ilomon10/embedded-totalizer-hour-meter/esp32/README.md

# Hour Meter Firmware (ESP32)

Engine hour meter and totalizer with persistent storage, real-time clock, and an IMU for vibration, orientation and compass heading. It talks to apps over USB or UART using compact [SensorFrame](../sensorframe/README.md) binary frames.

| You are… | Read |
|---|---|
| Building an app that talks to the device | **[docs/INTEGRATION-GUIDE.md](docs/INTEGRATION-GUIDE.md)** (self-contained, send it to third parties together with [SPEC.md](../sensorframe/SPEC.md)) |
| Writing a driver and need exact bytes | [docs/FRAME-CATALOG.md](docs/FRAME-CATALOG.md) (every frame, annotated hex dumps) |
| Developing without hardware | [simulator/](../simulator/README.md): a fake device on a virtual serial port (`cd ../simulator && bun run start`) |
| Wiring the hardware | [docs/WIRING.md](docs/WIRING.md) |
| Using the main board | the `can-board` build (below) and the board's [BRINGUP.md](../schematic/hour-meter-board/BRINGUP.md) |
| Working on the firmware | [docs/ARCHITECTURE.md](docs/ARCHITECTURE.md), [docs/CODING-STANDARD.md](docs/CODING-STANDARD.md) |
| A TypeScript developer new to C++ | [docs/CPP-FOR-TYPESCRIPT.md](docs/CPP-FOR-TYPESCRIPT.md) |
| Curious how data survives power cuts | [docs/STORAGE.md](docs/STORAGE.md), [docs/EEPROM-LAYOUT.md](docs/EEPROM-LAYOUT.md) |
| Setting up the IMU | [docs/CALIBRATION.md](docs/CALIBRATION.md) |
| Testing modules before soldering | [docs/TESTING-MODULES.md](docs/TESTING-MODULES.md) (bench firmware: `pio run -e bench -t upload`) |
| Configuring / watching the device | `hour-meter` TUI (`cd ../configurator && bun run start`, or `--demo` without hardware), see [configurator/README.md](../configurator/README.md) |

## Hardware

**Devboard** ([schematic](../schematic/hour-meter-devboard/README.md)), the default `esp32dev` build: ESP32 DevKit · AT24C256 EEPROM (0x50) · DS3231 RTC (0x68) · MPU9250 IMU (**0x69**, AD0 high) · alternator input GPIO27 · pulse input GPIO26 · UART GPIO16/17 · Bluetooth Classic SPP (off by default, PIN-locked).

**Main board** ([schematic](../schematic/hour-meter-board/README.md)): the same firmware, built with `-e can-board`. The UART link runs on its RS232 port (GPIO32 TX, GPIO34 RX), the GPS socket's GPIO16/17 are left alone, and the IMU readings are turned 180° into the board's axes. Its CAN, RS485, GPS, AIN1, DOUT1 and LIS3MDL compass are not used yet. Both boards' pins are in [include/BoardPins.h](include/BoardPins.h).

## Build, flash, run

```bash
cd esp32
pio run -e esp32dev -t upload      # build + flash (the devboard: ESP32 DevKit)
pio run -e can-board -t upload     # the same, for the main board
cd ../configurator                 # or use the hour-meter release binary
bun install                        # once
bun run start read /dev/ttyUSB0    # live view
bun run start set-time             # set the RTC from the PC clock (UTC)
bun run start get hour             # read the hour meter
bun run start                      # full-screen configurator + live viewer
```

Expected reader output:

```
2026-10-07T12:34:56.000Z #12 engine ON  run 1250.00 h total 15000 roll 0.4° pitch -1.2° heading 87.5° vib 35/120 mg
```

More commands: `hour-meter --help` (see [configurator/README.md](../configurator/README.md)).

## Test and check

```bash
pio test -e native           # unit tests on the PC with fake chips (ASan + UBSan)
pio check -e esp32dev        # clang-tidy static analysis
./scripts/check-docs.ts      # docs, host tag table and firmware tables agree; reference decoders work
cd ../configurator && bun run test     # host tool tests
```

## Project map

```
esp32/
├── platformio.ini        envs: esp32dev and can-board (firmware), bench, native (tests); strict warnings
├── include/              BoardPins.h (pins, I2C addresses, IMU mounting; per board) · AppConfig.h (fixed constants)
├── src/                  main.cpp · Application (wiring + main loop) · platform/ (Arduino adapters)
├── lib/
│   ├── Core/             Status, Result<T>, CHECK_ARG/TRY, IClock, PeriodicTask, Vec3
│   ├── I2cBus/           II2cBus interface + Wire implementation (timeouts, bus recovery)
│   ├── At24c/            EEPROM driver
│   ├── Ds3231/           RTC driver + UTC date math
│   ├── Mpu9250/          IMU + magnetometer driver
│   ├── Filters/          Kalman, compass, vibration, running stats
│   ├── Storage/          counter journal + settings A/B in EEPROM and in flash (FlashStore), StorageMirror
│   └── App/              protocol tags, settings schema, hour meter, IMU pipeline, commands, telemetry
├── test/                 fakes/ + test_drivers, test_storage, test_filters, test_app
├── scripts/check-docs.ts consistency checker (Bun)
└── docs/                 guides listed above
```
