ilomon10/embedded-totalizer-hour-meter/schematic/fault-analysis/plots/lm2596-pulse1.png

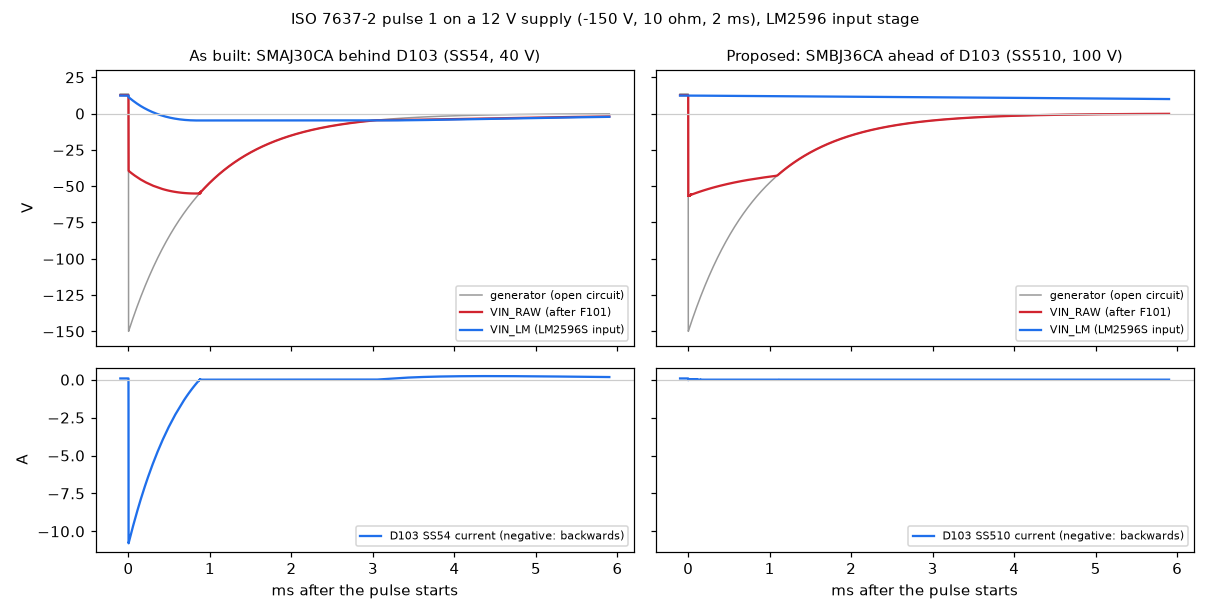
schematic/fault-analysis/plots/lm2596-pulse1.png
