ilomon10/embedded-totalizer-hour-meter/schematic/fault-analysis/plots/load-dump.png

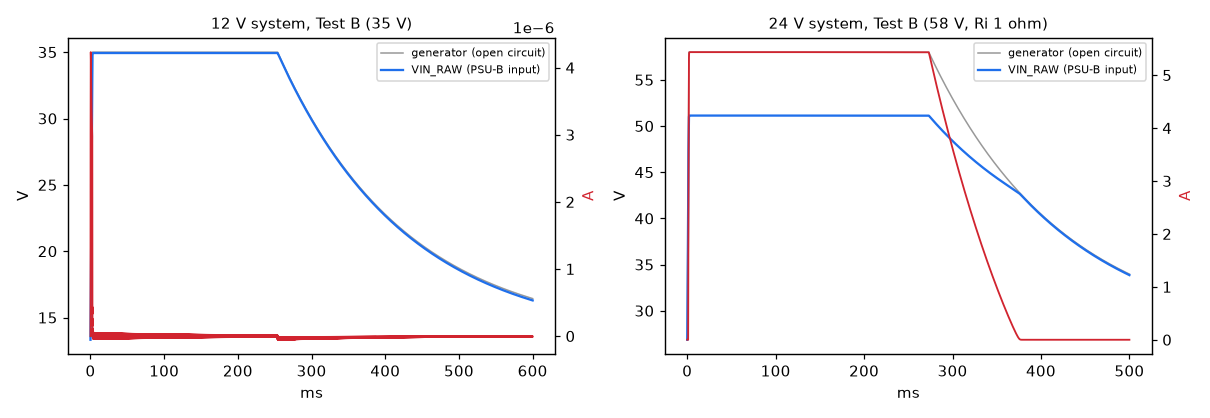
schematic/fault-analysis/plots/load-dump.png
