ilomon10/embedded-totalizer-hour-meter/schematic/fault-analysis/plots/opto-input.png

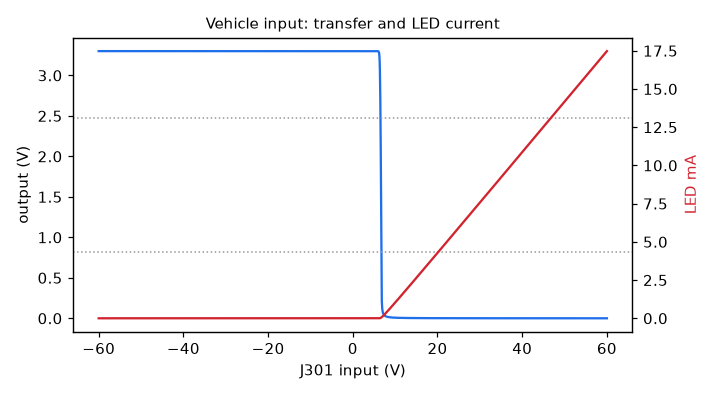
schematic/fault-analysis/plots/opto-input.png
