ilomon10/embedded-totalizer-hour-meter/schematic/hour-meter-devboard/hour-meter-devboard.png

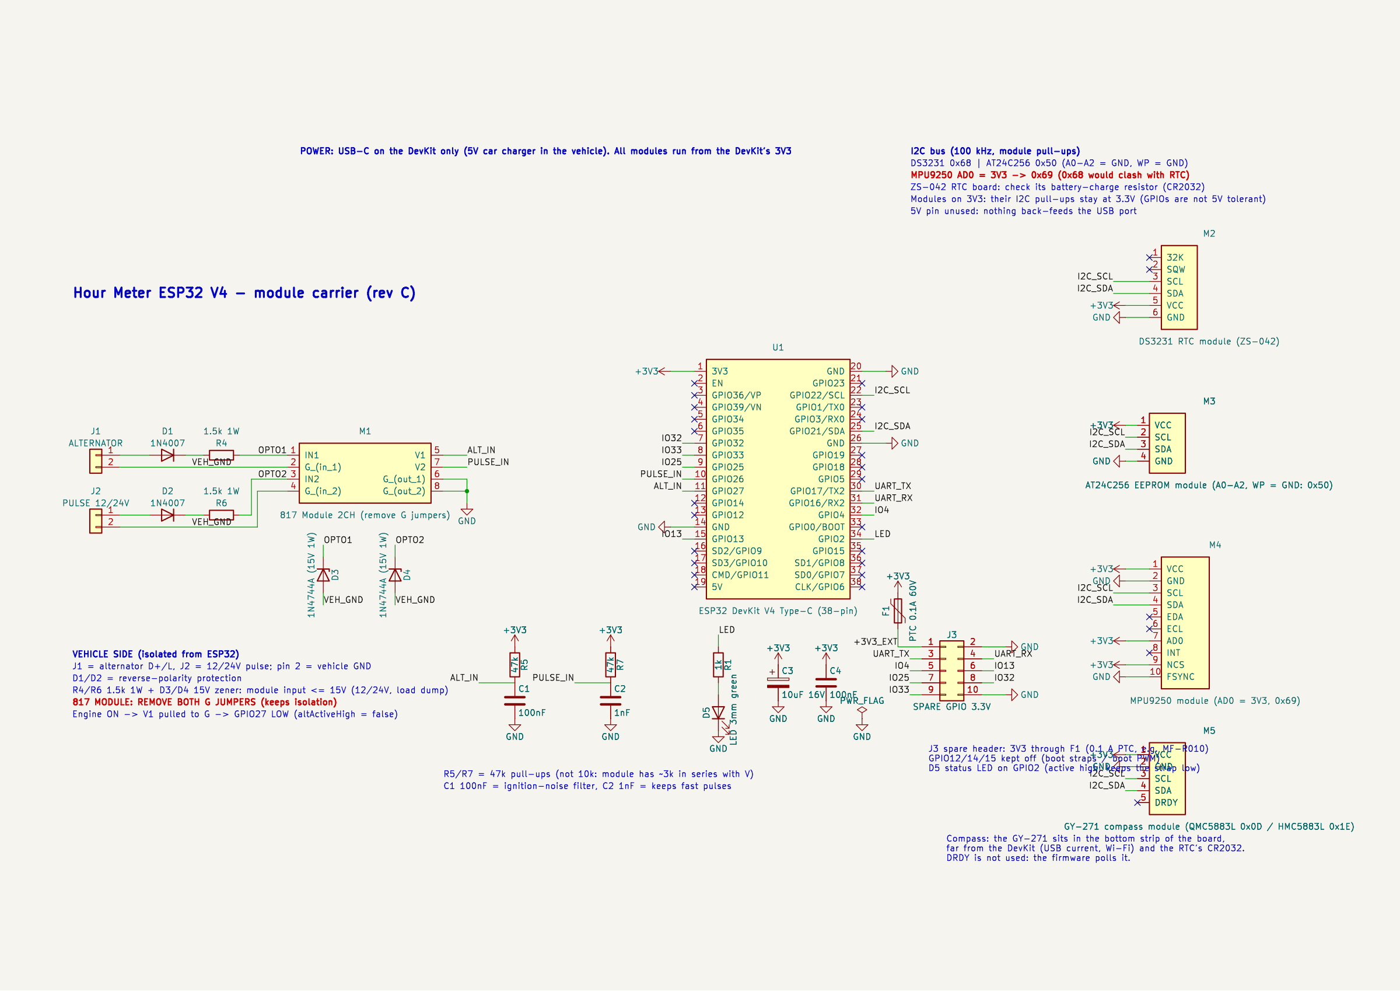
schematic/hour-meter-devboard/hour-meter-devboard.png
