ilomon10/embedded-totalizer-hour-meter/schematic/hour-meter-devboard/production/hour-meter-devboard-lcsc-parts.csv

References | Qty per board | LCSC C-number | Manufacturer | MPN | Key specs (pitch, size, rating) | LCSC stock (date seen) | MOQ | Order multiple | Unit price USD at that quantity | Qty to order for 5 boards | Line cost USD | LCSC URL | Fit note (footprint check)
C1, C4 | 2 | C342794 | TDK | FG28X7R1H104KNT06 | 100 nF 50 V X7R radial MLCC, 5.0 mm pitch; body 4.0 x 5.5 x 2.5 mm max; 0.5 mm leads | 6935 (2026-11-04) | 5 | 5 | 0.1213 | 10 | 1.21 | https://www.lcsc.com/product-detail/C342794.html | Fits C_Disc P5.00 (0.8 mm holes). Body 5.5 mm max, about 6 mm seated: fits under the DevKit (about 8 mm free)
C2 | 1 | C2170624 | VISHAY | K102J15C0GF5TH5 | 1 nF 50 V C0G radial MLCC, 5.0 mm pitch; size 15 (4.0 x 4.0 x 2.6 mm max), flat-crimp leads 0.5 mm | 11795 (2026-11-04) | 5 | 5 | 0.1236 | 5 | 0.62 | https://www.lcsc.com/product-detail/C2170624.html | Fits C_Disc P5.00. Max seated height 6.6 mm: fits under the DevKit
C3 | 1 | C216293 | huawei group | RL1E100MC110A00CV0 | 10 uF 25 V aluminium electrolytic, 105 C 2000 h, 5 x 11 mm, 2.0 mm pitch | 47380 (2026-11-04) | 20 | 20 | 0.0216 | 20 | 0.43 | https://www.lcsc.com/product-detail/C216293.html | Exact match for CP_Radial_D5.0mm_P2.00mm. 11 mm tall: must stay outside every module outline
D1, D2 | 2 | C106903 | ST(Semtech) | 1N4007 | 1N4007, 1 kV 1 A, DO-41 | 387380 (2026-11-04) | 20 | 20 | 0.0263 | 20 | 0.53 | https://www.lcsc.com/product-detail/C106903.html | DO-41 on the 10.16 mm footprint; leads 0.71-0.86 mm in 1.1 mm holes
D3, D4 | 2 | C238928 | onsemi | 1N4744A | 1N4744A zener 15 V 1 W, DO-41 glass | 6070 (2026-11-04) | 10 | 10 | 0.1019 | 10 | 1.02 | https://www.lcsc.com/product-detail/C238928.html | DO-41 footprint fits. onsemi part: its IZSM 304 mA rating is the one the fault analysis uses
D5 | 1 | C85161 | EVERLIGHT | 204-10SYGD/S530-E3 | 3 mm LED, yellow-green 573 nm, green diffused lens, Vf 2.0 V, 2.54 mm leads | 41540 (2026-11-04) | 20 | 20 | 0.0365 | 20 | 0.73 | https://www.lcsc.com/product-detail/C85161.html | Fits LED_D3.0mm. GaP LED: about 1.4 mA from GPIO2 through R1 (1k). A 3.2 V InGaN 'emerald green' LED would barely light at 3.3 V
F1 | 1 | C89660 | BOURNS | MF-R010 | PTC resettable fuse 100 mA hold / 200 mA trip, 60 V; radial 5.1 +/-0.7 mm; leads 0.51 mm; 7.4 W x 12.7 H x 3.1 T mm max | 2145 (2026-11-04) | 5 | 5 | 0.1277 | 5 | 0.64 | https://www.lcsc.com/product-detail/C89660.html | Fits PTC_Radial_P5.00mm (0.9 mm holes). 12.7 mm tall: keep outside module outlines
R1 | 1 | C172895 | YAGEO | MFR-12FTE52-1K | 1 kohm 1 % metal film, 1/6 W (167 mW), body D1.9 x L3.4 mm | 3300 (2026-11-04) | 100 | 100 | 0.0081 | 100 | 0.81 | https://www.lcsc.com/product-detail/C172895.html | Easy bend on the 7.62 mm DIN0207 footprint; dissipates about 2 mW. A 1/4 W MFR-25 (6.3 +/-0.5 mm body) leaves only 0.4-0.9 mm per side for the bend
R4, R6 | 2 | C2903196 | VO | MF1W-1K5±1%-TT63 | 1.5 kohm 1 % 1 W metal film, D4.5 x L11 mm, 0.6 mm leads | 13080 (2026-11-04) | 20 | 20 | 0.0335 | 20 | 0.67 | https://www.lcsc.com/product-detail/C2903196.html | Fits R_Axial_DIN0414 P15.24 (1.2 mm holes), 2 mm per side for the bend
R5, R7 | 2 | C172905 | YAGEO | MFR-12FTE52-47K | 47 kohm 1 % metal film, 1/6 W, body D1.9 x L3.4 mm | 4950 (2026-11-04) | 50 | 50 | 0.0095 | 50 | 0.47 | https://www.lcsc.com/product-detail/C172905.html | Same fit as R1; dissipates 0.23 mW (pull-up)
J1, J2 | 2 | C474952 | Cixi Kefa Elec | KF128-5.08-2P-AA | 2-pin screw terminal, 5.08 mm pitch, horizontal wire entry, 2.5 mm2 / 12-22 AWG, 14.1 mm tall, pins 0.9 x 0.8 mm | 51950 (2026-11-04) | 5 | 5 | 0.1948 | 10 | 1.95 | https://www.lcsc.com/product-detail/C474952.html | True 5.08 mm pitch. Pins (1.2 mm across corners) enter the footprint's 1.3 mm holes; Kefa asks for 1.4 mm, so it is snug. Body 10.7 mm deep vs 9.8 mm on the MKDS footprint. Exact original: Phoenix MKDS 1,5/ 2-5,08 = C5183929 (about $0.41 each). KF301-5.0-2P C474881 also fits (1.0 mm round pins, 5.0 mm pitch)
J3 | 1 | C42431818 | JXTCONN | PZ2.54-2X5P-H25 | 2x5 male pin header, 2.54 mm, straight, 6 mm mating pins | 24230 (2026-11-04) | 10 | 10 | 0.0538 | 10 | 0.54 | https://www.lcsc.com/product-detail/C42431818.html | Fits PinHeader_2x05_P2.54mm (1.0 mm holes)
U1 sockets | 2 | C2932678 | kinghelm | KH-2.54FH-1X19P-H8.5 | 1x19 female header, 2.54 mm, 8.5 mm tall | 1970 (2026-11-04) | 5 | 5 | 0.1935 | 10 | 1.94 | https://www.lcsc.com/product-detail/C2932678.html | Exact 19 pins, nothing to cut; 8.5 mm height as the README assumes
M2 socket | 1 | C40877 | BOOMELE(Boom Precision Elec) | 2.54-1*6P | 1x6 female header, 2.54 mm, 8.5 mm tall | 71490 (2026-11-04) | 5 | 5 | 0.0892 | 5 | 0.45 | https://www.lcsc.com/product-detail/C40877.html | 8.5 mm height
M3 socket | 1 | C2905415 | kinghelm | KH-2.54FH-1X4P-H8.5 | 1x4 female header, 2.54 mm, 8.5 mm tall | 1150 (2026-11-04) | 5 | 5 | 0.0843 | 5 | 0.42 | https://www.lcsc.com/product-detail/C2905415.html | 8.5 mm height
M4 socket | 1 | C2905418 | kinghelm | KH-2.54FH-1X10P-H8.5 | 1x10 female header, 2.54 mm, 8.5 mm tall | 8300 (2026-11-04) | 5 | 5 | 0.1275 | 5 | 0.64 | https://www.lcsc.com/product-detail/C2905418.html | 8.5 mm height
M5 socket | 1 | C42431843 | JXTCONN | PM2.54-1X5PM-H85 | 1x5 female header, 2.54 mm, 8.5 mm tall | 1390 (2026-11-04) | 5 | 5 | 0.0999 | 5 | 0.50 | https://www.lcsc.com/product-detail/C42431843.html | 8.5 mm height (Kinghelm's 1x5 is out of stock)
Module headers (M2, M3) | 1 | C2337 | BOOMELE(Boom Precision Elec) | 2.54-1*40P | 1x40 male pin header, 2.54 mm, straight, 6 mm mating pins | 60075 (2026-11-04) | 5 | 5 | 0.1607 | 5 | 0.80 | https://www.lcsc.com/product-detail/C2337.html | Cut 6 + 4 per board
M1 standoffs | 4 | C123697 | HIWA | HP-12M3*12 | Nylon hex standoff M3 female-female, 12 mm, 5.5 mm hex | 60 (2026-11-04) | 20 | 20 | 0.0229 | 20 | 0.46 | https://www.lcsc.com/product-detail/C123697.html | 12 mm is inside the README's 10-12 mm. Two PF3-6N screws per standoff; no nuts needed. Low stock (60)
M1 standoff screws | 8 | C194617 | HIWA | PF3-6N（M3*6) | Nylon M3 x 6 pan-head screw | 5760 (2026-11-04) | 20 | 20 | 0.0156 | 40 | 0.62 | https://www.lcsc.com/product-detail/C194617.html | 8 per board: both ends of each M1 standoff. The optional M4 standoffs need 2 more per board
D3, D4 (option) | 2 | C10184 | RUILON | P6KE18A | P6KE18A TVS 600 W unidirectional, DO-15: body 5.8-7.6 mm, leads 0.70-0.90 mm | 1985 (2026-11-04) | 5 | 5 | 0.0866 | 10 | 0.87 | https://www.lcsc.com/product-detail/C10184.html | OPTIONAL, only for old 24 V trucks without load-dump clamp. Leads fit the 1.1 mm holes; a 7.6 mm body leaves 1.3 mm per side on 10.16 mm pitch, so bend close to the body. Littelfuse C151208 does NOT fit (leads up to 1.09 mm, body up to 8.9 mm)
M4 standoffs (option) | 2 | C118174 | HIWA | TP-11 | Nylon hex standoff M3 male-female, 11 mm + 6 mm stud | 3140 (2026-11-04) | 20 | 20 | 0.0248 | 20 | 0.50 | https://www.lcsc.com/product-detail/C118174.html | OPTIONAL (holds the GY-9250 rigid). 11 mm = 8.5 mm socket + 2.5 mm header. Stud through the board, PN-3 nut underneath
M4 nuts (option) | 2 | C115937 | HIWA | PN-3 | Nylon 66 hex nut M3, 5.6 mm across flats | 20 (2026-11-04) | 20 | 20 | 0.0144 | 20 | 0.29 | https://www.lcsc.com/product-detail/C115937.html | OPTIONAL, for the TP-11 studs. LCSC holds only 20
CR2032 coin cell | 1 |  |  |  |  |  |  |  |  |  |  |  | Not on LCSC: only CR2032 holders are listed, no cells, and lithium cells are restricted for air freight. Buy locally
Hook-up wire 22-24 AWG, about 30 cm | 1 |  |  |  |  |  |  |  |  |  |  |  | Buy locally. LCSC sells wire only through its cable-assembly service
Enclosure screws H1, H3, H4 (+ H2 if kept) | 4 |  |  |  |  |  |  |  |  |  |  |  | Depends on the box. Buy locally, nylon or brass; HIWA PF3-8N nylon M3 x 8 (C194618, 1020 in stock) is an LCSC option
Modules U1, M1-M5 | 1 |  |  |  |  |  |  |  |  |  |  |  | Tokopedia/Shopee. LCSC has no clone modules. Espressif's own DevKitC boards are out of stock, or the 32UE needing an external antenna
TOTAL required, 5 boards |  |  |  |  |  |  |  |  |  |  | 15.45 |  | LCSC list prices seen 2026-11-04, before shipping
TOTAL optional lines |  |  |  |  |  |  |  |  |  |  | 1.66 |  | P6KE18A instead of D3/D4 (old 24 V trucks), GY-9250 standoffs + nuts; add 20 more M3x6 screws for the standoffs
