ilomon10/embedded-totalizer-hour-meter/schematic/hour-meter-board/production/BOM-hour-meter-board.csv

Comment | Designator | Footprint | LCSC | Qty
CR2032 | BT401 | Battery:BatteryHolder_MYOUNG_BS-07-A1BJ001_CR2032 | C2979167 | 1
100nF | C101,C105,C202,C204,C207,C301,C401,C402,C501,C601,C603,C605,C606,C701,C802,C902,C903,C904,C1001,C1002,C1101,C1102,C1103,C1105 | Capacitor_SMD:C_0603_1608Metric | C14663 | 24
220uF 50V | C102 | Capacitor_SMD:CP_Elec_10x10 | C2887271 | 1
100nF 50V | C103 | Capacitor_SMD:C_0603_1608Metric | C14663 | 1
220uF 16V | C104 | Capacitor_SMD:CP_Elec_6.3x7.7 | C2887273 | 1
10uF 25V | C201,C205 | Capacitor_SMD:C_0805_2012Metric | C15850 | 2
1uF | C203,C208,C604,C1104 | Capacitor_SMD:C_0603_1608Metric | C15849 | 4
22uF | C206 | Capacitor_SMD:C_0805_2012Metric | C45783 | 1
1nF | C302 | Capacitor_SMD:C_0603_1608Metric | C1588 | 1
10nF | C602 | Capacitor_SMD:C_0603_1608Metric | C57112 | 1
10nF 1kV | C901 | Capacitor_SMD:C_1206_3216Metric | C9194 | 1
SS34 | D101 | Diode_SMD:D_SMA | C8678 | 1
1N4148W | D102 | Diode_SMD:D_SOD-123 | C81598 | 1
SS54 | D103,D105 | Diode_SMD:D_SMA | C22452 | 2
SMAJ30CA | D104 | Diode_SMD:D_SMA | C110043 | 1
PWR red | D106 | LED_SMD:LED_0603_1608Metric | C2286 | 1
B5819W | D201 | Diode_SMD:D_SOD-123 | C8598 | 1
PWR (red) | D202 | LED_SMD:LED_0603_1608Metric | C2286 | 1
STATUS (yellow) | D203 | LED_SMD:LED_0603_1608Metric | C2287 | 1
M7 | D301,D303 | Diode_SMD:D_SMA | C82443 | 2
BZT52C4V7S | D302,D304 | Diode_SMD:D_SOD-323 | C22611 | 2
SZNUP3105LT1G | D701,D1001 | Package_TO_SOT_SMD:SOT-23 | C233434 | 2
P1 (green) | D801 | LED_SMD:LED_Kingbright_APA1606_1.6x0.6mm_Horizontal | C364567 | 1
P2 (green) | D802 | LED_SMD:LED_Kingbright_APA1606_1.6x0.6mm_Horizontal | C364567 | 1
USER (green) | D803 | LED_SMD:LED_Kingbright_APA1606_1.6x0.6mm_Horizontal | C364567 | 1
BAV99 | D901 | Package_TO_SOT_SMD:SOT-23 | C68983 | 1
0.5A 60V | F101 | Fuse:Fuse_1812_4532Metric | C19078719 | 1
0.5A 6V | F201 | Fuse:Fuse_1206_3216Metric | C69688 | 1
0.2A | F801,F803 | Fuse:Fuse_1206_3216Metric | C20984 | 2
Micro-Fit 3.0 2x8 | J1 | Connector_Molex:Molex_Micro-Fit_3.0_43045-1600_2x08_P3.00mm_Horizontal | C277731 | 1
USB-C | J201 | Connector_USB:USB_C_Receptacle_HRO_TYPE-C-31-M-12 | C165948 | 1
GPS (GH 6-pin) | J802 | Connector_JST:JST_GH_SM06B-GHS-TB_1x06-1MP_P1.25mm_Horizontal | C133065 | 1
QWIIC | J803 | Connector_JST:JST_SH_SM04B-SRSS-TB_1x04-1MP_P1.00mm_Horizontal | C160404 | 1
33uH 3A | L101 | Inductor_SMD:L_12x12mm_H8mm | C9400 | 1
MMBT3904 | Q201,Q202 | Package_TO_SOT_SMD:SOT-23 | C20526 | 2
100k | R101 | Resistor_SMD:R_1206_3216Metric | C17900 | 1
5.6k | R102 | Resistor_SMD:R_0603_1608Metric | C23189 | 1
3.3k | R103 | Resistor_SMD:R_0603_1608Metric | C22978 | 1
1k | R104,R209,R210 | Resistor_SMD:R_0603_1608Metric | C21190 | 3
2.2k | R105 | Resistor_SMD:R_0603_1608Metric | C4190 | 1
10k | R201,R202,R205,R206,R401,R501,R701,R702,R703 | Resistor_SMD:R_0603_1608Metric | C25804 | 9
470R | R203,R204 | Resistor_SMD:R_0603_1608Metric | C23179 | 2
5.1k | R207,R208 | Resistor_SMD:R_0603_1608Metric | C23186 | 2
4.7k | R211,R212,R304,R309 | Resistor_SMD:R_0603_1608Metric | C23162 | 4
0R | R213 | Resistor_SMD:R_0603_1608Metric | C21189 | 1
1k | R301,R302,R303,R306,R307,R308 | Resistor_SMD:R_1206_3216Metric | C4410 | 6
22k | R305,R310 | Resistor_SMD:R_0603_1608Metric | C31850 | 2
120R | R704,R1001 | Resistor_SMD:R_0805_2012Metric | C17437 | 2
330R | R705,R706,R808,R809,R810 | Resistor_SMD:R_0603_1608Metric | C23138 | 5
100R | R803,R804,R805 | Resistor_SMD:R_0603_1608Metric | C22775 | 3
100k | R806,R807,R905 | Resistor_SMD:R_0603_1608Metric | C25803 | 3
49.9k 0.1% | R901,R902 | Resistor_SMD:R_1206_3216Metric | C706414 | 2
10k 0.1% | R903 | Resistor_SMD:R_0603_1608Metric | C95204 | 1
RESET | SW201 | Button_Switch_SMD:SW_Push_1P1T_XKB_TS-1187A | C318884 | 1
BOOT | SW202 | Button_Switch_SMD:SW_Push_1P1T_XKB_TS-1187A | C318884 | 1
LM2596S-ADJ | U101 | Package_TO_SOT_SMD:TO-263-5_TabPin3 | C347423 | 1
ESP32-WROOM-32E-N4 | U201 | RF_Module:ESP32-WROOM-32E | C701341 | 1
CH340C | U202 | Package_SO:SOIC-16_3.9x9.9mm_P1.27mm | C84681 | 1
USBLC6-2SC6 | U203 | Package_TO_SOT_SMD:SOT-23-6 | C7519 | 1
AMS1117-3.3 | U204 | Package_TO_SOT_SMD:SOT-223-3_TabPin2 | C6186 | 1
PC817C-S | U301,U302 | Package_DIP:SMDIP-4_W9.53mm | C3008369 | 2
DS3231MZ+TRL | U401 | Package_SO:SOIC-8_3.9x4.9mm_P1.27mm | C107410 | 1
AT24C256C-SSHL-T | U501 | Package_SO:SOIC-8_3.9x4.9mm_P1.27mm | C6482 | 1
MPU-6500 | U601 | Sensor_Motion:InvenSense_QFN-24_3x3mm_P0.4mm | C50278 | 1
LIS3MDLTR | U602 | Package_LGA:LGA-12_2x2mm_P0.5mm | C478483 | 1
THVD2410DR | U701 | Package_SO:SOIC-8_3.9x4.9mm_P1.27mm | C1849398 | 1
SRV05-4 | U802 | Package_TO_SOT_SMD:SOT-23-6 | C85364 | 1
ADS1115IDGST | U901 | Package_SO:TSSOP-10_3x3mm_P0.5mm | C468683 | 1
SN74AHCT1G125DBVR | U902 | Package_TO_SOT_SMD:SOT-23-5 | C7484 | 1
BSP75N | U903 | Package_TO_SOT_SMD:SOT-223 | C172450 | 1
TJA1051T/3 | U1001 | Package_SO:SOIC-8_3.9x4.9mm_P1.27mm | C38695 | 1
MAX13223E | U1101 | Package_SO:TSSOP-20_4.4x6.5mm_P0.65mm | C118523 | 1
