ilomon10/embedded-totalizer-hour-meter/schematic/hour-meter-devboard/hour-meter-devboard.pdf

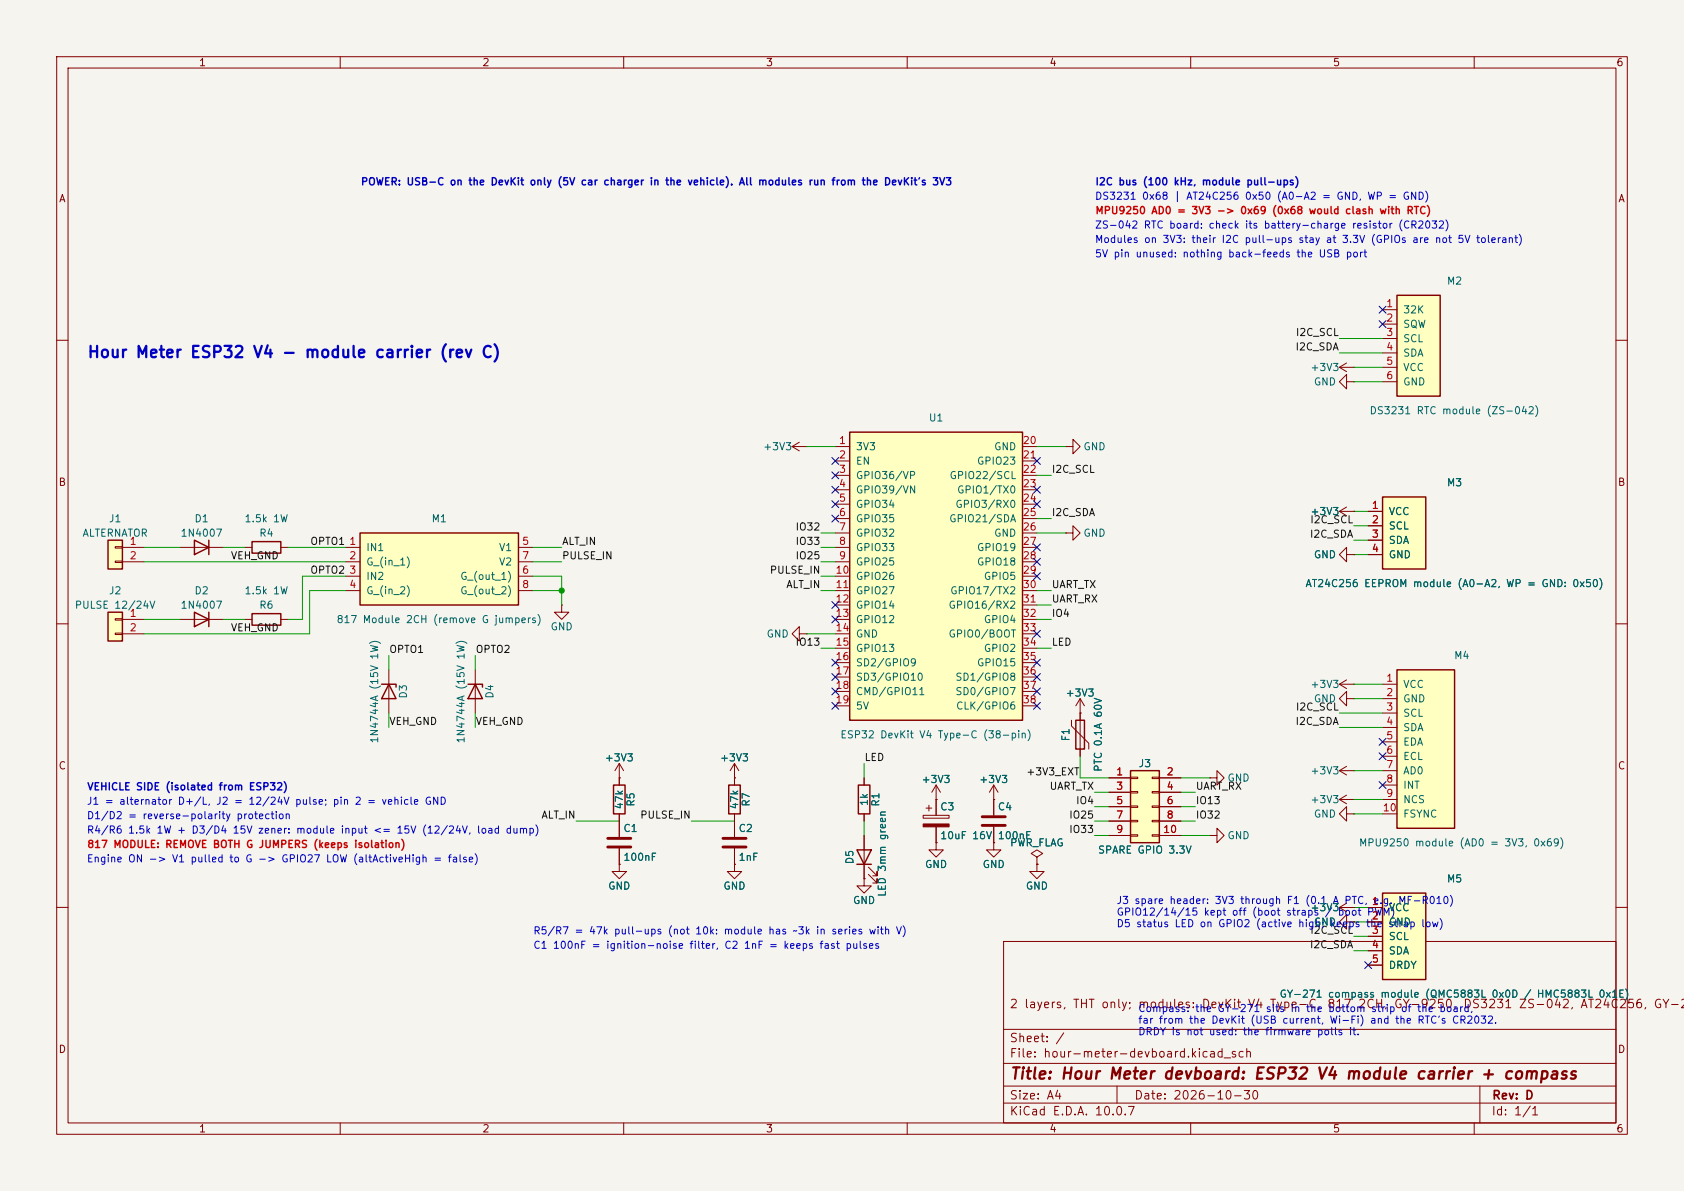
[picture p11: page 1]

ZS-042 RTC board: check its battery-charge resistor (CR2032) DS3231 0x68 | AT24C256 0x50 (A0-A2 = GND, WP = GND) MPU9250 AD0 = 3V3 -> 0x69 (0x68 would clash with RTC) 5V pin unused: nothing back-feeds the USB port

Modules on 3V3: their I2C pull-ups stay at 3.3V (GPIOs are not 5V tolerant)

AT24C256 EEPROM module (A0-A2, WP = GND: 0x50) 32K 1

AT24C256 EEPROM module (A0-A2, WP = GND: 0x50) VCC 1

VEHICLE SIDE (isolated from ESP32) J1 = alternator D+/L, J2 = 12/24V pulse; pin 2 = vehicle GND

D1/D2 = reverse-polarity protection
R4/R6 1.5k 1W + D3/D4 15V zener: module input <= 15V (12/24V, load dump)
Engine ON -> V1 pulled to G -> GPIO27 LOW (altActiveHigh = false)

J3 spare header: 3V3 through F1 (0.1 A PTC, e.g. MF-R010)

R5/R7 = 47k pull-ups (not 10k: module has ~3k in series with V)

Sheet: /
File: hour-meter-devboard.kicad_sch
Title: Hour Meter devboard: ESP32 V4 module carrier + compass

Size: A4 | Rev: D
KiCad E.D.A. 10.0.7 | Id: 1/1
