ilomon10/embedded-totalizer-hour-meter/schematic/hour-meter-devboard/production/hour-meter-devboard-fit-check-1to1.pdf

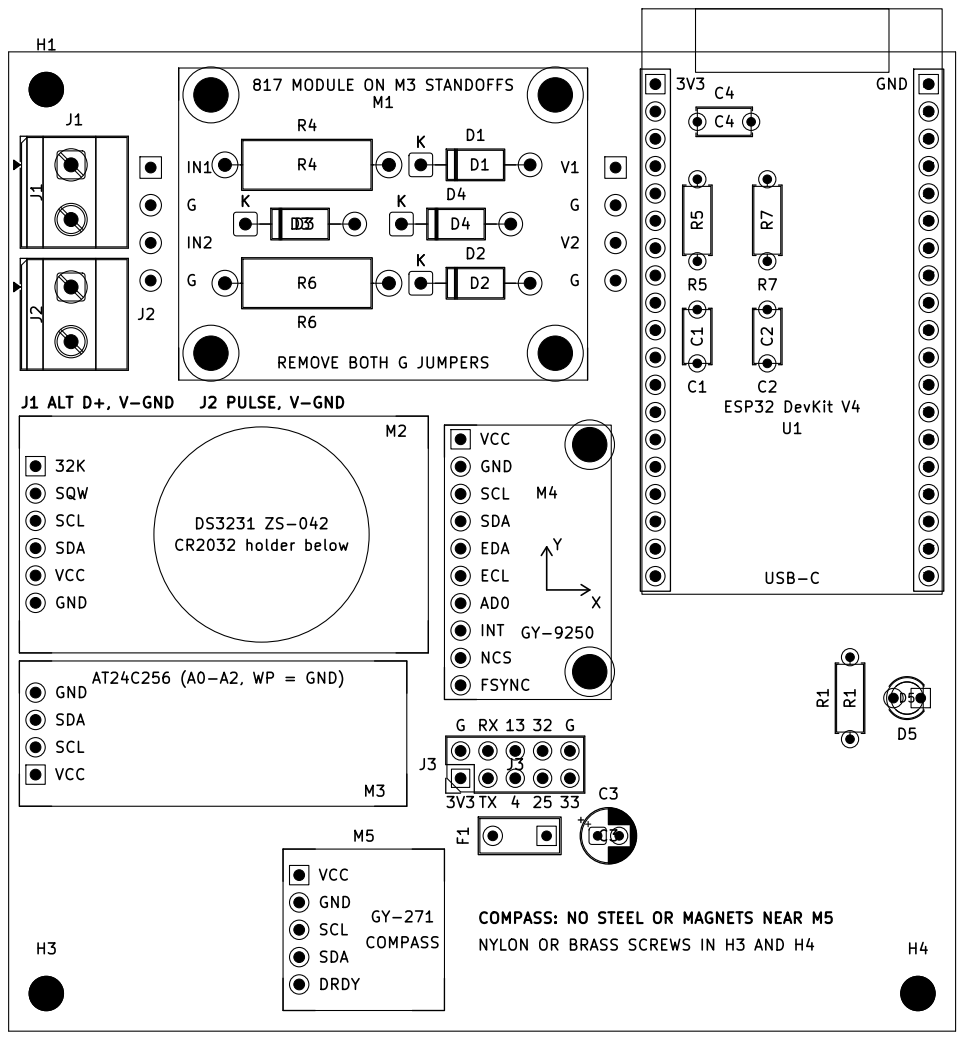
[picture p12: page 1]

817 MODULE ON M3 STANDOFFS REMOVE BOTH G JUMPERS

COMPASS: NO STEEL OR MAGNETS NEAR M5 F1
