ilomon10/embedded-totalizer-hour-meter/schematic/hour-meter-devboard/hour-meter-devboard.kicad_pcb

## KiCad design schematic/hour-meter-devboard/hour-meter-devboard.kicad_pcb (2026-11-04)

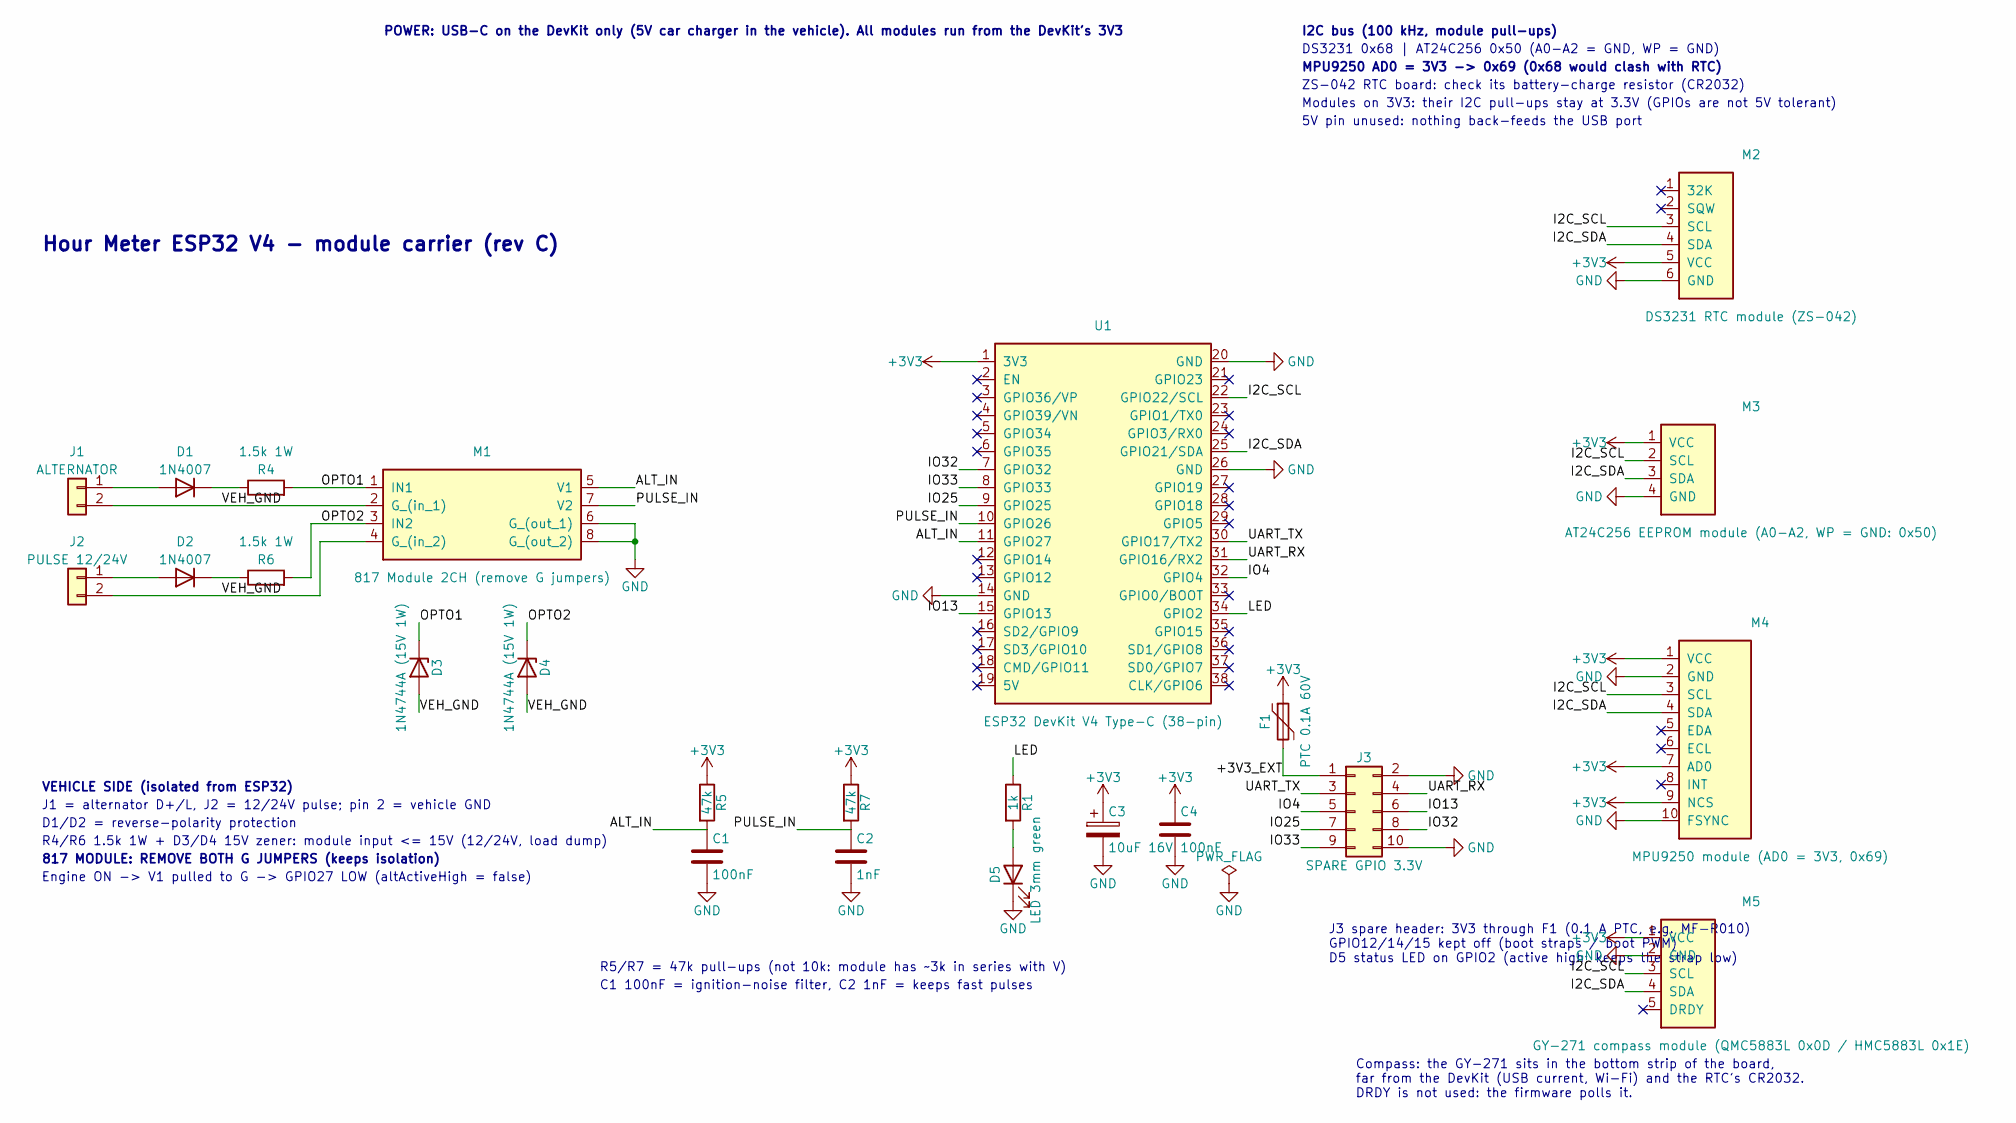
[picture p13: schematic hour-meter-devboard.kicad_sch, Hour Meter devboard: ESP32 V4 module carrier + compass]

Parts:
C1, C4: 100nF; C_Disc_D5.0mm_W2.5mm_P5.00mm
C2: 1nF; C_Disc_D5.0mm_W2.5mm_P5.00mm
C3: 10uF 16V; CP_Radial_D5.0mm_P2.00mm
D1, D2: 1N4007; D_DO-41_SOD81_P10.16mm_Horizontal
D3, D4: 1N4744A (15V 1W); D_DO-41_SOD81_P10.16mm_Horizontal
D5: LED 3mm green; LED_D3.0mm
F1: PTC 0.1A 60V; PTC_Radial_P5.00mm
J1: ALTERNATOR; TerminalBlock_Phoenix_MKDS-1,5-2-5.08_1x02_P5.08mm_Horizont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
J2: PULSE 12/24V; TerminalBlock_Phoenix_MKDS-1,5-2-5.08_1x02_P5.08mm_Horizont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
J3: SPARE GPIO 3.3V; PinHeader_2x05_P2.54mm_Vertical
M1: 817 Module 2CH (remove G jumpers); Module_PC817_2CH_Stacked
M2: DS3231 RTC module (ZS-042); Module_DS3231_ZS042_Flat
M3: AT24C256 EEPROM module (A0-A2, WP = GND: 0x50); Module_AT24C256_Flat
M4: MPU9250 module (AD0 = 3V3, 0x69); Module_MPU9250_GY9250_Flat
M5: GY-271 compass module (QMC5883L 0x0D / HMC5883L 0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; Module_GY271_Flat
R1: 1k; R_Axial_DIN0207_L6.3mm_D2.5mm_P7.62mm_Horizontal
R4, R6: 1.5k 1W; R_Axial_DIN0414_L11.9mm_D4.5mm_P15.24mm_Horizontal
R5, R7: 47k; R_Axial_DIN0207_L6.3mm_D2.5mm_P7.62mm_Horizontal
U1: ESP32 DevKit V4 Type-C (38-pin); ESP32_DevKitC_V4_38pin_Socket

Connections:
+3V3: C3.1, C4.1, F1.1, M2.5 (VCC), M3.1 (VCC), M4.1 (VCC), M4.7 (AD0), M4.9 (NCS), M5.1 (VCC), R5.1, R7.1, U1.1 (3V3)
/+3V3_EXT: F1.2, J3.1
/ALT_IN: C1.1, M1.5 (V1), R5.2, U1.11 (GPIO27)
/I2C_SCL: M2.3 (SCL), M3.2 (SCL), M4.3 (SCL), M5.3 (SCL), U1.22 (GPIO22/SCL)
/I2C_SDA: M2.4 (SDA), M3.3 (SDA), M4.4 (SDA), M5.4 (SDA), U1.25 (GPIO21/SDA)
/IO4: J3.5, U1.32 (GPIO4)
/IO13: J3.6, U1.15 (GPIO13)
/IO25: J3.7, U1.9 (GPIO25)
/IO32: J3.8, U1.7 (GPIO32)
/IO33: J3.9, U1.8 (GPIO33)
/LED: R1.1, U1.34 (GPIO2)
/OPTO1: D3.1 (K), M1.1 (IN1), R4.2
/OPTO2: D4.1 (K), M1.3 (IN2), R6.2
/PULSE_IN: C2.1, M1.7 (V2), R7.2, U1.10 (GPIO26)
/UART_RX: J3.4, U1.31 (GPIO16/RX2)
/UART_TX: J3.3, U1.30 (GPIO17/TX2)
/VEH_GND: D3.2 (A), D4.2 (A), J1.2, J2.2, M1.2 (G_(in_1)), M1.4 (G_(in_2))
GND: C1.2, C2.2, C3.2, C4.2, D5.1 (K), J3.2, J3.10, M1.6 (G_(out_1)), M1.8 (G_(out_2)), M2.6 (GND), M3.4 (GND), M4.2 (GND), M4.10 (FSYNC), M5.2 (GND), U1.14 (GND), U1.20 (GND), U1.26 (GND)
unnamed: D1.2 (A), J1.1
unnamed: D1.1 (K), R4.1
unnamed: D2.2 (A), J2.1
unnamed: D2.1 (K), R6.1
unnamed: D5.2 (A), R1.2

Notes on the sheet:
5V pin unused: nothing back-feeds the USB port
R4/R6 1.5k 1W + D3/D4 15V zener: module input <= 15V (12/24V, load dump)
MPU9250 AD0 = 3V3 -> 0x69 (0x68 would clash with RTC)
DS3231 0x68 | AT24C256 0x50 (A0-A2 = GND, WP = GND)
817 MODULE: REMOVE BOTH G JUMPERS (keeps isolation)
R5/R7 = 47k pull-ups (not 10k: module has ~3k in series with V)
ZS-042 RTC board: check its battery-charge resistor (CR2032)
Engine ON -> V1 pulled to G -> GPIO27 LOW (altActiveHigh = false)
J1 = alternator D+/L, J2 = 12/24V pulse; pin 2 = vehicle GND
POWER: USB-C on the DevKit only (5V car charger in the vehicle). All modules run from the DevKit's 3V3
D1/D2 = reverse-polarity protection
C1 100nF = ignition-noise filter, C2 1nF = keeps fast pulses
VEHICLE SIDE (isolated from ESP32)
Hour Meter ESP32 V4 - module carrier (rev C)
Modules on 3V3: their I2C pull-ups stay at 3.3V (GPIOs are not 5V tolerant)
I2C bus (100 kHz, module pull-ups)
J3 spare header: 3V3 through F1 (0.1 A PTC, e.g. MF-R010) GPIO12/14/15 kept off (boot straps / boot PWM) D5 status LED on GPIO2 (active high; keeps the strap low)
Compass: the GY-271 sits in the bottom strip of the board, far from the DevKit (USB current, Wi-Fi) and the RTC's CR2032. DRDY is not used: the firmware polls it.

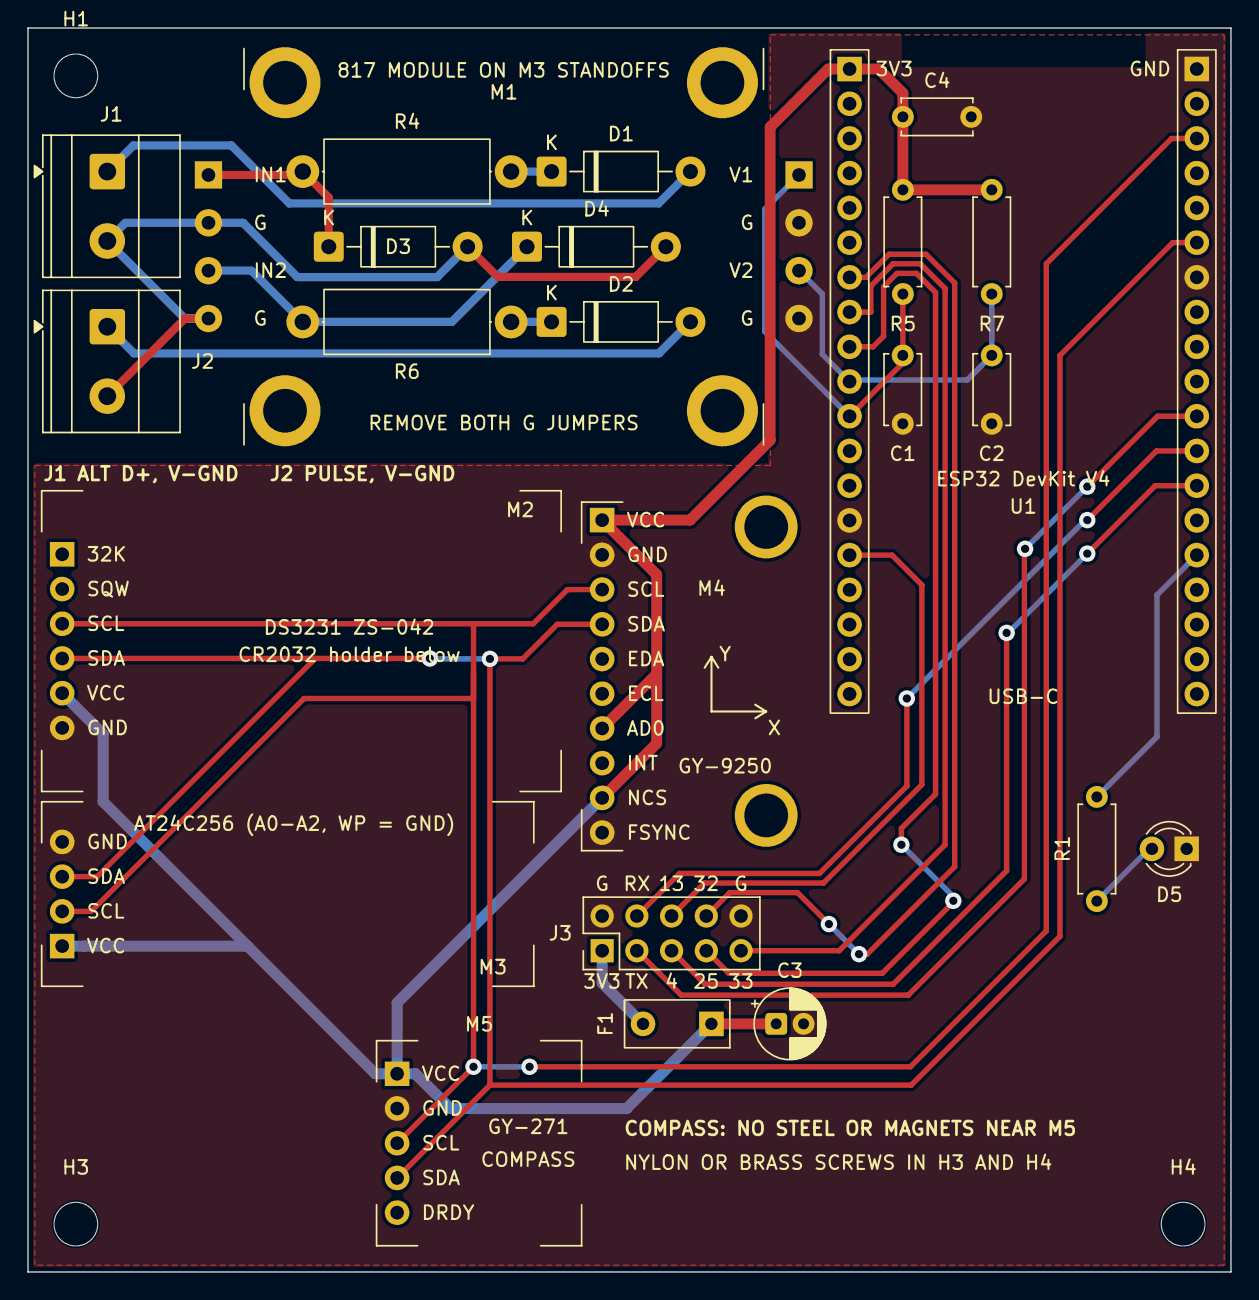
[picture p14: board hour-meter-devboard.kicad_pcb from above]

Board: 2 copper layers, 88.0 x 91.0 mm, 27 parts (0 on the bottom side), 23 nets.

Other parts of the board:
H1, H3, H4: MountingHole_3.2mm_M3
