ilomon10/embedded-totalizer-hour-meter/schematic/hour-meter-board/hour-meter-board.kicad_pcb

## KiCad design schematic/hour-meter-board/hour-meter-board.kicad_pcb (2026-11-04)

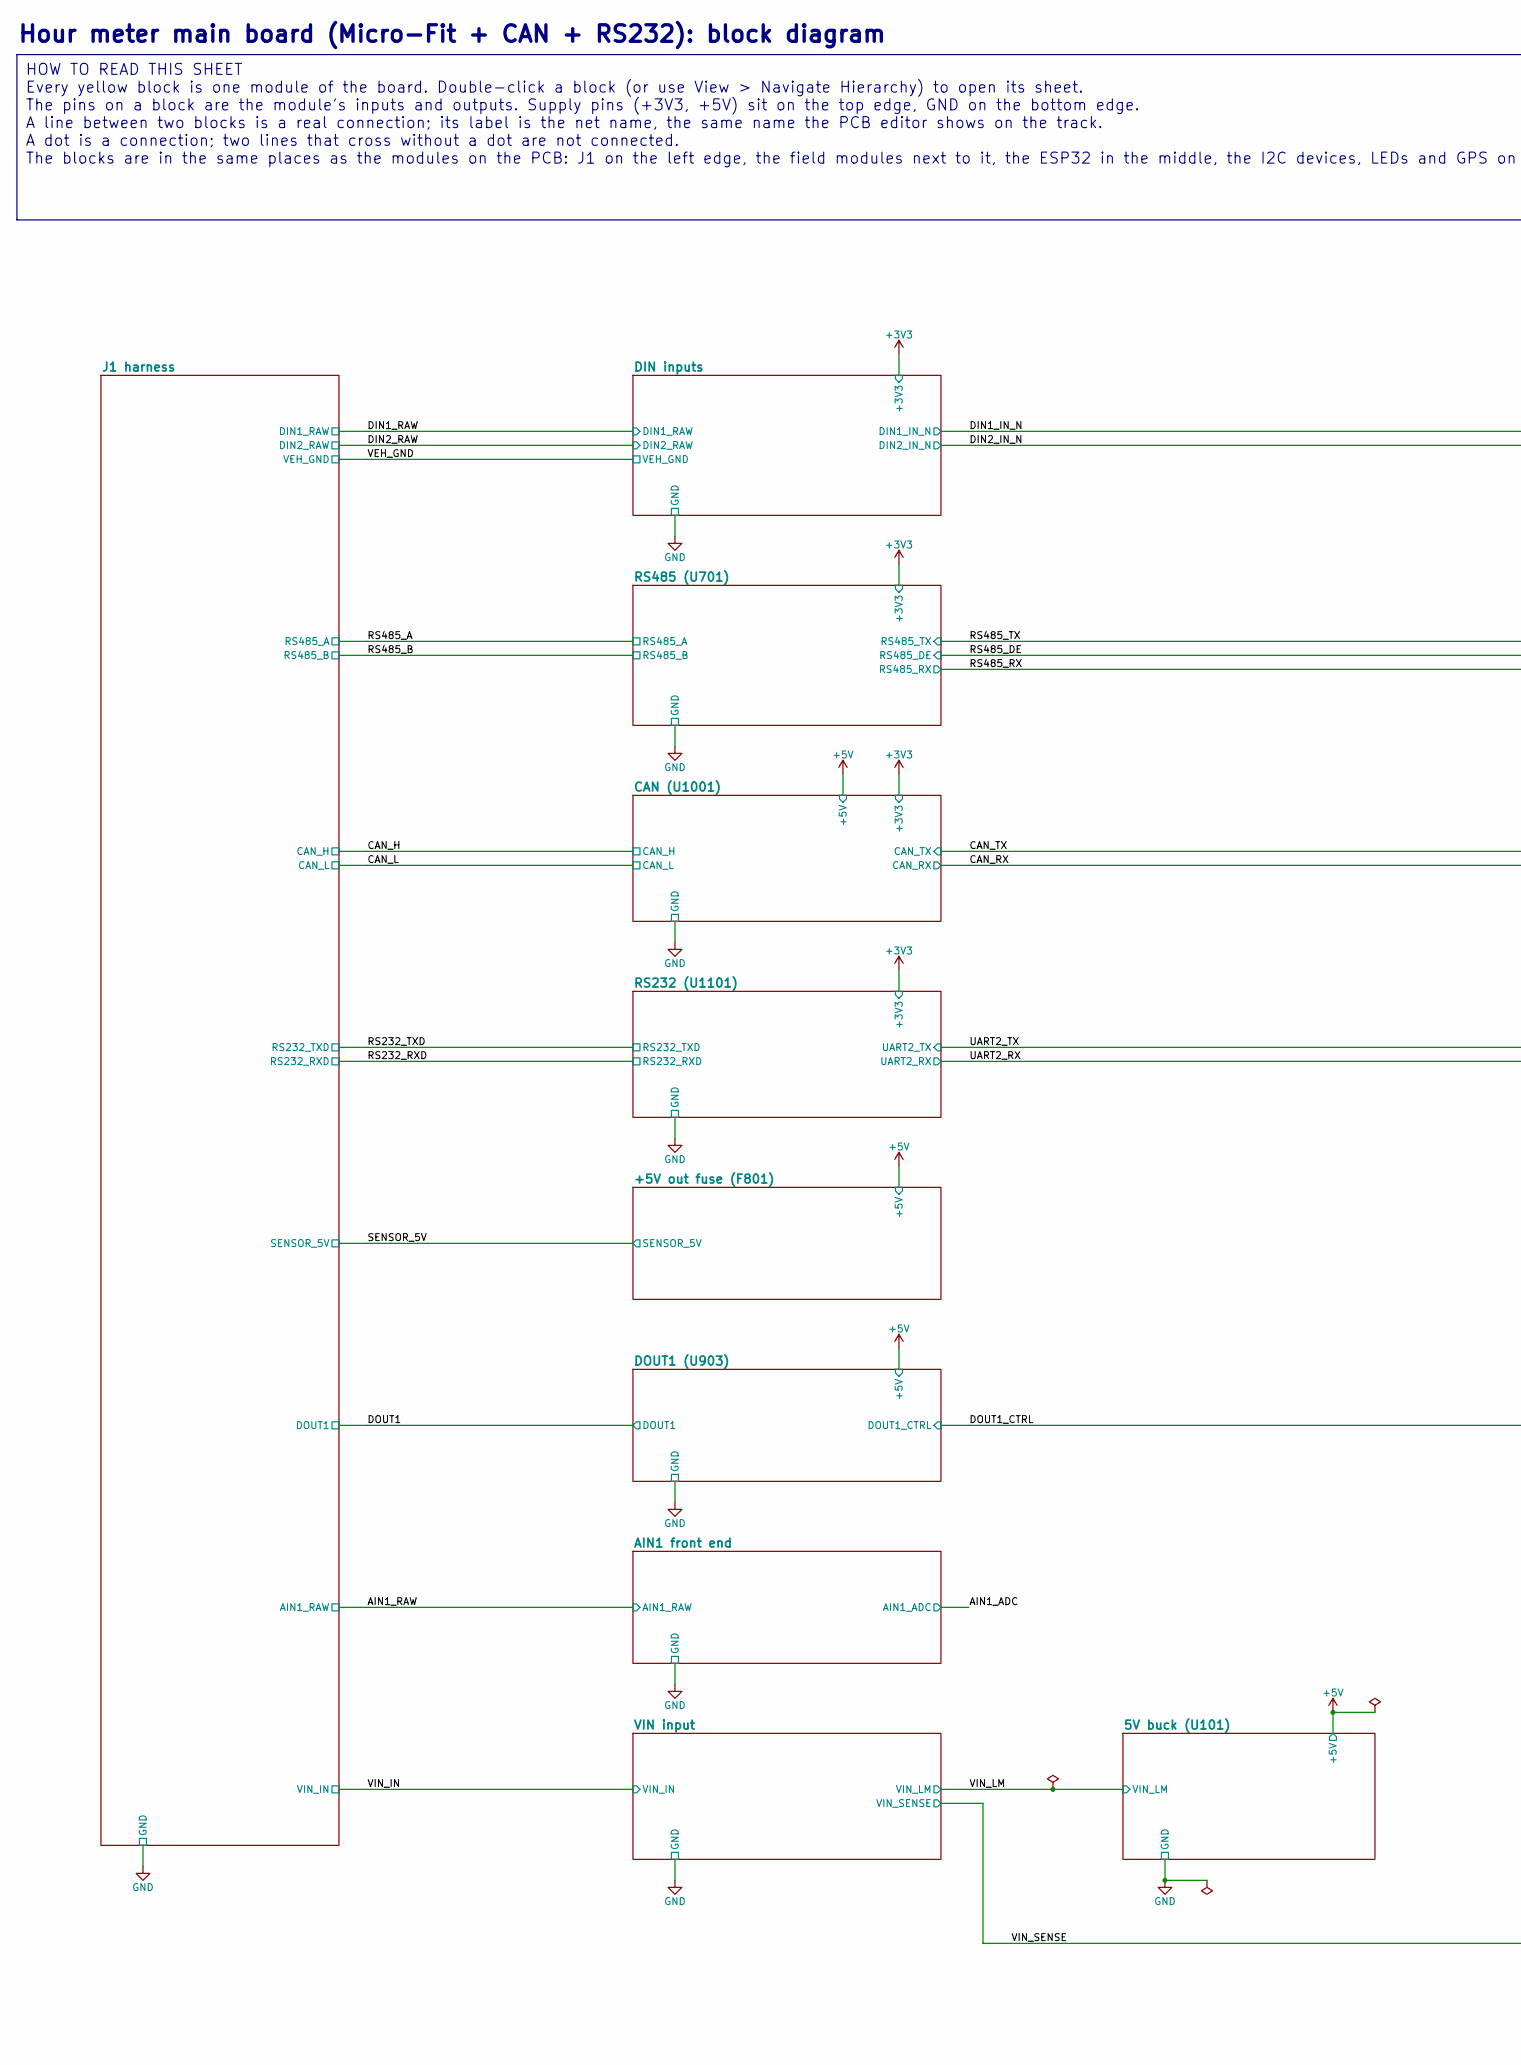
[picture p15: schematic hour-meter-board.kicad_sch, Hour meter board: block diagram, part in row 1, column 1]

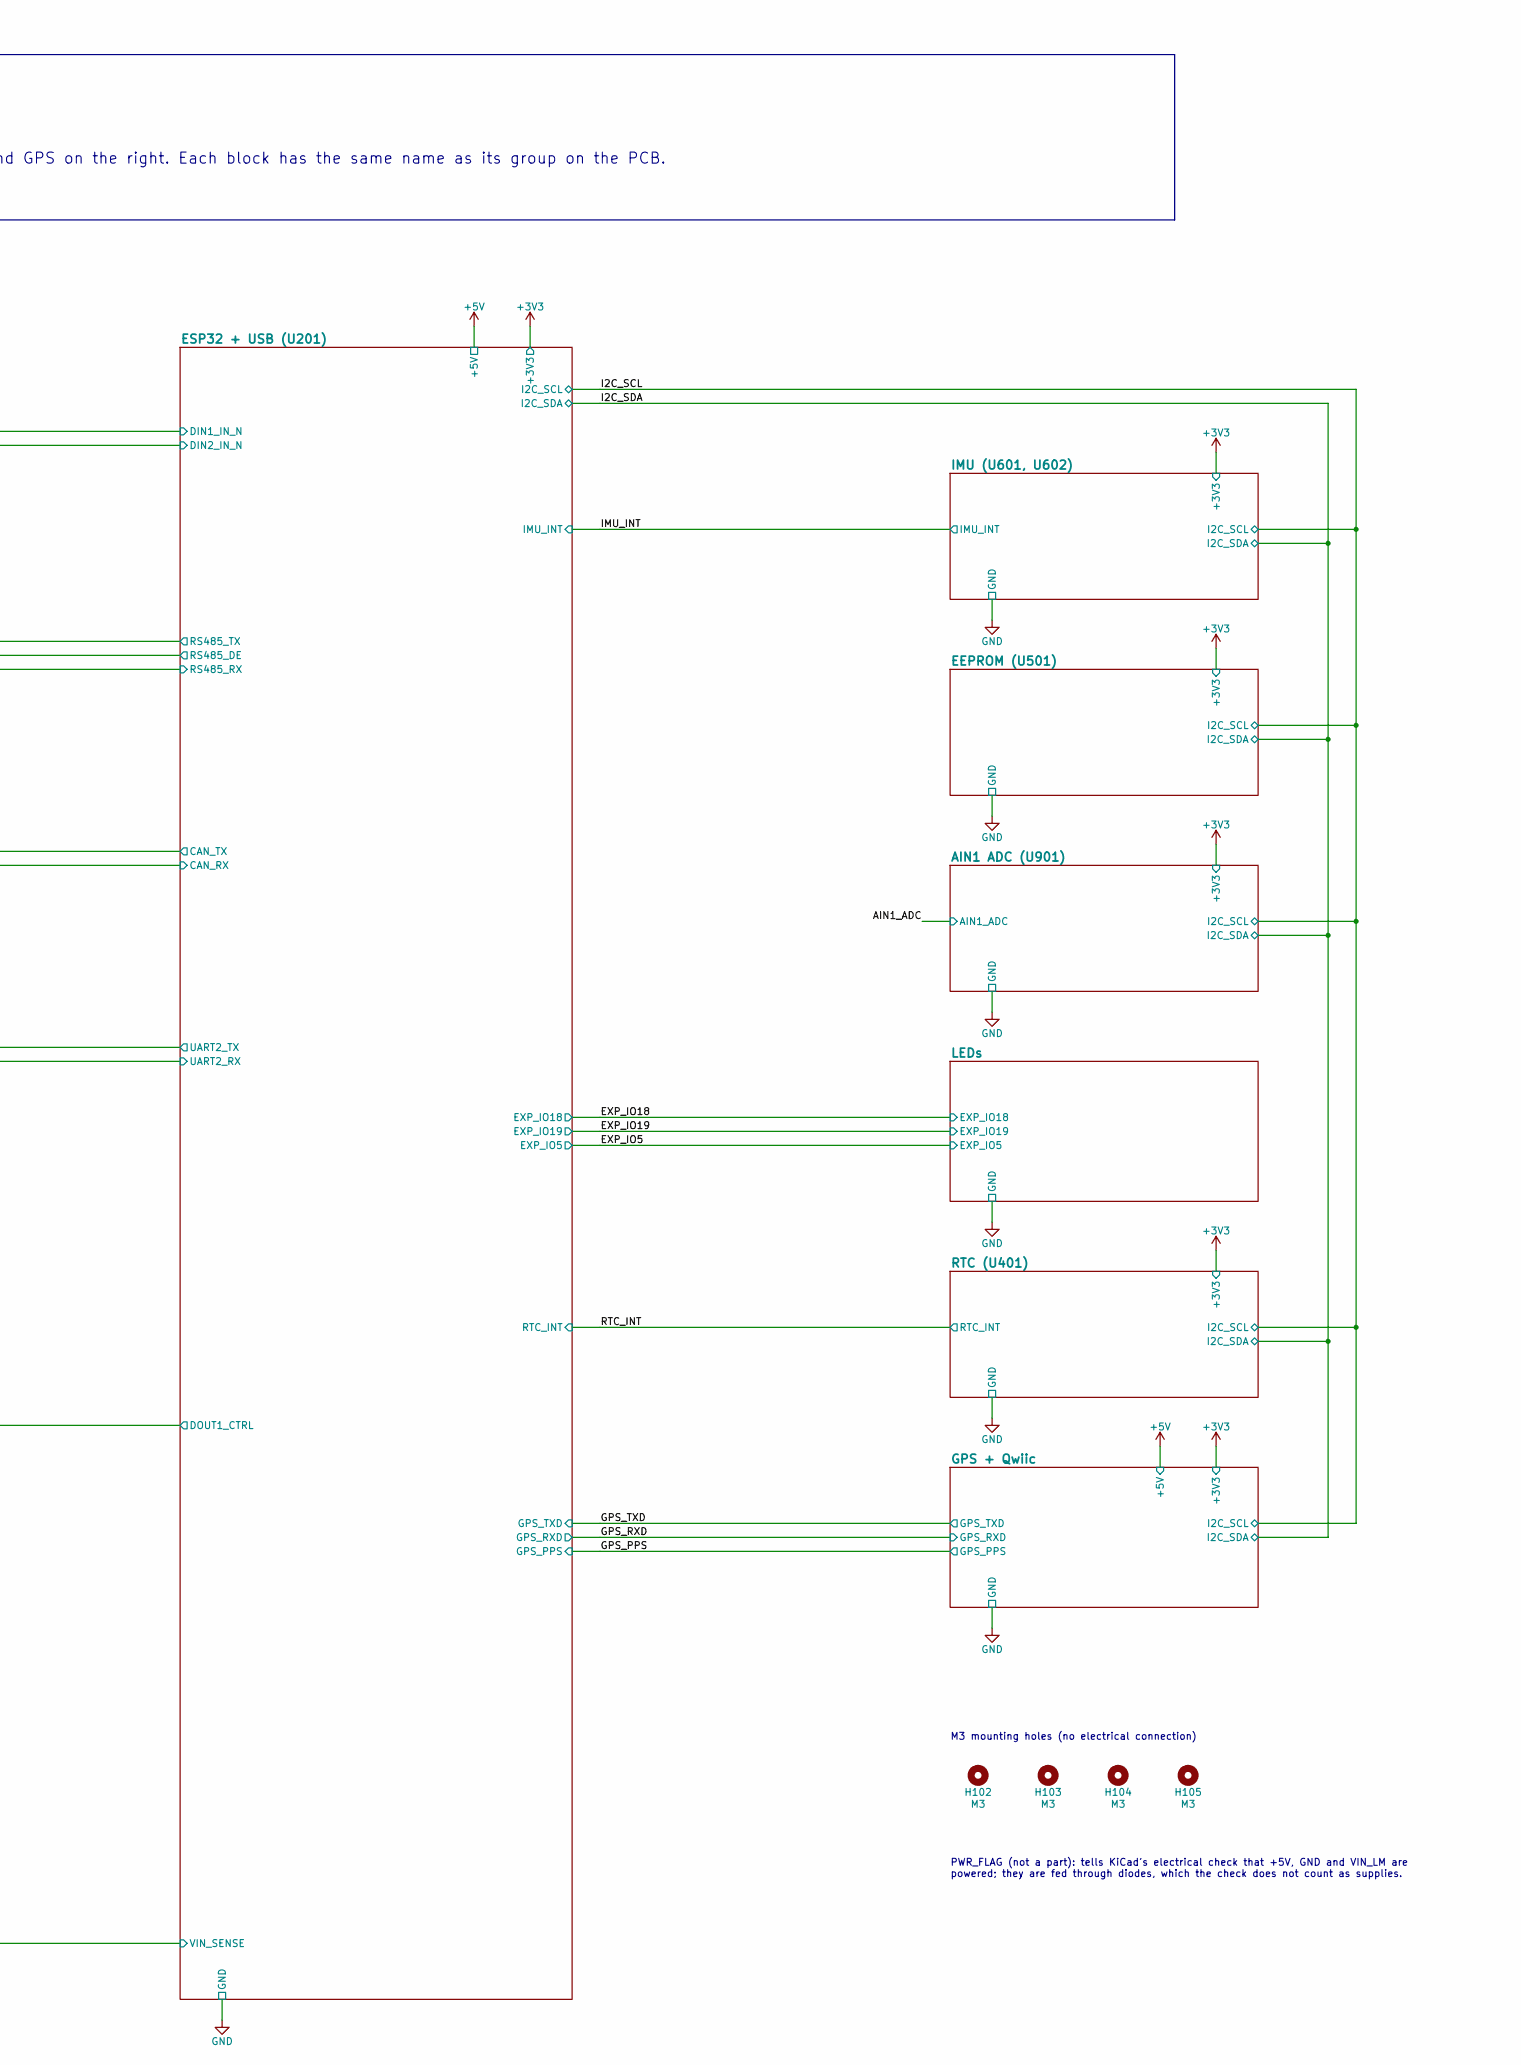
[picture p16: schematic hour-meter-board.kicad_sch, Hour meter board: block diagram, part in row 1, column 2]

Parts:
H102, H103, H104, H105: M3; MountingHole_3.2mm_M3

Notes on the sheet:
Hour meter main board (Micro-Fit + CAN + RS232): block diagram
HOW TO READ THIS SHEET Every yellow block is one module of the board. Double-click a block (or use View > Navigate Hierarchy) to open its sheet. The pins on a block are the module's inputs and outputs. Supply pins (+3V3, +5V) sit on the top edge, GND on the bottom edge. A line between two blocks is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
PWR_FLAG (not a part): tells KiCad's electrical check that +5V, GND and VIN_LM are powered; they are fed through diodes, which the check does not count as supplies.
M3 mounting holes (no electrical connection)

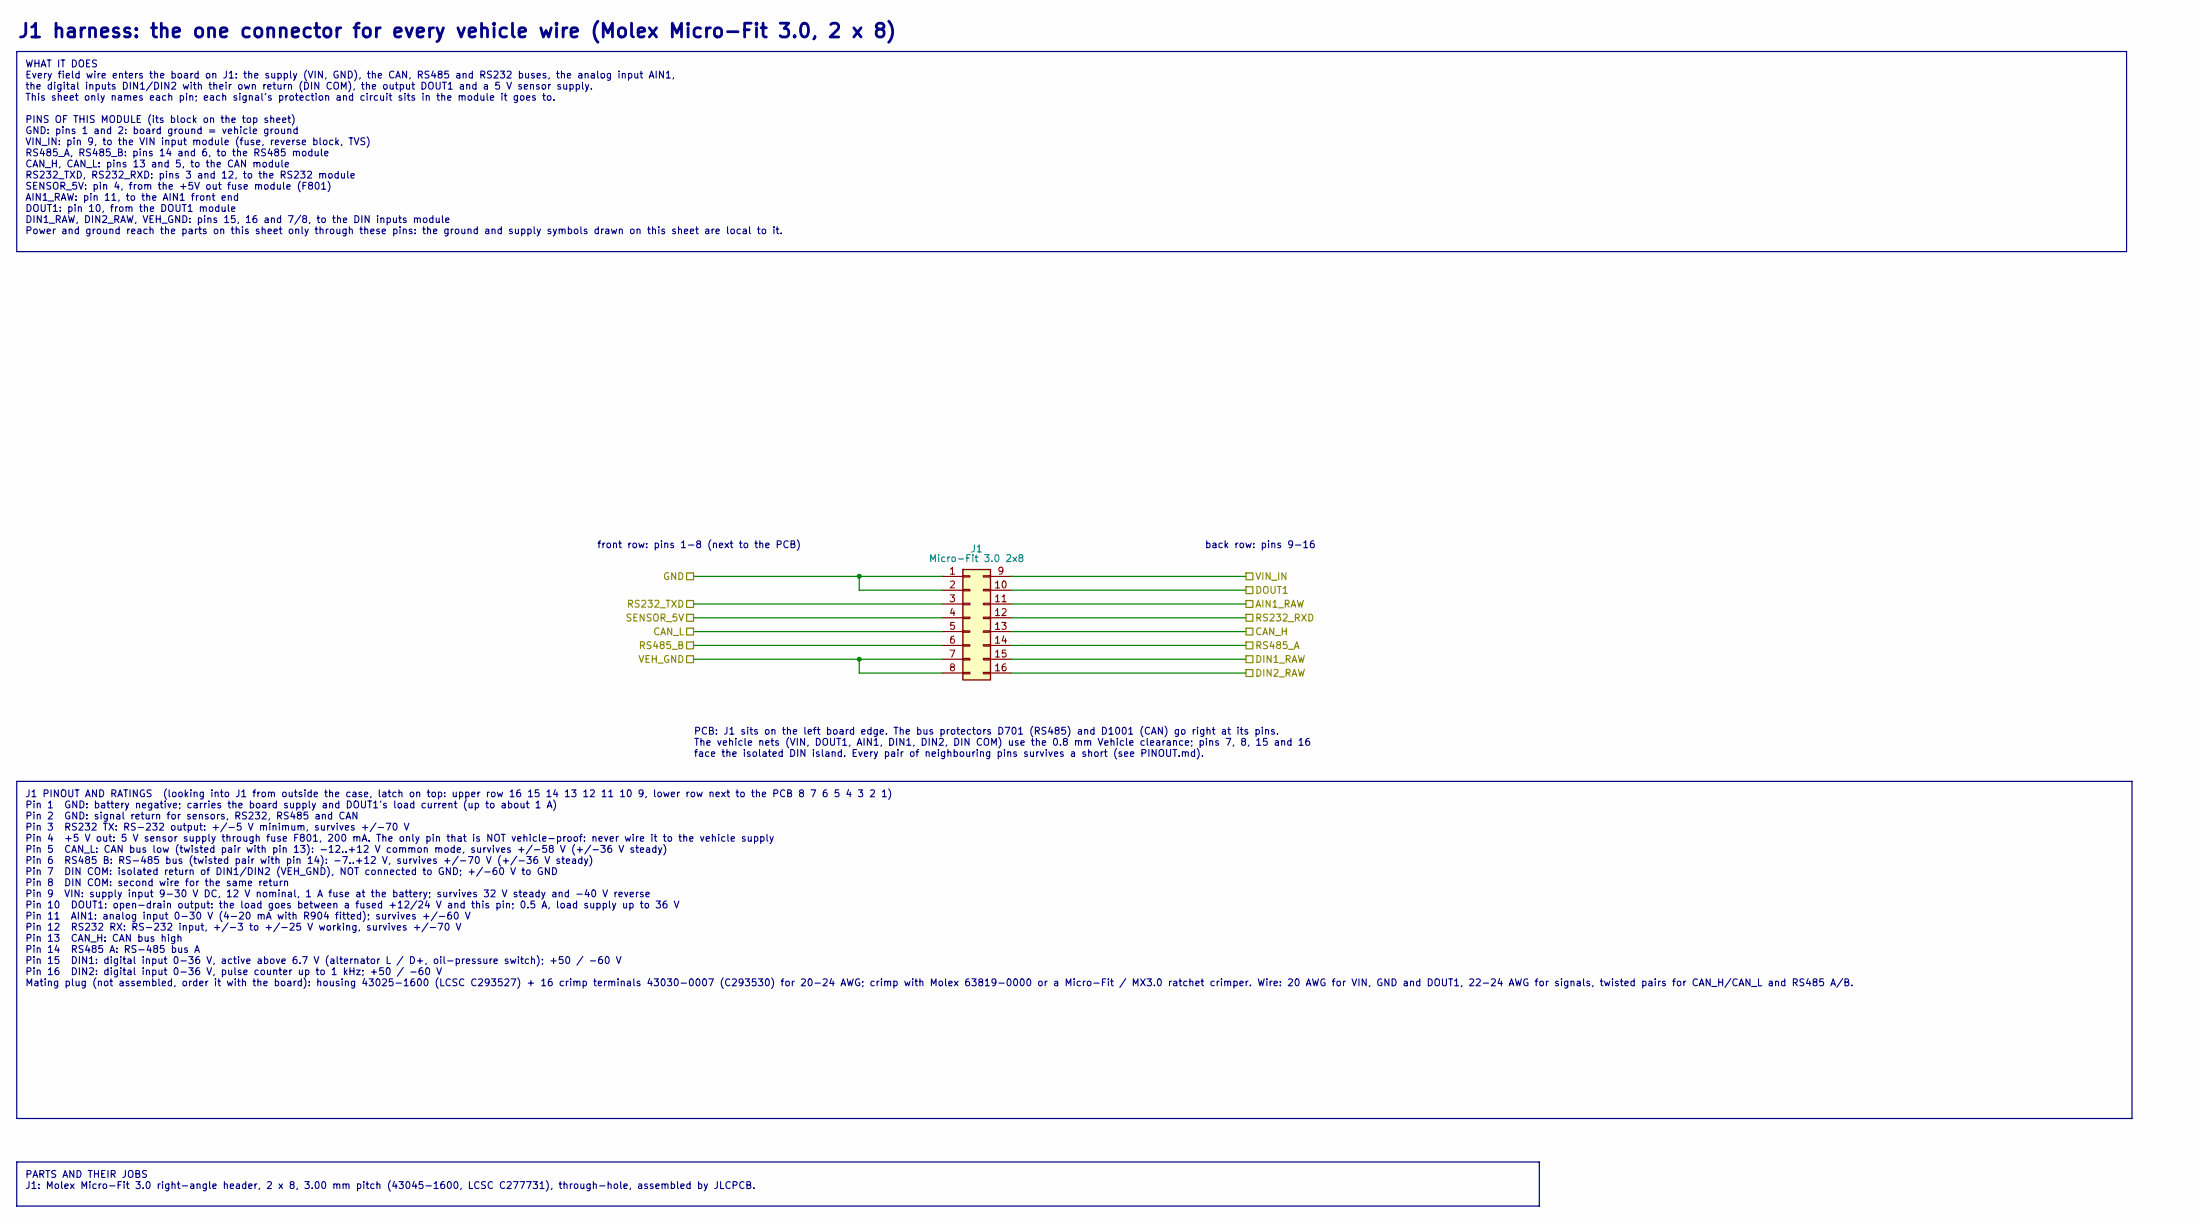
[picture p17: schematic harness.kicad_sch, J1 harness]

Parts:
J1: Micro-Fit 3.0 2x8; Molex_Micro-Fit_3.0_43045-1600_2x08_P3.00mm_Horizontal; MPN 430451600; LCSC C277731

Connections:
/AIN1_RAW: J1.11; also elsewhere on the board
/CAN_H: J1.13; also elsewhere on the board
/CAN_L: J1.5; also elsewhere on the board
/DIN1_RAW: J1.15; also elsewhere on the board
/DIN2_RAW: J1.16; also elsewhere on the board
/DOUT1: J1.10; also elsewhere on the board
/RS232_RXD: J1.12; also elsewhere on the board
/RS232_TXD: J1.3; also elsewhere on the board
/RS485_A: J1.14; also elsewhere on the board
/RS485_B: J1.6; also elsewhere on the board
/SENSOR_5V: J1.4; also elsewhere on the board
/VEH_GND: J1.7, J1.8; also elsewhere on the board
/VIN_IN: J1.9; also elsewhere on the board
GND: J1.1, J1.2; also elsewhere on the board

Notes on the sheet:
J1 harness: the one connector for every vehicle wire (Molex Micro-Fit 3.0, 2 x 8)
WHAT IT DOES Every field wire enters the board on J1: the supply (VIN, GND), the CAN, RS485 and RS232 buses, the analog input AIN1, the digital inputs DIN1/DIN2 with their own return (DIN COM), the output DOUT1 and a 5 V sensor supply. This sheet only names each pin; each signal's protection and ci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
front row: pins 1-8 (next to the PCB)
back row: pins 9-16
PCB: J1 sits on the left board edge. The bus protectors D701 (RS485) and D1001 (CAN) go right at its pins. The vehicle nets (VIN, DOUT1, AIN1, DIN1, DIN2, DIN COM) use the 0.8 mm Vehicle clearance; pins 7, 8, 15 and 16 face the isolated DIN island. Every pair of neighbouring pins survives a short (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
J1 PINOUT AND RATINGS (looking into J1 from outside the case, latch on top: upper row 16 15 14 13 12 11 10 9, lower row next to the PCB 8 7 6 5 4 3 2 1) Pin 1 GND: battery negative; carries the board supply and DOUT1's load current (up to about 1 A) Pin 2 GND: signal return for sensors, RS232, RS48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
PARTS AND THEIR JOBS J1: Molex Micro-Fit 3.0 right-angle header, 2 x 8, 3.00 mm pitch (43045-1600, LCSC C277731), through-hole, assembled by JLCPCB.

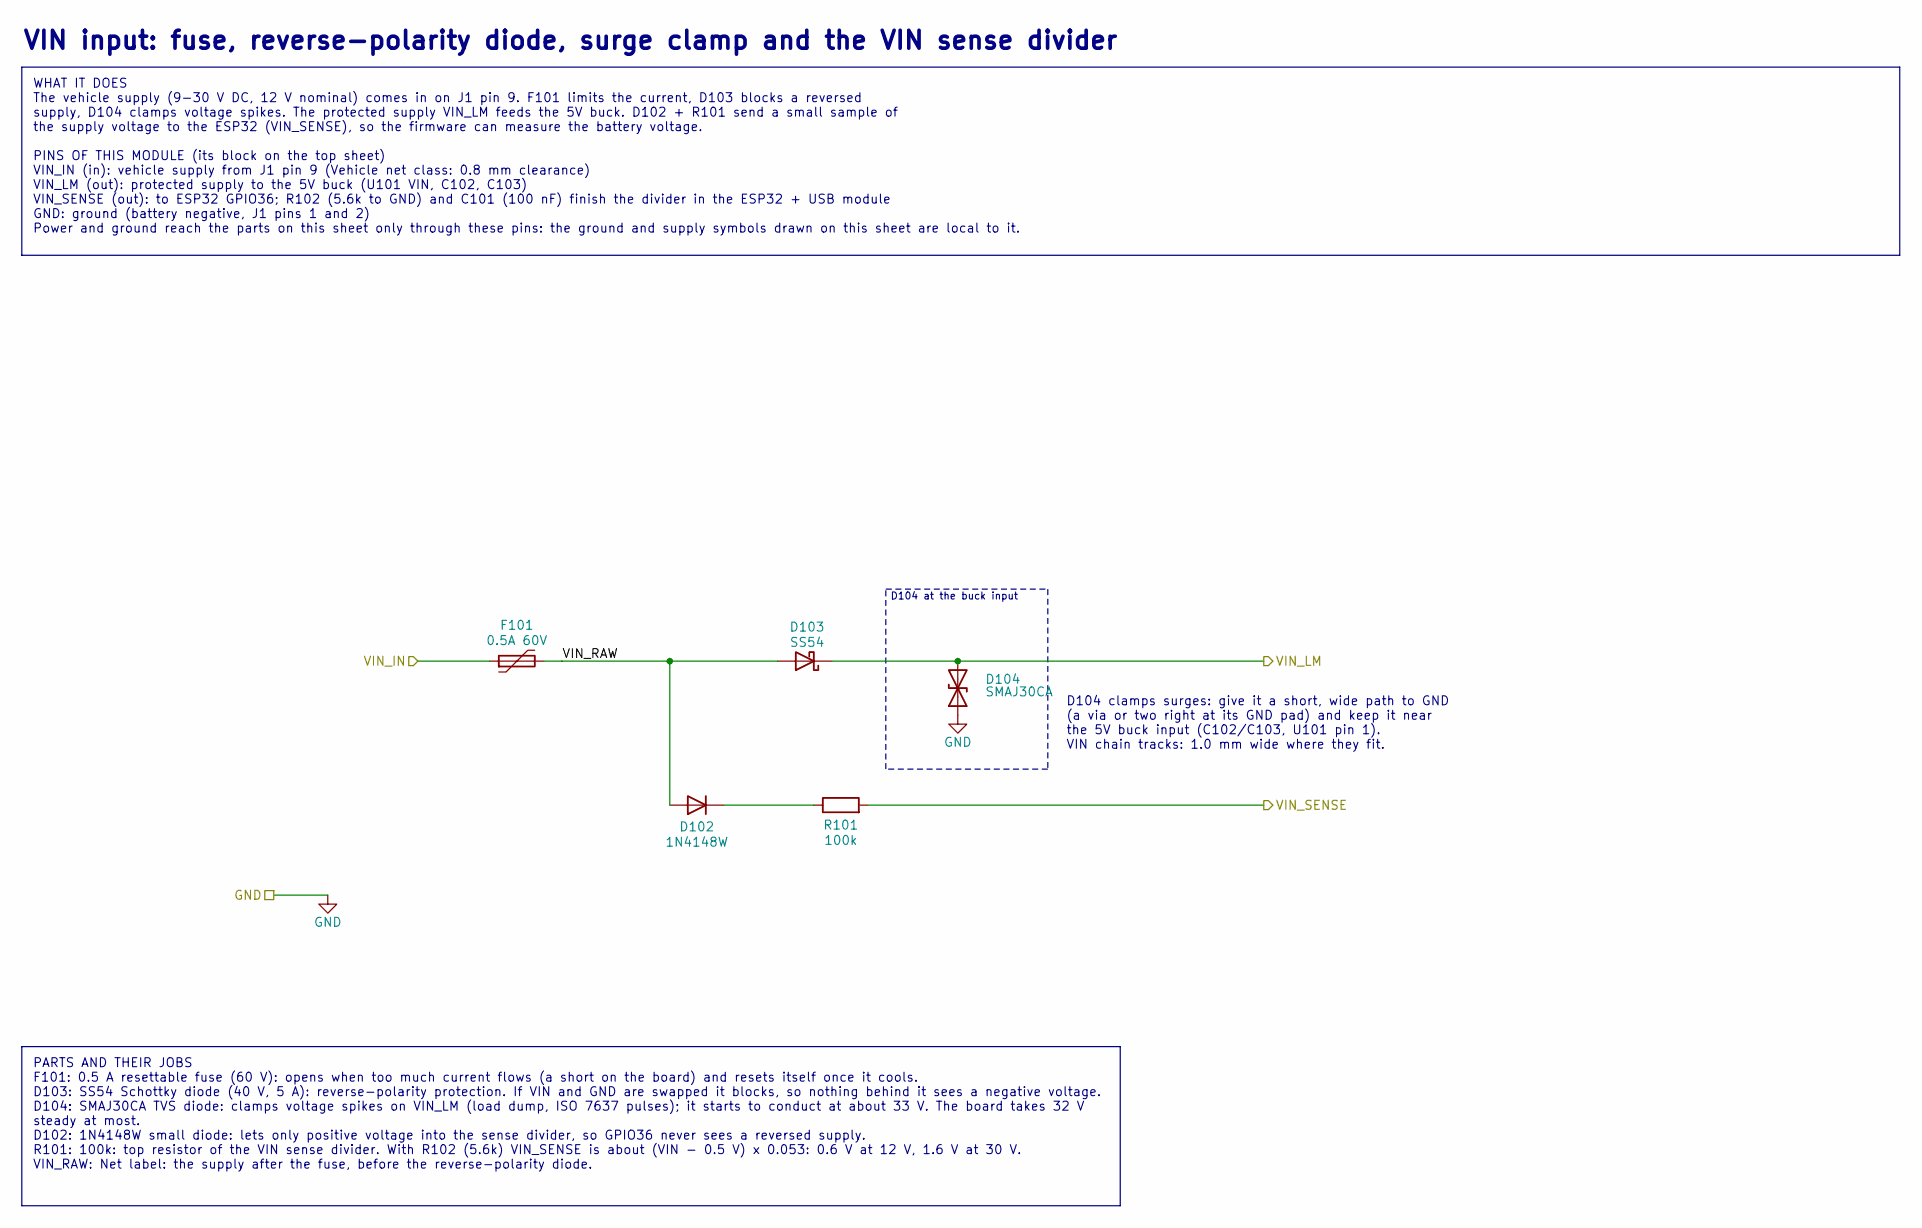
[picture p18: schematic vin-input.kicad_sch, VIN input]

Parts:
D102: 1N4148W; D_SOD-123; MPN 1N4148W; LCSC C81598
D103: SS54; D_SMA; MPN SS54; LCSC C22452
D104: SMAJ30CA; D_SMA; MPN SMAJ30CA; LCSC C110043
F101: 0.5A 60V; Fuse_1812_4532Metric; MPN 1812L050/60GR; LCSC C19078719
R101: 100k; R_1206_3216Metric; MPN 1206W4F1003T5E; LCSC C17900

Connections:
/VIN input/VIN_RAW: D102.2 (A), D103.2 (A), F101.2
/VIN_IN: F101.1; also elsewhere on the board
/VIN_LM: D103.1 (K), D104.2 (A2); also elsewhere on the board
/VIN_SENSE: R101.2; also elsewhere on the board
GND: D104.1 (A1); also elsewhere on the board
unnamed: D102.1 (K), R101.1

Notes on the sheet:
VIN input: fuse, reverse-polarity diode, surge clamp and the VIN sense divider
WHAT IT DOES The vehicle supply (9-30 V DC, 12 V nominal) comes in on J1 pin 9. F101 limits the current, D103 blocks a reversed supply, D104 clamps voltage spikes. The protected supply VIN_LM feeds the 5V buck. D102 + R101 send a small sample of the supply voltage to the ESP32 (VIN_SENSE), so the f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
D104 at the buck input
D104 clamps surges: give it a short, wide path to GND (a via or two right at its GND pad) and keep it near the 5V buck input (C102/C103, U101 pin 1). VIN chain tracks: 1.0 mm wide where they fit.
PARTS AND THEIR JOBS F101: 0.5 A resettable fuse (60 V): opens when too much current flows (a short on the board) and resets itself once it cools. D103: SS54 Schottky diode (40 V, 5 A): reverse-polarity protection. If VIN and GND are swapped it blocks, so nothing behind it sees a negative voltage. 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

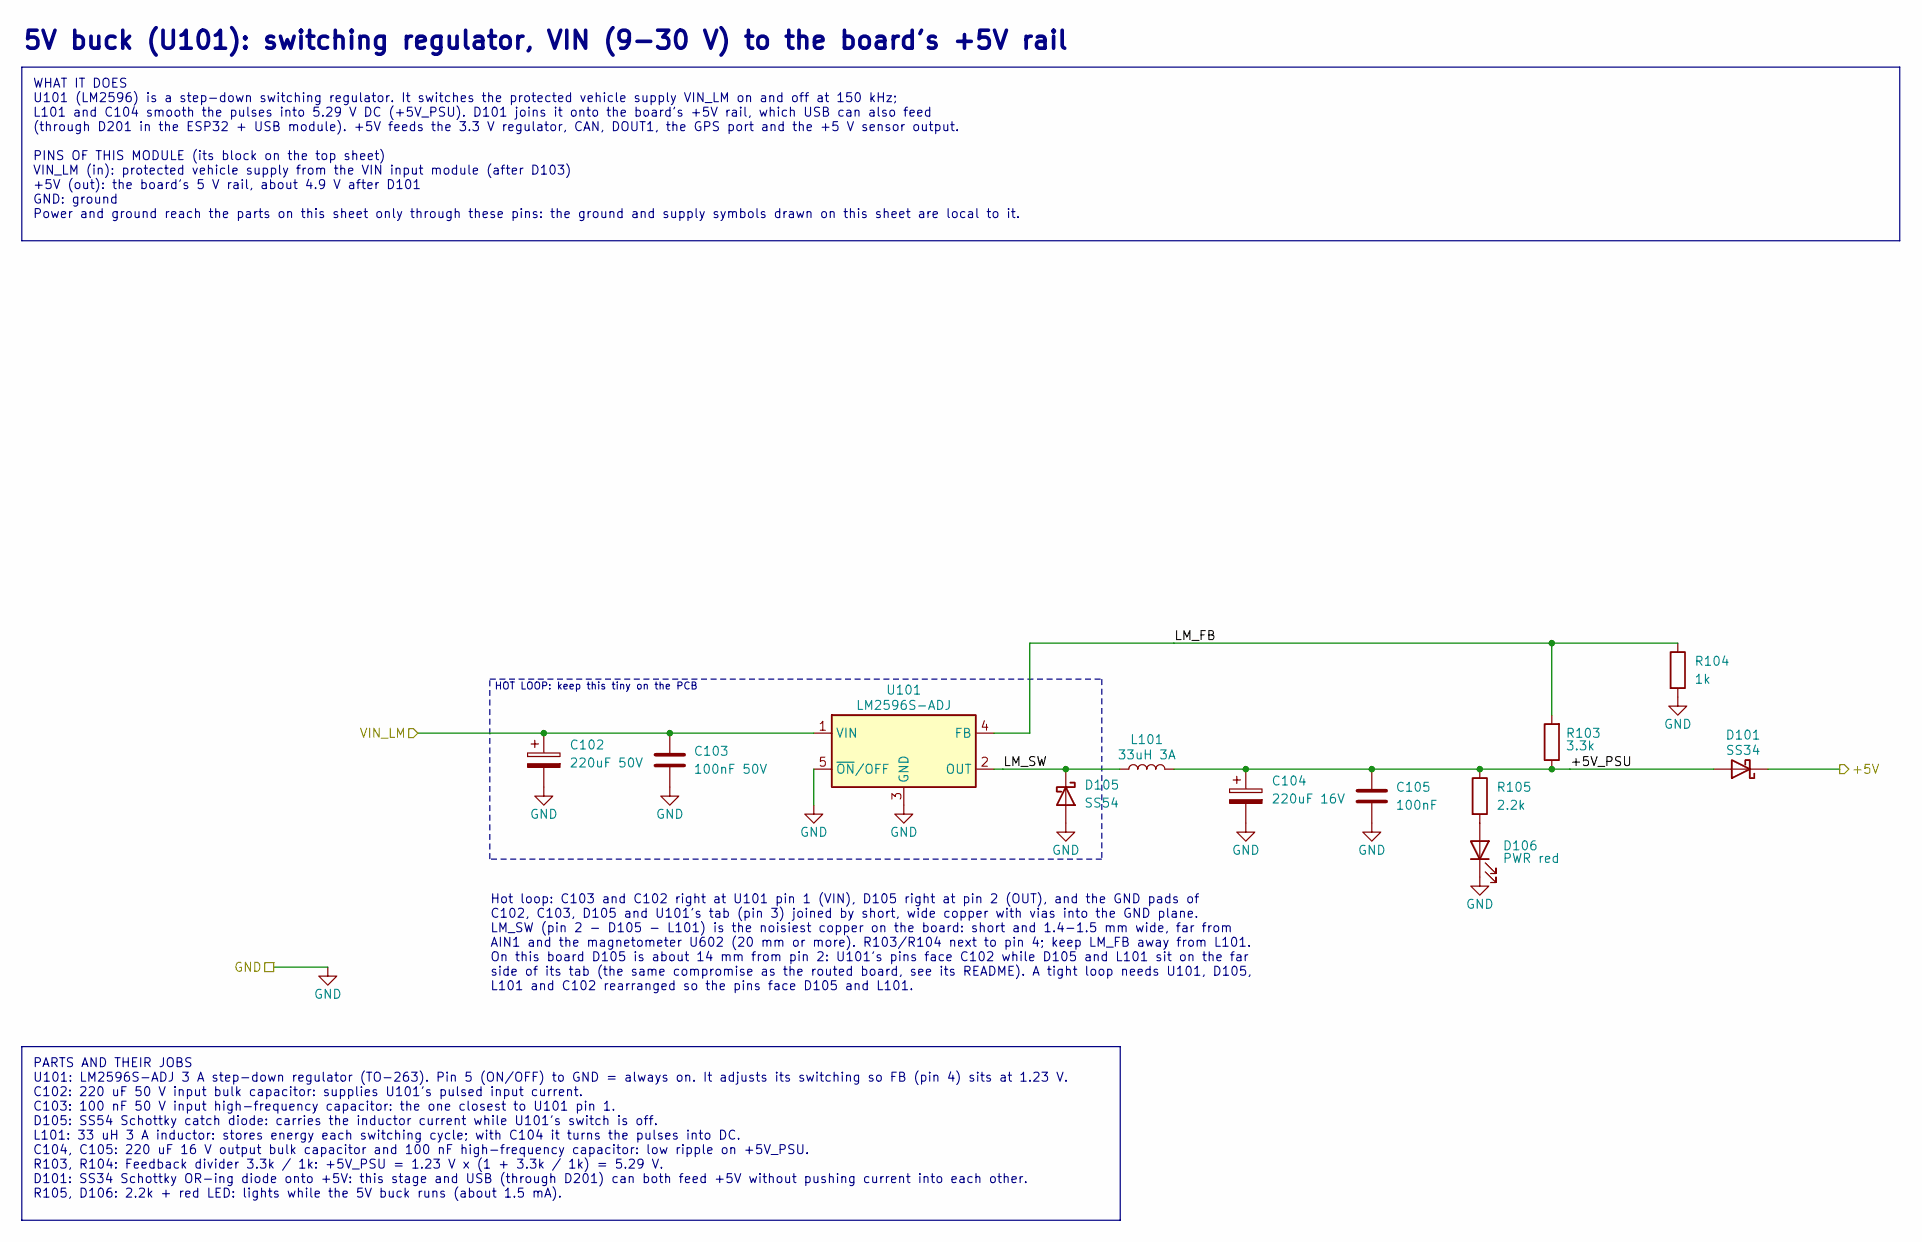
[picture p19: schematic buck-5v.kicad_sch, 5V buck (U101)]

Parts:
C102: 220uF 50V; CP_Elec_10x10; MPN RVT220UF50V67RV0021; LCSC C2887271
C103: 100nF 50V; C_0603_1608Metric; MPN CC0603KRX7R9BB104; LCSC C14663
C104: 220uF 16V; CP_Elec_6.3x7.7; MPN RVT220UF16V67RV0015; LCSC C2887273
C105: 100nF; C_0603_1608Metric; MPN CC0603KRX7R9BB104; LCSC C14663
D101: SS34; D_SMA; MPN SS34; LCSC C8678
D105: SS54; D_SMA; MPN SS54; LCSC C22452
D106: PWR red; LED_0603_1608Metric; MPN KT-0603R; LCSC C2286
L101: 33uH 3A; L_12x12mm_H8mm; MPN SMDRI127-330MT; LCSC C9400
R103: 3.3k; R_0603_1608Metric; MPN 0603WAF3301T5E; LCSC C22978
R104: 1k; R_0603_1608Metric; MPN 0603WAF1001T5E; LCSC C21190
R105: 2.2k; R_0603_1608Metric; MPN 0603WAF2201T5E; LCSC C4190
U101: LM2596S-ADJ; TO-263-5_TabPin3; MPN LM2596S-ADJ(UMW); LCSC C347423

Connections:
+5V: D101.1 (K); also elsewhere on the board
/5V buck (U101)/+5V_PSU: C104.1, C105.1, D101.2 (A), L101.2, R103.1, R105.1
/5V buck (U101)/LM_FB: R103.2, R104.1, U101.4 (FB)
/5V buck (U101)/LM_SW: D105.1 (K), L101.1, U101.2 (OUT)
/VIN_LM: C102.1, C103.1, U101.1 (VIN); also elsewhere on the board
GND: C102.2, C103.2, C104.2, C105.2, D105.2 (A), D106.1 (K), R104.2, U101.3 (GND), U101.5 (~ON/OFF); also elsewhere on the board
unnamed: D106.2 (A), R105.2

Notes on the sheet:
5V buck (U101): switching regulator, VIN (9-30 V) to the board's +5V rail
WHAT IT DOES U101 (LM2596) is a step-down switching regulator. It switches the protected vehicle supply VIN_LM on and off at 150 kHz; L101 and C104 smooth the pulses into 5.29 V DC (+5V_PSU). D101 joins it onto the board's +5V rail, which USB can also feed (through D201 in the ESP32 + USB module). 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
HOT LOOP: keep this tiny on the PCB
Hot loop: C103 and C102 right at U101 pin 1 (VIN), D105 right at pin 2 (OUT), and the GND pads of C102, C103, D105 and U101's tab (pin 3) joined by short, wide copper with vias into the GND plane. LM_SW (pin 2 - D105 - L101) is the noisiest copper on the board: short and 1.4-1.5 mm wide, far from A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
PARTS AND THEIR JOBS U101: LM2596S-ADJ 3 A step-down regulator (TO-263). Pin 5 (ON/OFF) to GND = always on. It adjusts its switching so FB (pin 4) sits at 1.23 V. C102: 220 uF 50 V input bulk capacitor: supplies U101's pulsed input current. C103: 100 nF 50 V input high-frequency capacitor: the one 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
