ilomon10/embedded-totalizer-hour-meter/schematic/hour-meter-board/hour-meter-board.kicad_pcb

## KiCad design schematic/hour-meter-board/hour-meter-board.kicad_pcb (continued)

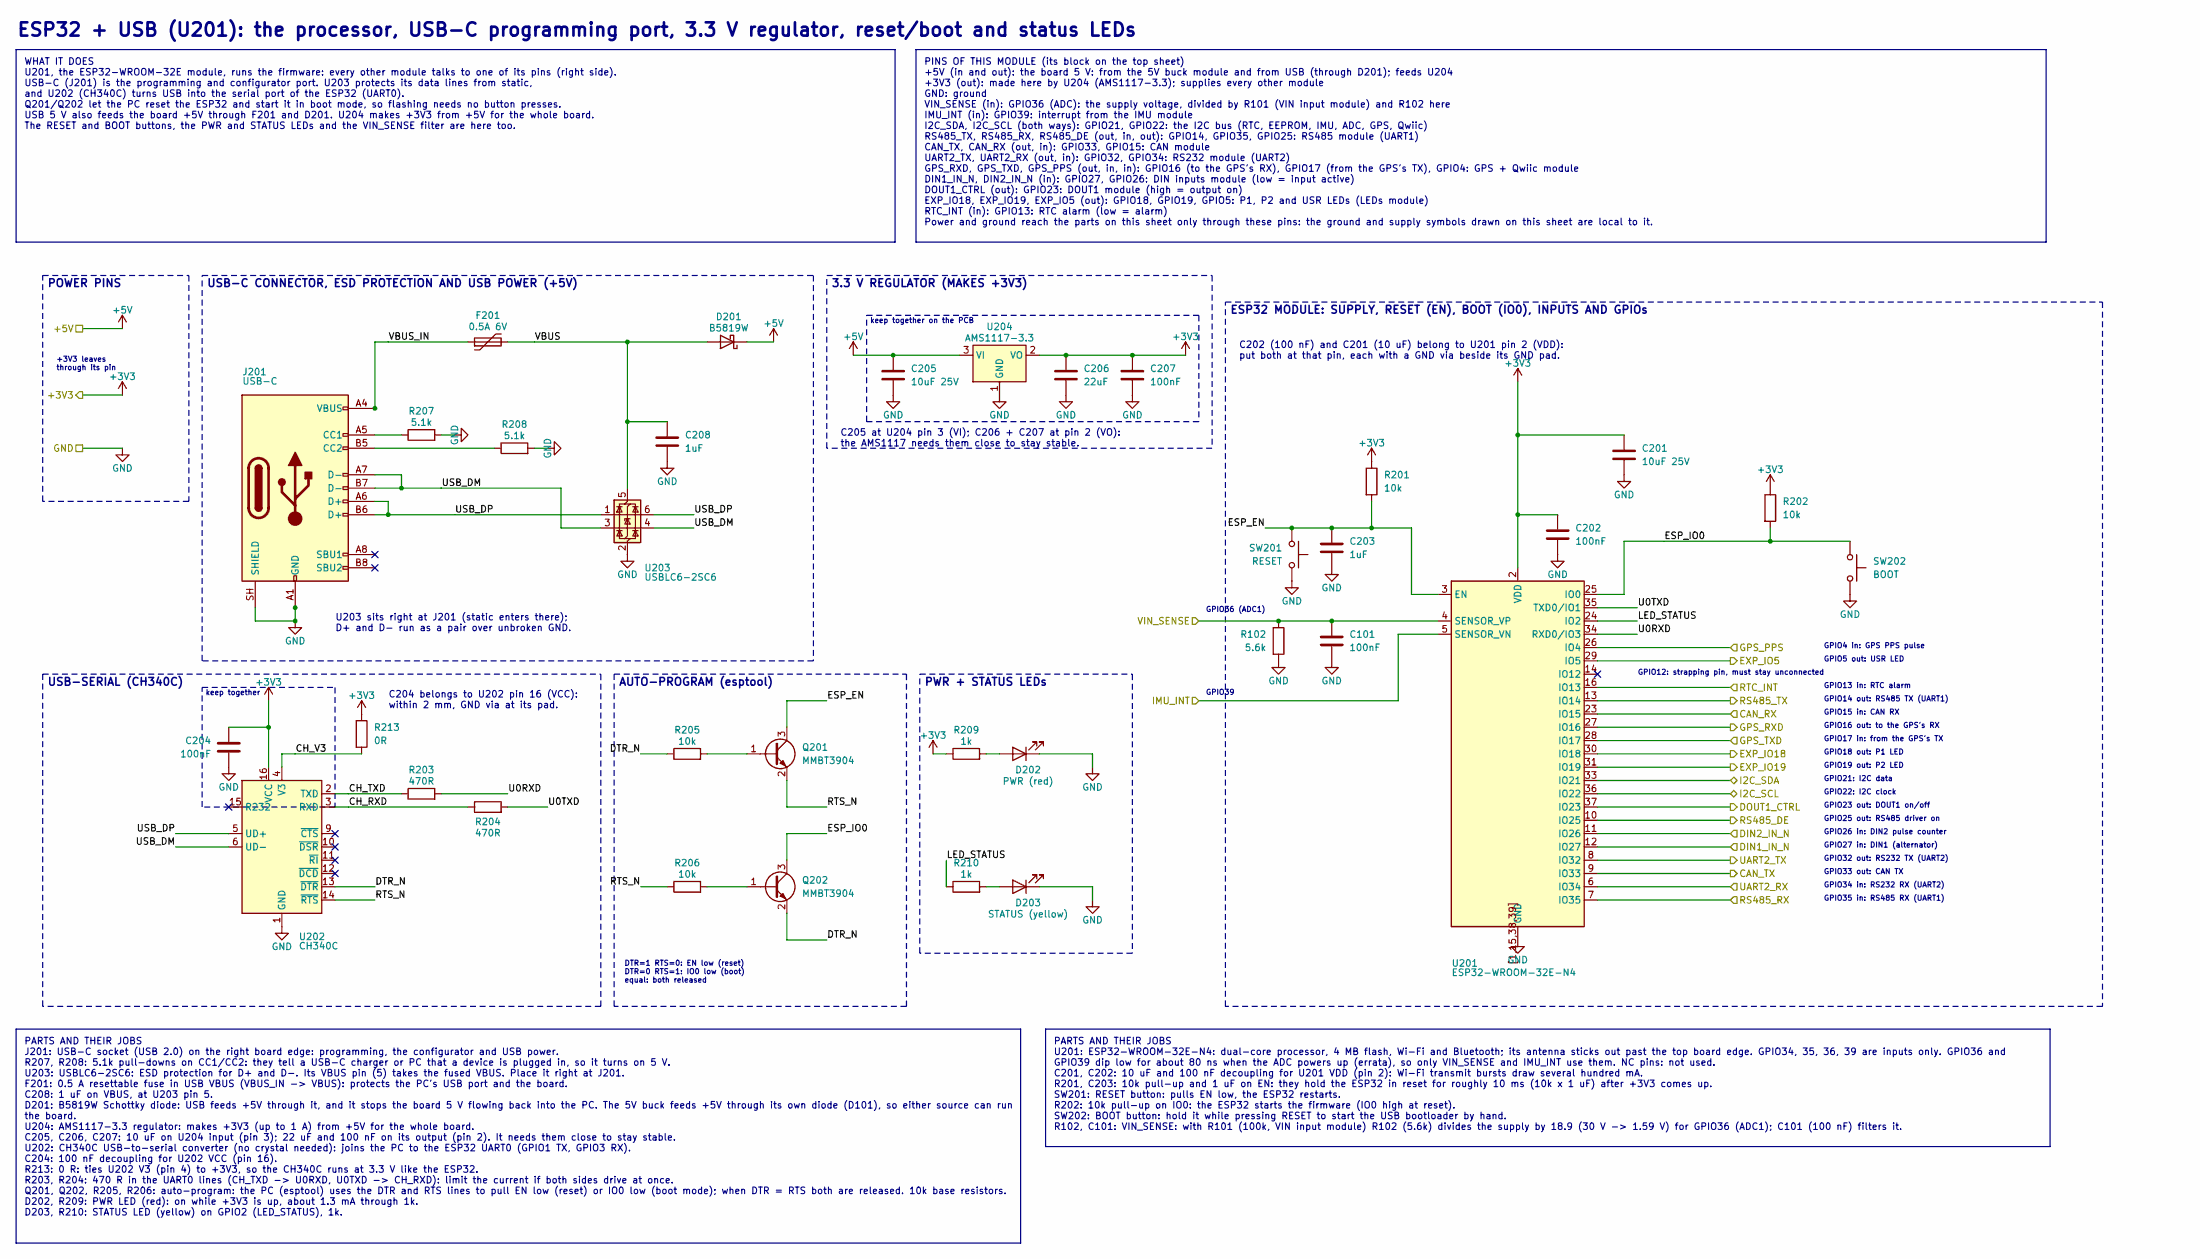
[picture p20: schematic esp32-usb.kicad_sch, ESP32 + USB (U201)]

Parts:
C101, C202, C204, C207: 100nF; C_0603_1608Metric; MPN CC0603KRX7R9BB104; LCSC C14663
C201, C205: 10uF 25V; C_0805_2012Metric; MPN CL21A106KAYNNNE; LCSC C15850
C203, C208: 1uF; C_0603_1608Metric; MPN CL10A105KB8NNNC; LCSC C15849
C206: 22uF; C_0805_2012Metric; MPN CL21A226MAQNNNE; LCSC C45783
D201: B5819W; D_SOD-123; MPN B5819W SL; LCSC C8598
D202: PWR (red); LED_0603_1608Metric; MPN KT-0603R; LCSC C2286
D203: STATUS (yellow); LED_0603_1608Metric; MPN KT-0603Y; LCSC C2287
F201: 0.5A 6V; Fuse_1206_3216Metric; MPN nSMD050; LCSC C69688
J201: USB-C; USB_C_Receptacle_HRO_TYPE-C-31-M-12; MPN TYPE-C-31-M-12; LCSC C165948
Q201, Q202: MMBT3904; SOT-23; MPN MMBT3904; LCSC C20526
R102: 5.6k; R_0603_1608Metric; MPN 0603WAF5601T5E; LCSC C23189
R201, R202, R205, R206: 10k; R_0603_1608Metric; MPN 0603WAF1002T5E; LCSC C25804
R203, R204: 470R; R_0603_1608Metric; MPN 0603WAF4700T5E; LCSC C23179
R207, R208: 5.1k; R_0603_1608Metric; MPN 0603WAF5101T5E; LCSC C23186
R209, R210: 1k; R_0603_1608Metric; MPN 0603WAF1001T5E; LCSC C21190
R213: 0R; R_0603_1608Metric; MPN 0603WAF0000T5E; LCSC C21189
SW201: RESET; SW_Push_1P1T_XKB_TS-1187A; MPN TS-1187A-B-A-B; LCSC C318884
SW202: BOOT; SW_Push_1P1T_XKB_TS-1187A; MPN TS-1187A-B-A-B; LCSC C318884
U201: ESP32-WROOM-32E-N4; ESP32-WROOM-32E; MPN ESP32-WROOM-32E-N4; LCSC C701341
U202: CH340C; SOIC-16_3.9x9.9mm_P1.27mm; MPN CH340C; LCSC C84681
U203: USBLC6-2SC6; SOT-23-6; MPN USBLC6-2SC6; LCSC C7519
U204: AMS1117-3.3; SOT-223-3_TabPin2; MPN AMS1117-3.3; LCSC C6186

Connections:
+3V3: C201.1, C202.1, C204.1, C206.1, C207.1, R201.1, R202.1, R209.1, R213.1, U201.2 (VDD), U202.16 (VCC), U204.2 (VO); also elsewhere on the board
+5V: C205.1, D201.1 (K), U204.3 (VI); also elsewhere on the board
/CAN_RX: U201.23 (IO15); also elsewhere on the board
/CAN_TX: U201.9 (IO33); also elsewhere on the board
/DIN1_IN_N: U201.12 (IO27); also elsewhere on the board
/DIN2_IN_N: U201.11 (IO26); also elsewhere on the board
/DOUT1_CTRL: U201.37 (IO23); also elsewhere on the board
/ESP32 + USB (U201)/CH_RXD: R204.1, U202.3 (RXD)
/ESP32 + USB (U201)/CH_TXD: R203.1, U202.2 (TXD)
/ESP32 + USB (U201)/CH_V3: R213.2, U202.4 (V3)
/ESP32 + USB (U201)/DTR_N: Q202.2 (E), R205.1, U202.13 (~DTR)
/ESP32 + USB (U201)/ESP_EN: C203.1, Q201.3 (C), R201.2, SW201.1, U201.3 (EN)
/ESP32 + USB (U201)/ESP_IO0: Q202.3 (C), R202.2, SW202.1, U201.25 (IO0)
/ESP32 + USB (U201)/LED_STATUS: R210.1, U201.24 (IO2)
/ESP32 + USB (U201)/RTS_N: Q201.2 (E), R206.1, U202.14 (~RTS)
/ESP32 + USB (U201)/U0RXD: R203.2, U201.34 (RXD0/IO3)
/ESP32 + USB (U201)/U0TXD: R204.2, U201.35 (TXD0/IO1)
/ESP32 + USB (U201)/USB_DM: J201.A7 (D-), J201.B7 (D-), U202.6 (UD-), U203.3 (I/O2), U203.4 (I/O2)
/ESP32 + USB (U201)/USB_DP: J201.A6 (D+), J201.B6 (D+), U202.5 (UD+), U203.1 (I/O1), U203.6 (I/O1)
/ESP32 + USB (U201)/VBUS: C208.1, D201.2 (A), F201.2, U203.5 (VBUS)
/ESP32 + USB (U201)/VBUS_IN: F201.1, J201.A4 (VBUS), J201.A9 (VBUS), J201.B4 (VBUS), J201.B9 (VBUS)
/EXP_IO5: U201.29 (IO5); also elsewhere on the board
/EXP_IO18: U201.30 (IO18); also elsewhere on the board
/EXP_IO19: U201.31 (IO19); also elsewhere on the board
/GPS_PPS: U201.26 (IO4); also elsewhere on the board
/GPS_RXD: U201.27 (IO16); also elsewhere on the board
/GPS_TXD: U201.28 (IO17); also elsewhere on the board
/I2C_SCL: U201.36 (IO22); also elsewhere on the board
/I2C_SDA: U201.33 (IO21); also elsewhere on the board
/IMU_INT: U201.5 (SENSOR_VN); also elsewhere on the board
/RS485_DE: U201.10 (IO25); also elsewhere on the board
/RS485_RX: U201.7 (IO35); also elsewhere on the board
/RS485_TX: U201.13 (IO14); also elsewhere on the board
/RTC_INT: U201.16 (IO13); also elsewhere on the board
/UART2_RX: U201.6 (IO34); also elsewhere on the board
/UART2_TX: U201.8 (IO32); also elsewhere on the board
/VIN_SENSE: C101.1, R102.1, U201.4 (SENSOR_VP); also elsewhere on the board
GND: C101.2, C201.2, C202.2, C203.2, C204.2, C205.2, C206.2, C207.2, C208.2, D202.1 (K), D203.1 (K), J201.A1 (GND), J201.A12 (GND), J201.B1 (GND), J201.B12 (GND), J201.SH (SHIELD), R102.2, R207.2, R208.2, SW201.2, SW202.2, U201.1, U201.15, U201.38, U201.39, U201.[1,15,38,39] (GND), U202.1 (GND), U203.2 (GND), U204.1 (GND); also elsewhere on the board
unnamed: D202.2 (A), R209.2
unnamed: D203.2 (A), R210.2
unnamed: J201.A5 (CC1), R207.1
unnamed: J201.B5 (CC2), R208.1
unnamed: Q201.1 (B), R205.2
unnamed: Q202.1 (B), R206.2

Notes on the sheet:
ESP32 + USB (U201): the processor, USB-C programming port, 3.3 V regulator, reset/boot and status LEDs
WHAT IT DOES U201, the ESP32-WROOM-32E module, runs the firmware: every other module talks to one of its pins (right side). USB-C (J201) is the programming and configurator port. U203 protects its data lines from static, and U202 (CH340C) turns USB into the serial port of the ESP32 (UART0). Q201/Q2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
PINS OF THIS MODULE (its block on the top sheet) +5V (in and out): the board 5 V: from the 5V buck module and from USB (through D201); feeds U204 +3V3 (out): made here by U204 (AMS1117-3.3); supplies every other module GND: ground VIN_SENSE (in): GPIO36 (ADC): the supply voltage, divided by R101 (V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
POWER PINS
+3V3 leaves through its pin
USB-C CONNECTOR, ESD PROTECTION AND USB POWER (+5V)
U203 sits right at J201 (static enters there); D+ and D- run as a pair over unbroken GND.
3.3 V REGULATOR (MAKES +3V3)
keep together on the PCB
C205 at U204 pin 3 (VI); C206 + C207 at pin 2 (VO): the AMS1117 needs them close to stay stable.
USB-SERIAL (CH340C)
keep together
C204 belongs to U202 pin 16 (VCC): within 2 mm, GND via at its pad.
AUTO-PROGRAM (esptool)
DTR=1 RTS=0: EN low (reset) DTR=0 RTS=1: IO0 low (boot) equal: both released
PWR + STATUS LEDs
ESP32 MODULE: SUPPLY, RESET (EN), BOOT (IO0), INPUTS AND GPIOs
C202 (100 nF) and C201 (10 uF) belong to U201 pin 2 (VDD): put both at that pin, each with a GND via beside its GND pad.
GPIO36 (ADC1)
GPIO39
GPIO4 in: GPS PPS pulse
GPIO5 out: USR LED
GPIO13 in: RTC alarm
GPIO14 out: RS485 TX (UART1)
GPIO15 in: CAN RX
GPIO16 out: to the GPS's RX
GPIO17 in: from the GPS's TX
GPIO18 out: P1 LED
GPIO19 out: P2 LED
GPIO21: I2C data
GPIO22: I2C clock
GPIO23 out: DOUT1 on/off
GPIO25 out: RS485 driver on
GPIO26 in: DIN2 pulse counter
GPIO27 in: DIN1 (alternator)
GPIO32 out: RS232 TX (UART2)
GPIO33 out: CAN TX
GPIO34 in: RS232 RX (UART2)
GPIO35 in: RS485 RX (UART1)
GPIO12: strapping pin, must stay unconnected
PARTS AND THEIR JOBS J201: USB-C socket (USB 2.0) on the right board edge: programming, the configurator and USB power. R207, R208: 5.1k pull-downs on CC1/CC2: they tell a USB-C charger or PC that a device is plugged in, so it turns on 5 V. U203: USBLC6-2SC6: ESD protection for D+ and D-. Its VBUS 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
PARTS AND THEIR JOBS U201: ESP32-WROOM-32E-N4: dual-core processor, 4 MB flash, Wi-Fi and Bluetooth; its antenna sticks out past the top board edge. GPIO34, 35, 36, 39 are inputs only. GPIO36 and GPIO39 dip low for about 80 ns when the ADC powers up (errata), so only VIN_SENSE and IMU_INT use them.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

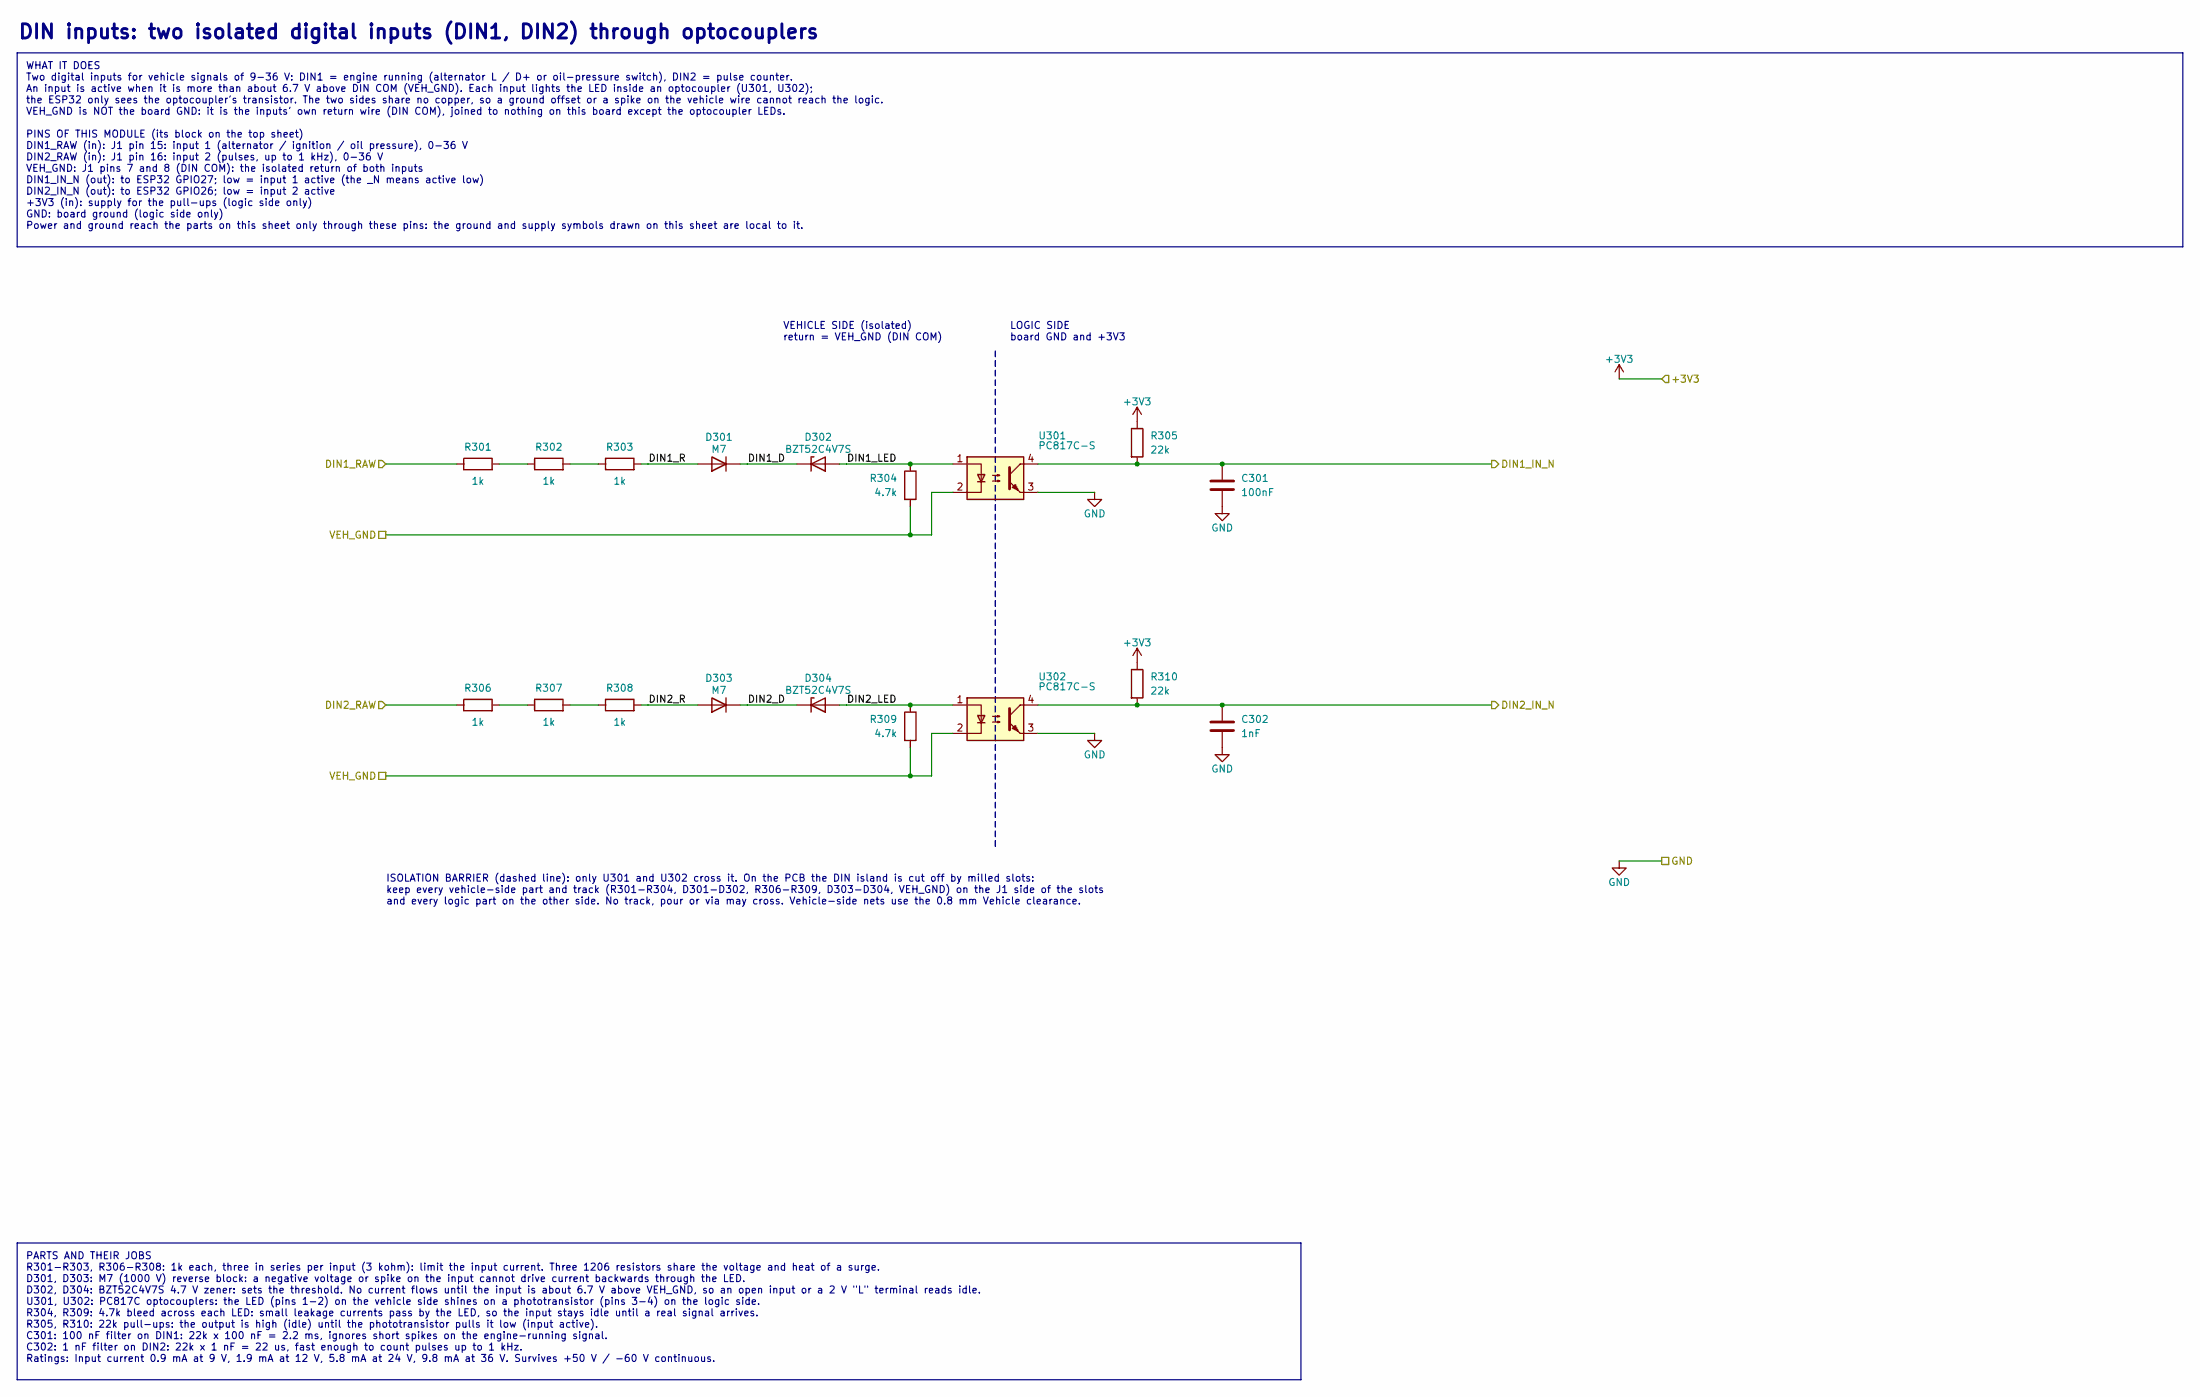
[picture p21: schematic din-inputs.kicad_sch, DIN inputs]

Parts:
C301: 100nF; C_0603_1608Metric; MPN CC0603KRX7R9BB104; LCSC C14663
C302: 1nF; C_0603_1608Metric; MPN CL10B102KB8NNNC; LCSC C1588
D301, D303: M7; D_SMA; MPN M7; LCSC C82443
D302, D304: BZT52C4V7S; D_SOD-323; MPN BZT52C4V7S; LCSC C22611
R301, R302, R303, R306, R307, R308: 1k; R_1206_3216Metric; MPN 1206W4F1001T5E; LCSC C4410
R304, R309: 4.7k; R_0603_1608Metric; MPN 0603WAF4701T5E; LCSC C23162
R305, R310: 22k; R_0603_1608Metric; MPN 0603WAF2202T5E; LCSC C31850
U301, U302: PC817C-S; SMDIP-4_W9.53mm; MPN PC817C-S; LCSC C3008369

Connections:
+3V3: R305.1, R310.1; also elsewhere on the board
/DIN1_IN_N: C301.1, R305.2, U301.4; also elsewhere on the board
/DIN1_RAW: R301.1; also elsewhere on the board
/DIN2_IN_N: C302.1, R310.2, U302.4; also elsewhere on the board
/DIN2_RAW: R306.1; also elsewhere on the board
/DIN inputs/DIN1_D: D301.1 (K), D302.1 (K)
/DIN inputs/DIN1_LED: D302.2 (A), R304.1, U301.1
/DIN inputs/DIN1_R: D301.2 (A), R303.2
/DIN inputs/DIN2_D: D303.1 (K), D304.1 (K)
/DIN inputs/DIN2_LED: D304.2 (A), R309.1, U302.1
/DIN inputs/DIN2_R: D303.2 (A), R308.2
/VEH_GND: R304.2, R309.2, U301.2, U302.2; also elsewhere on the board
GND: C301.2, C302.2, U301.3, U302.3; also elsewhere on the board
unnamed: R301.2, R302.1
unnamed: R302.2, R303.1
unnamed: R306.2, R307.1
unnamed: R307.2, R308.1

Notes on the sheet:
DIN inputs: two isolated digital inputs (DIN1, DIN2) through optocouplers
WHAT IT DOES Two digital inputs for vehicle signals of 9-36 V: DIN1 = engine running (alternator L / D+ or oil-pressure switch), DIN2 = pulse counter. An input is active when it is more than about 6.7 V above DIN COM (VEH_GND). Each input lights the LED inside an optocoupler (U301, U302); the ESP32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
VEHICLE SIDE (isolated) return = VEH_GND (DIN COM)
LOGIC SIDE board GND and +3V3
ISOLATION BARRIER (dashed line): only U301 and U302 cross it. On the PCB the DIN island is cut off by milled slots: keep every vehicle-side part and track (R301-R304, D301-D302, R306-R309, D303-D304, VEH_GND) on the J1 side of the slots and every logic part on the other side. No track, pour or via 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
PARTS AND THEIR JOBS R301-R303, R306-R308: 1k each, three in series per input (3 kohm): limit the input current. Three 1206 resistors share the voltage and heat of a surge. D301, D303: M7 (1000 V) reverse block: a negative voltage or spike on the input cannot drive current backwards through the LED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

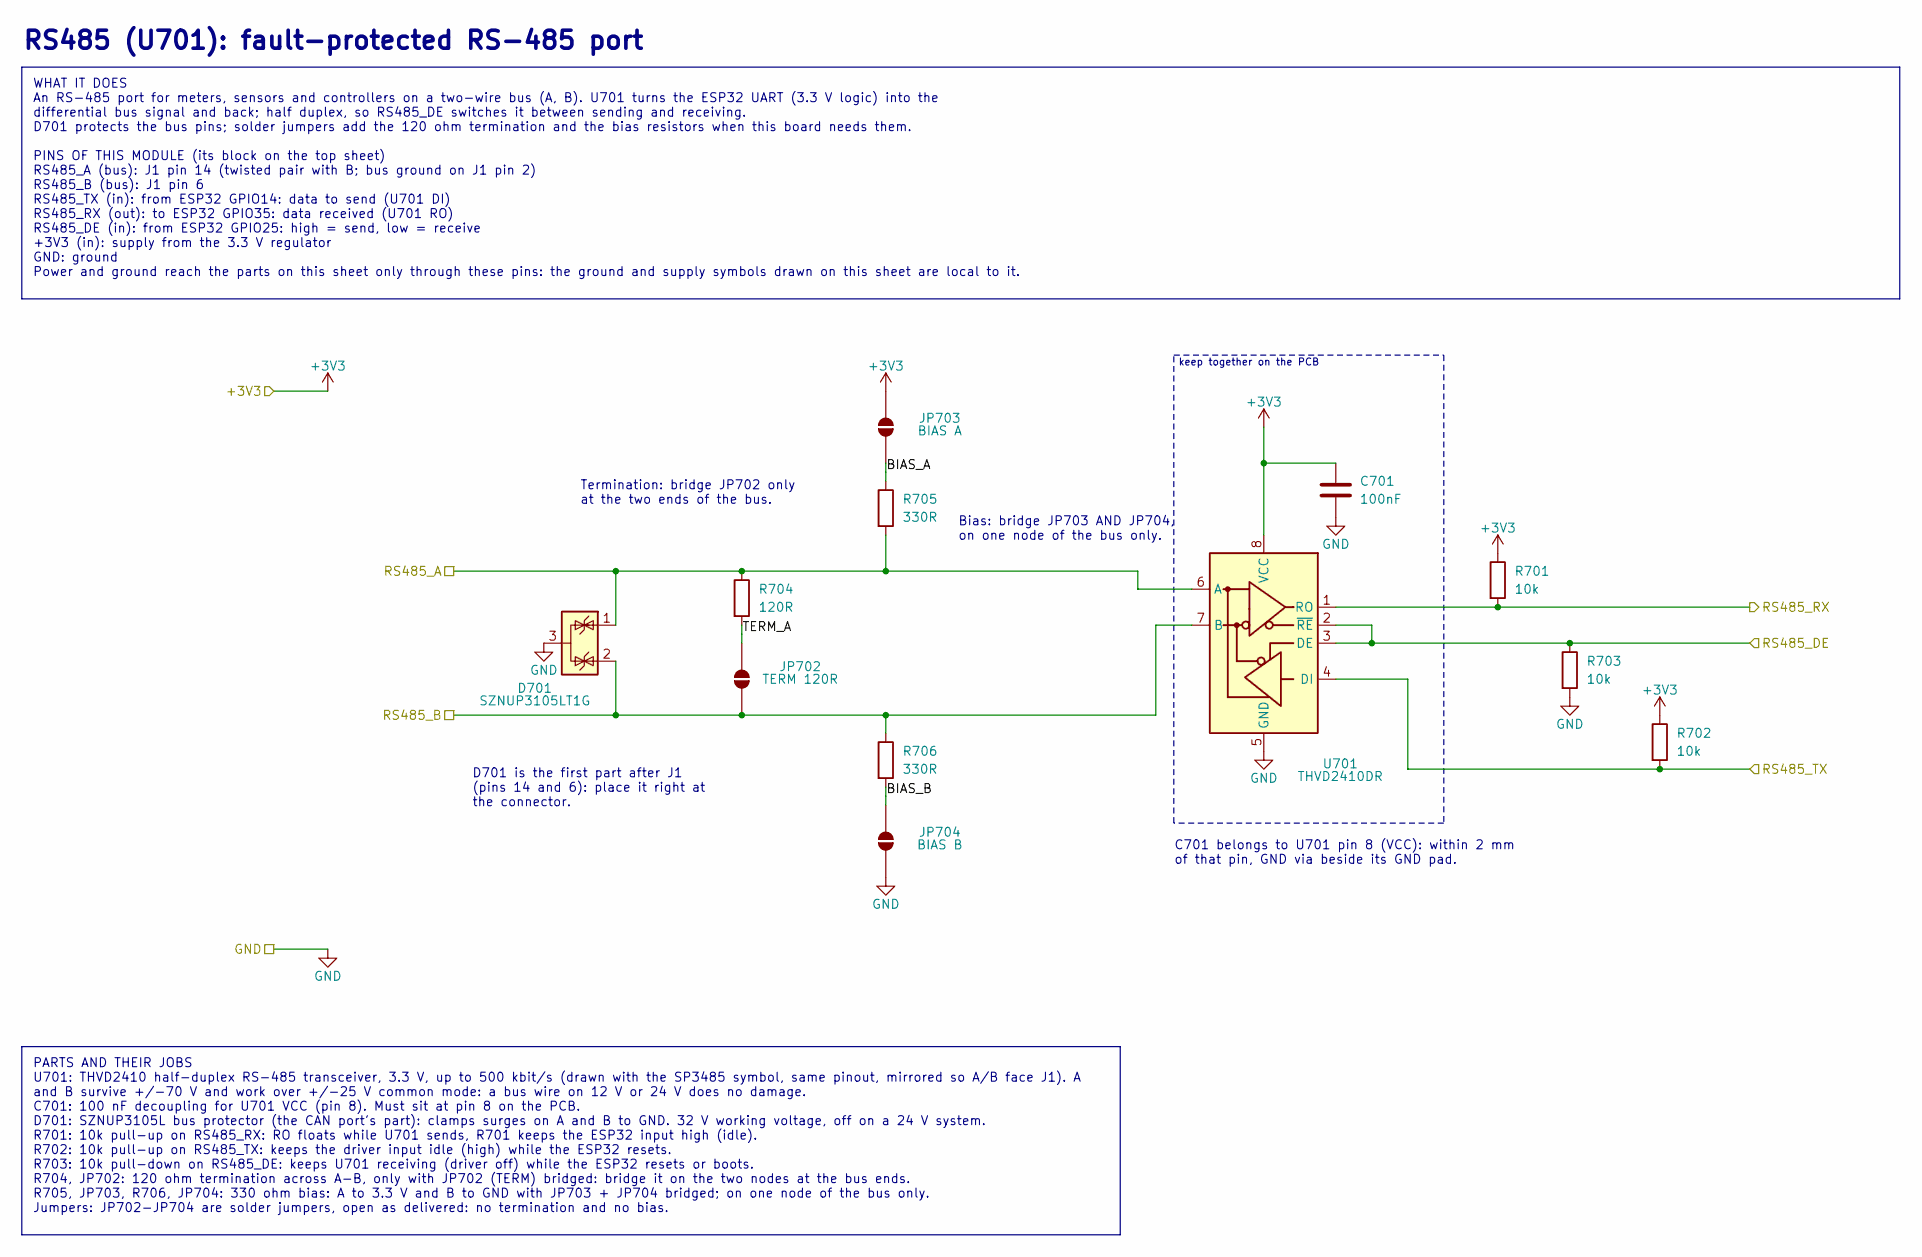
[picture p22: schematic rs485.kicad_sch, RS485 (U701)]

Parts:
C701: 100nF; C_0603_1608Metric; MPN CC0603KRX7R9BB104; LCSC C14663
D701: SZNUP3105LT1G; SOT-23; MPN SZNUP3105LT1G; LCSC C233434
JP702: TERM 120R; SolderJumper-2_P1.3mm_Open_RoundedPad1.0x1.5mm
JP703: BIAS A; SolderJumper-2_P1.3mm_Open_RoundedPad1.0x1.5mm
JP704: BIAS B; SolderJumper-2_P1.3mm_Open_RoundedPad1.0x1.5mm
R701, R702, R703: 10k; R_0603_1608Metric; MPN 0603WAF1002T5E; LCSC C25804
R704: 120R; R_0805_2012Metric; MPN 0805W8F1200T5E; LCSC C17437
R705, R706: 330R; R_0603_1608Metric; MPN 0603WAF3300T5E; LCSC C23138
U701: THVD2410DR; SOIC-8_3.9x4.9mm_P1.27mm; MPN THVD2410DR; LCSC C1849398

Connections:
+3V3: C701.1, JP703.1 (A), R701.1, R702.1, U701.8 (VCC); also elsewhere on the board
/RS485 (U701)/BIAS_A: JP703.2 (B), R705.1
/RS485 (U701)/BIAS_B: JP704.1 (A), R706.2
/RS485 (U701)/TERM_A: JP702.1 (A), R704.2
/RS485_A: D701.1 (K), R704.1, R705.2, U701.6 (A); also elsewhere on the board
/RS485_B: D701.2 (K), JP702.2 (B), R706.1, U701.7 (B); also elsewhere on the board
/RS485_DE: R703.1, U701.2 (~RE), U701.3 (DE); also elsewhere on the board
/RS485_RX: R701.2, U701.1 (RO); also elsewhere on the board
/RS485_TX: R702.2, U701.4 (DI); also elsewhere on the board
GND: C701.2, D701.3 (A), JP704.2 (B), R703.2, U701.5 (GND); also elsewhere on the board

Notes on the sheet:
RS485 (U701): fault-protected RS-485 port
WHAT IT DOES An RS-485 port for meters, sensors and controllers on a two-wire bus (A, B). U701 turns the ESP32 UART (3.3 V logic) into the differential bus signal and back; half duplex, so RS485_DE switches it between sending and receiving. D701 protects the bus pins; solder jumpers add the 120 ohm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
keep together on the PCB
C701 belongs to U701 pin 8 (VCC): within 2 mm of that pin, GND via beside its GND pad.
D701 is the first part after J1 (pins 14 and 6): place it right at the connector.
Bias: bridge JP703 AND JP704, on one node of the bus only.
Termination: bridge JP702 only at the two ends of the bus.
PARTS AND THEIR JOBS U701: THVD2410 half-duplex RS-485 transceiver, 3.3 V, up to 500 kbit/s (drawn with the SP3485 symbol, same pinout, mirrored so A/B face J1). A and B survive +/-70 V and work over +/-25 V common mode: a bus wire on 12 V or 24 V does no damage. C701: 100 nF decoupling for U701 VC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

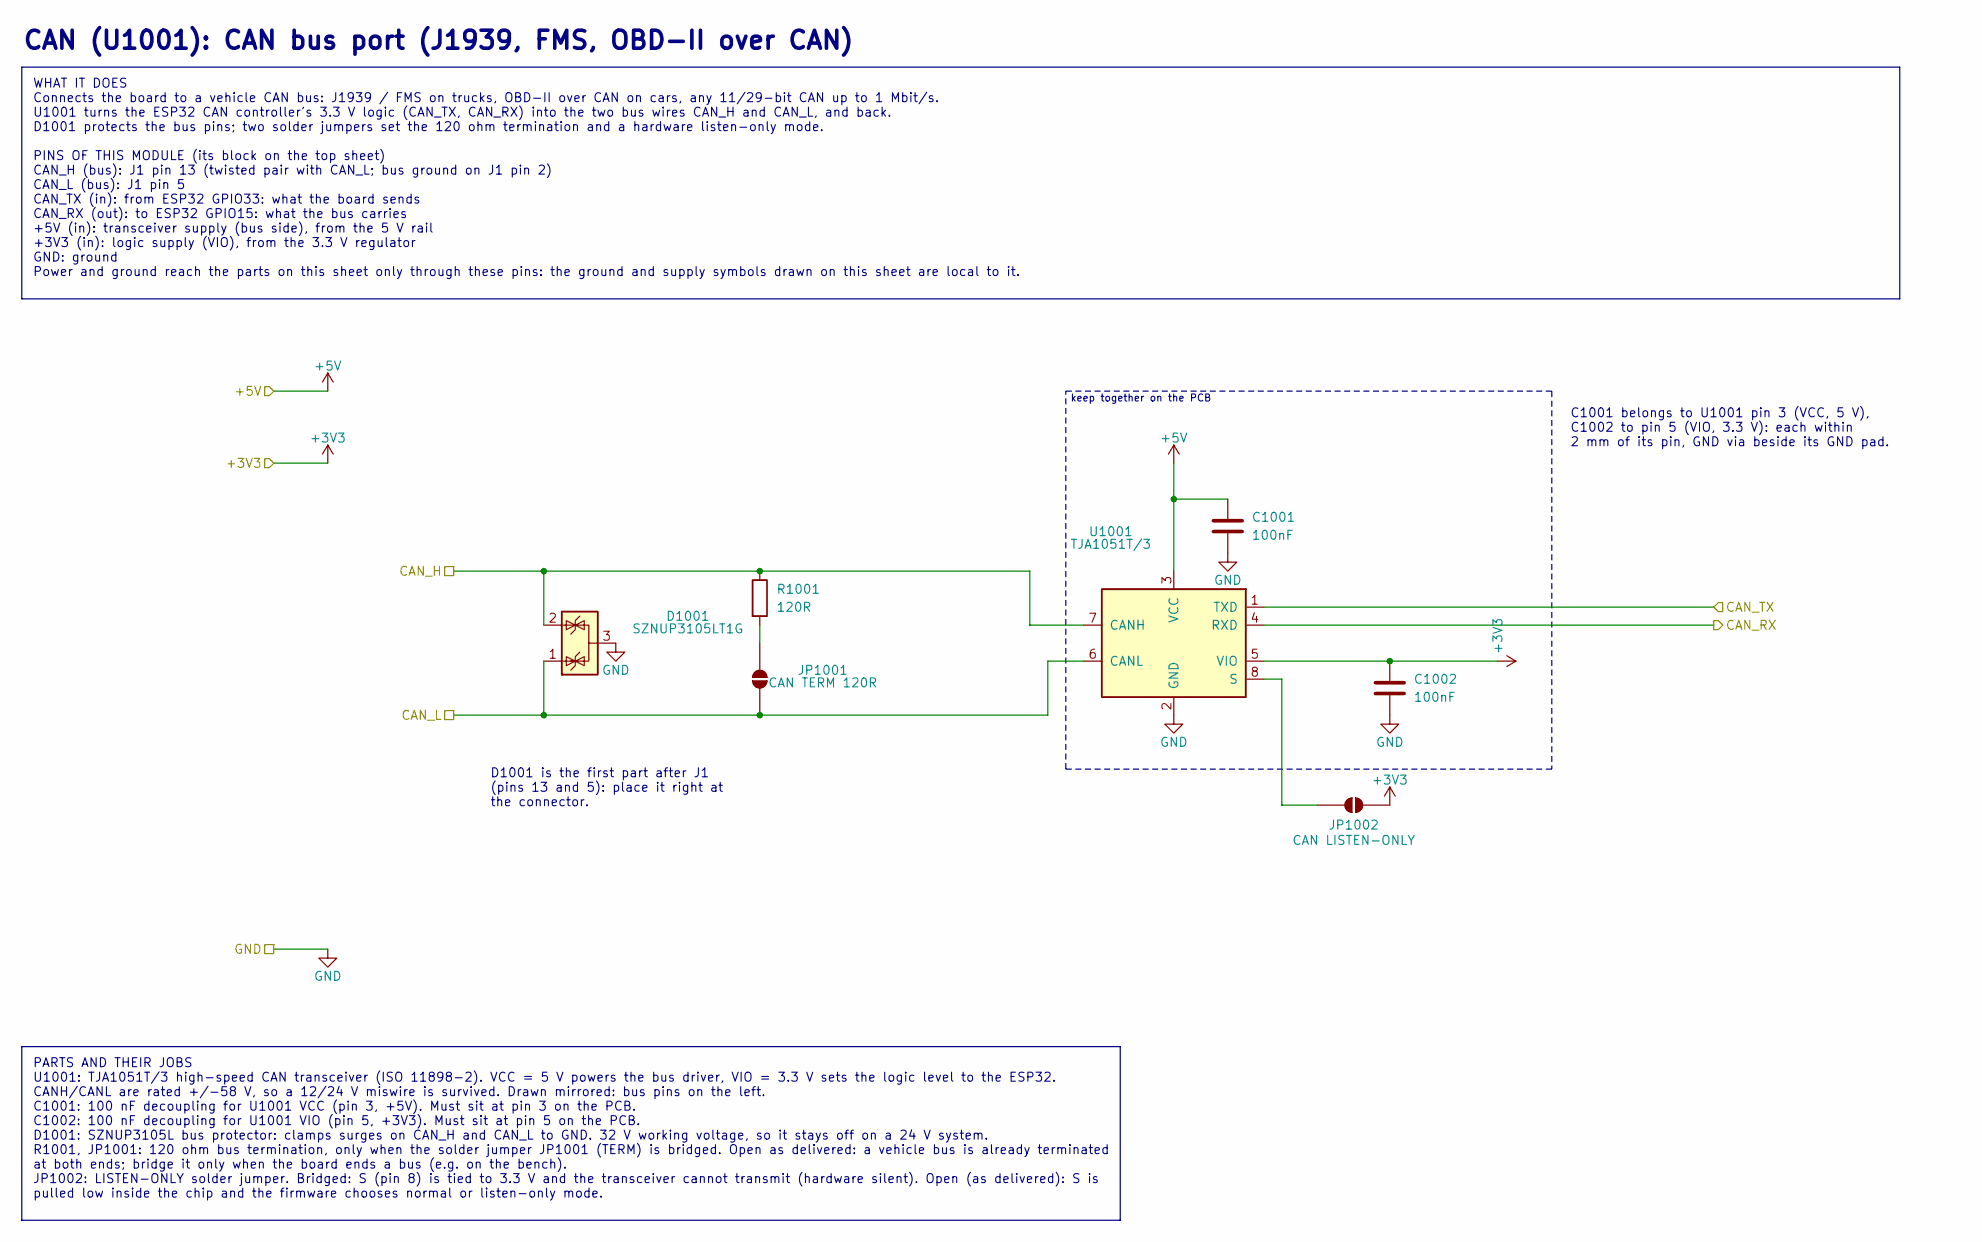
[picture p23: schematic can.kicad_sch, CAN (U1001)]

Parts:
C1001, C1002: 100nF; C_0603_1608Metric; MPN CC0603KRX7R9BB104; LCSC C14663
D1001: SZNUP3105LT1G; SOT-23; MPN SZNUP3105LT1G; LCSC C233434
JP1001: CAN TERM 120R; SolderJumper-2_P1.3mm_Open_RoundedPad1.0x1.5mm
JP1002: CAN LISTEN-ONLY; SolderJumper-2_P1.3mm_Open_RoundedPad1.0x1.5mm
R1001: 120R; R_0805_2012Metric; MPN 0805W8F1200T5E; LCSC C17437
U1001: TJA1051T/3; SOIC-8_3.9x4.9mm_P1.27mm; MPN TJA1051T/3/1J; LCSC C38695

Connections:
+3V3: C1002.1, JP1002.1 (A), U1001.5 (VIO); also elsewhere on the board
+5V: C1001.1, U1001.3 (VCC); also elsewhere on the board
/CAN_H: D1001.2 (K), R1001.1, U1001.7 (CANH); also elsewhere on the board
/CAN_L: D1001.1 (K), JP1001.1 (A), U1001.6 (CANL); also elsewhere on the board
/CAN_RX: U1001.4 (RXD); also elsewhere on the board
/CAN_TX: U1001.1 (TXD); also elsewhere on the board
GND: C1001.2, C1002.2, D1001.3 (A), U1001.2 (GND); also elsewhere on the board
unnamed: JP1001.2 (B), R1001.2
unnamed: JP1002.2 (B), U1001.8 (S)

Notes on the sheet:
CAN (U1001): CAN bus port (J1939, FMS, OBD-II over CAN)
WHAT IT DOES Connects the board to a vehicle CAN bus: J1939 / FMS on trucks, OBD-II over CAN on cars, any 11/29-bit CAN up to 1 Mbit/s. U1001 turns the ESP32 CAN controller's 3.3 V logic (CAN_TX, CAN_RX) into the two bus wires CAN_H and CAN_L, and back. D1001 protects the bus pins; two solder jumpe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
keep together on the PCB
C1001 belongs to U1001 pin 3 (VCC, 5 V), C1002 to pin 5 (VIO, 3.3 V): each within 2 mm of its pin, GND via beside its GND pad.
D1001 is the first part after J1 (pins 13 and 5): place it right at the connector.
PARTS AND THEIR JOBS U1001: TJA1051T/3 high-speed CAN transceiver (ISO 11898-2). VCC = 5 V powers the bus driver, VIO = 3.3 V sets the logic level to the ESP32. CANH/CANL are rated +/-58 V, so a 12/24 V miswire is survived. Drawn mirrored: bus pins on the left. C1001: 100 nF decoupling for U1001 VC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

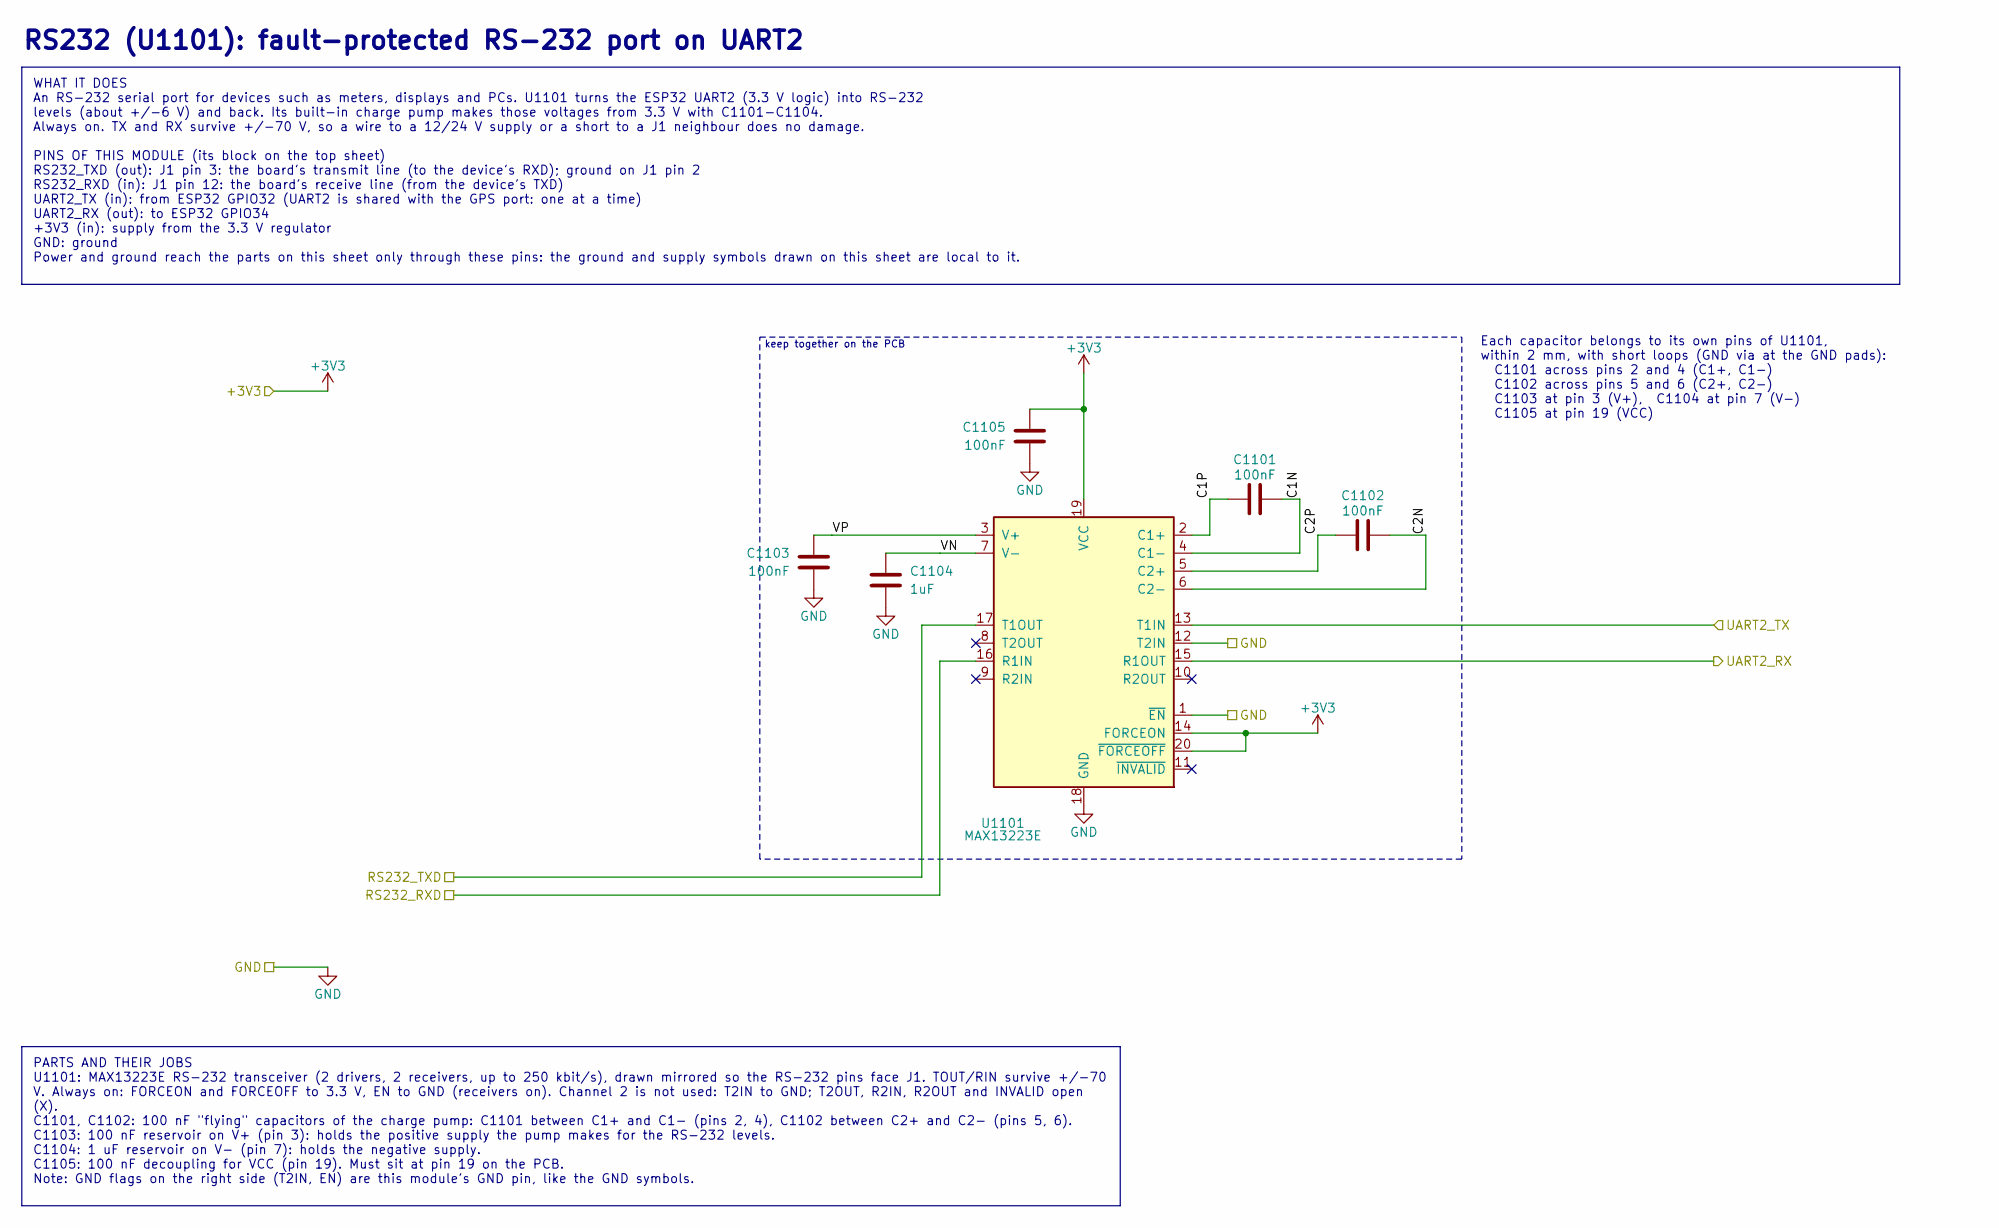
[picture p24: schematic rs232.kicad_sch, RS232 (U1101)]

Parts:
C1101, C1102, C1103, C1105: 100nF; C_0603_1608Metric; MPN CC0603KRX7R9BB104; LCSC C14663
C1104: 1uF; C_0603_1608Metric; MPN CL10A105KB8NNNC; LCSC C15849
U1101: MAX13223E; TSSOP-20_4.4x6.5mm_P0.65mm; MPN MAX13223EEUP+T; LCSC C118523

Connections:
+3V3: C1105.1, U1101.14 (FORCEON), U1101.19 (VCC), U1101.20 (~FORCEOFF); also elsewhere on the board
/RS232 (U1101)/C1N: C1101.2, U1101.4 (C1-)
/RS232 (U1101)/C1P: C1101.1, U1101.2 (C1+)
/RS232 (U1101)/C2N: C1102.2, U1101.6 (C2-)
/RS232 (U1101)/C2P: C1102.1, U1101.5 (C2+)
/RS232 (U1101)/VN: C1104.1, U1101.7 (V-)
/RS232 (U1101)/VP: C1103.1, U1101.3 (V+)
/RS232_RXD: U1101.16 (R1IN); also elsewhere on the board
/RS232_TXD: U1101.17 (T1OUT); also elsewhere on the board
/UART2_RX: U1101.15 (R1OUT); also elsewhere on the board
/UART2_TX: U1101.13 (T1IN); also elsewhere on the board
GND: C1103.2, C1104.2, C1105.2, U1101.1 (~EN), U1101.12 (T2IN), U1101.18 (GND); also elsewhere on the board

Notes on the sheet:
RS232 (U1101): fault-protected RS-232 port on UART2
WHAT IT DOES An RS-232 serial port for devices such as meters, displays and PCs. U1101 turns the ESP32 UART2 (3.3 V logic) into RS-232 levels (about +/-6 V) and back. Its built-in charge pump makes those voltages from 3.3 V with C1101-C1104. Always on. TX and RX survive +/-70 V, so a wire to a 12/2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
keep together on the PCB
Each capacitor belongs to its own pins of U1101, within 2 mm, with short loops (GND via at the GND pads): C1101 across pins 2 and 4 (C1+, C1-) C1102 across pins 5 and 6 (C2+, C2-) C1103 at pin 3 (V+), C1104 at pin 7 (V-) C1105 at pin 19 (VCC)
PARTS AND THEIR JOBS U1101: MAX13223E RS-232 transceiver (2 drivers, 2 receivers, up to 250 kbit/s), drawn mirrored so the RS-232 pins face J1. TOUT/RIN survive +/-70 V. Always on: FORCEON and FORCEOFF to 3.3 V, EN to GND (receivers on). Channel 2 is not used: T2IN to GND; T2OUT, R2IN, R2OUT and IN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
