ilomon10/embedded-totalizer-hour-meter/schematic/hour-meter-board/hour-meter-board.kicad_pcb

## KiCad design schematic/hour-meter-board/hour-meter-board.kicad_pcb (continued)

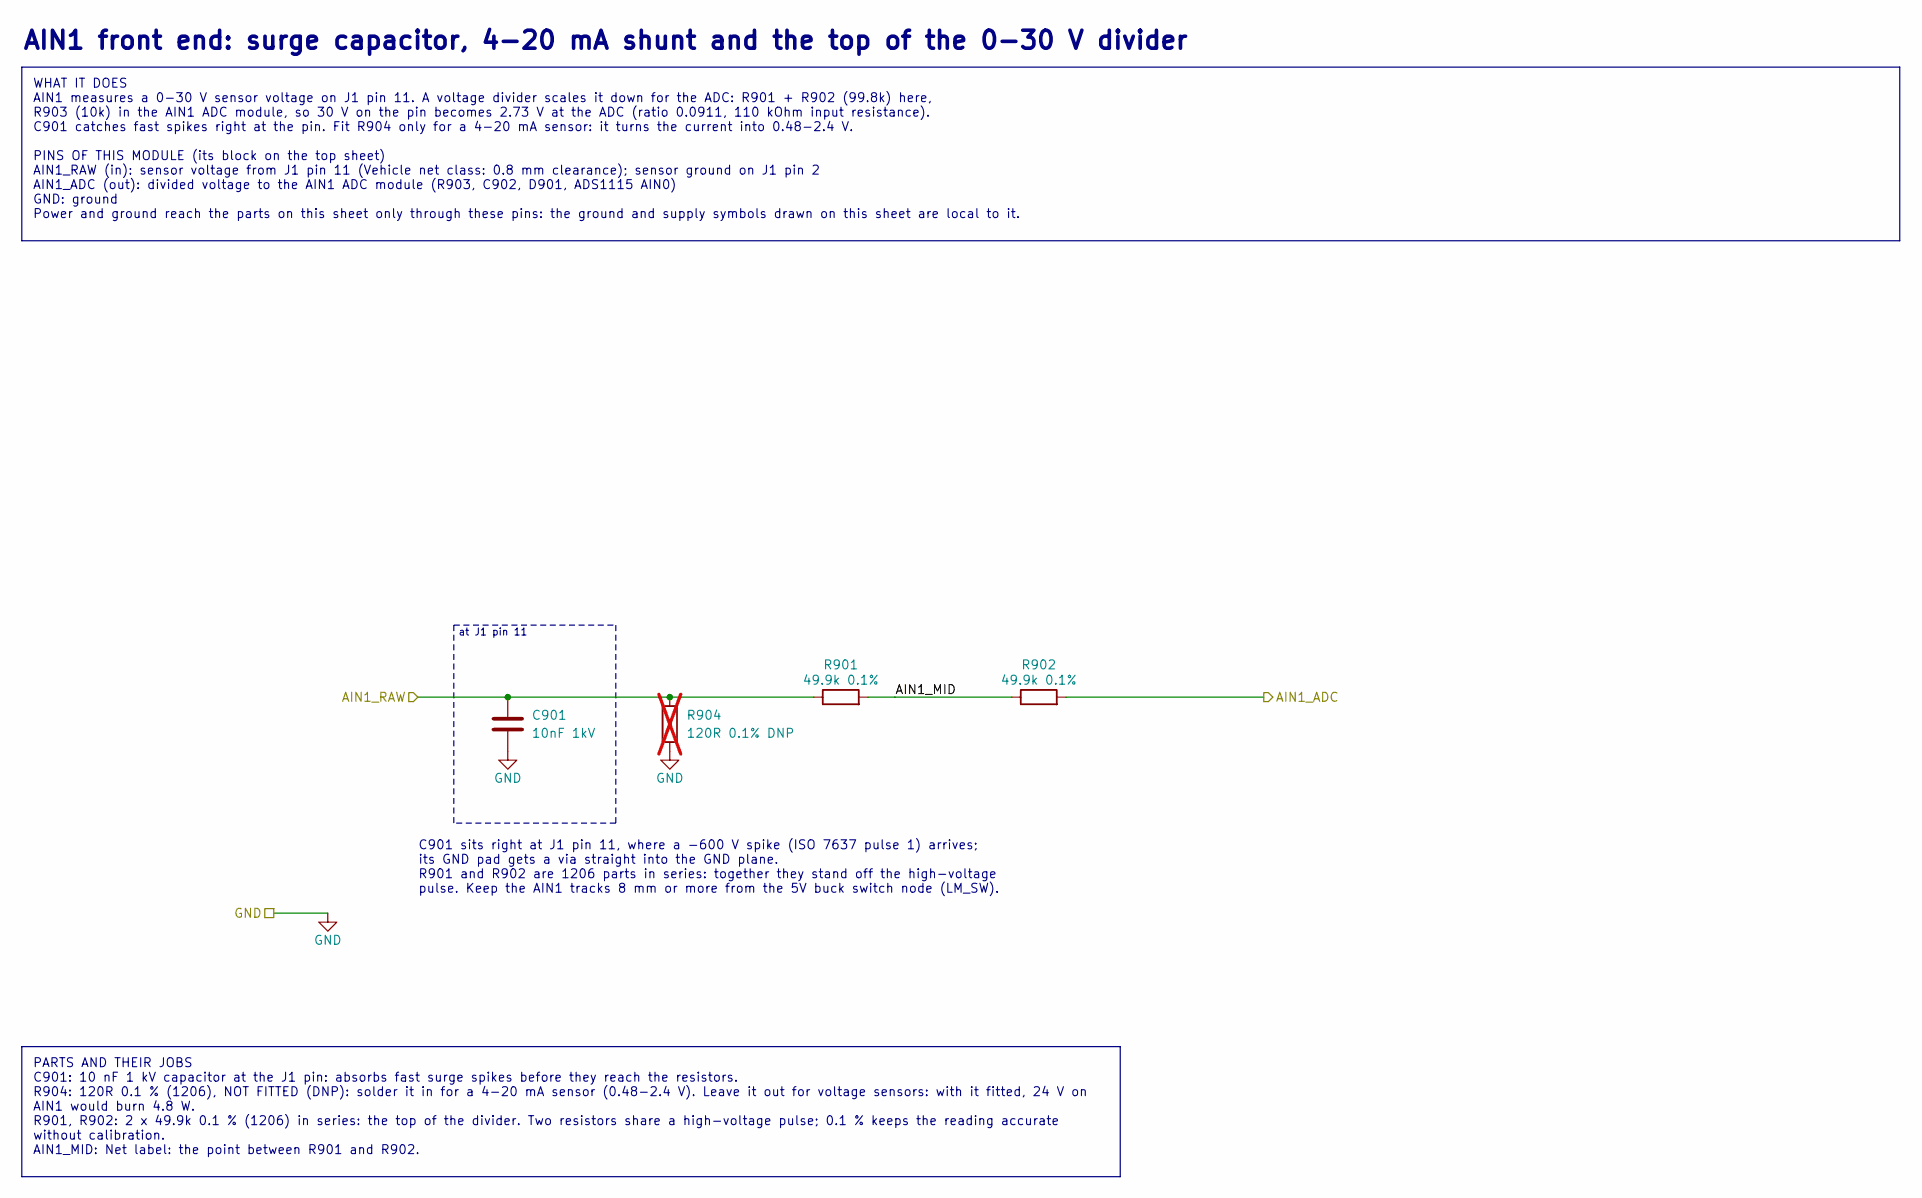
[picture p25: schematic ain1-front-end.kicad_sch, AIN1 front end]

Parts:
C901: 10nF 1kV; C_1206_3216Metric; MPN 1206B103K102NT; LCSC C9194
R901, R902: 49.9k 0.1%; R_1206_3216Metric; MPN RT1206BRD0749K9L; LCSC C706414
R904: 120R 0.1% DNP; R_1206_3216Metric; not fitted

Connections:
/AIN1 front end/AIN1_MID: R901.2, R902.1
/AIN1_ADC: R902.2; also elsewhere on the board
/AIN1_RAW: C901.1, R901.1, R904.1; also elsewhere on the board
GND: C901.2, R904.2; also elsewhere on the board

Notes on the sheet:
AIN1 front end: surge capacitor, 4-20 mA shunt and the top of the 0-30 V divider
WHAT IT DOES AIN1 measures a 0-30 V sensor voltage on J1 pin 11. A voltage divider scales it down for the ADC: R901 + R902 (99.8k) here, R903 (10k) in the AIN1 ADC module, so 30 V on the pin becomes 2.73 V at the ADC (ratio 0.0911, 110 kOhm input resistance). C901 catches fast spikes right at the p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
at J1 pin 11
C901 sits right at J1 pin 11, where a -600 V spike (ISO 7637 pulse 1) arrives; its GND pad gets a via straight into the GND plane. R901 and R902 are 1206 parts in series: together they stand off the high-voltage pulse. Keep the AIN1 tracks 8 mm or more from the 5V buck switch node (LM_SW).
PARTS AND THEIR JOBS C901: 10 nF 1 kV capacitor at the J1 pin: absorbs fast surge spikes before they reach the resistors. R904: 120R 0.1 % (1206), NOT FITTED (DNP): solder it in for a 4-20 mA sensor (0.48-2.4 V). Leave it out for voltage sensors: with it fitted, 24 V on AIN1 would burn 4.8 W. R901,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

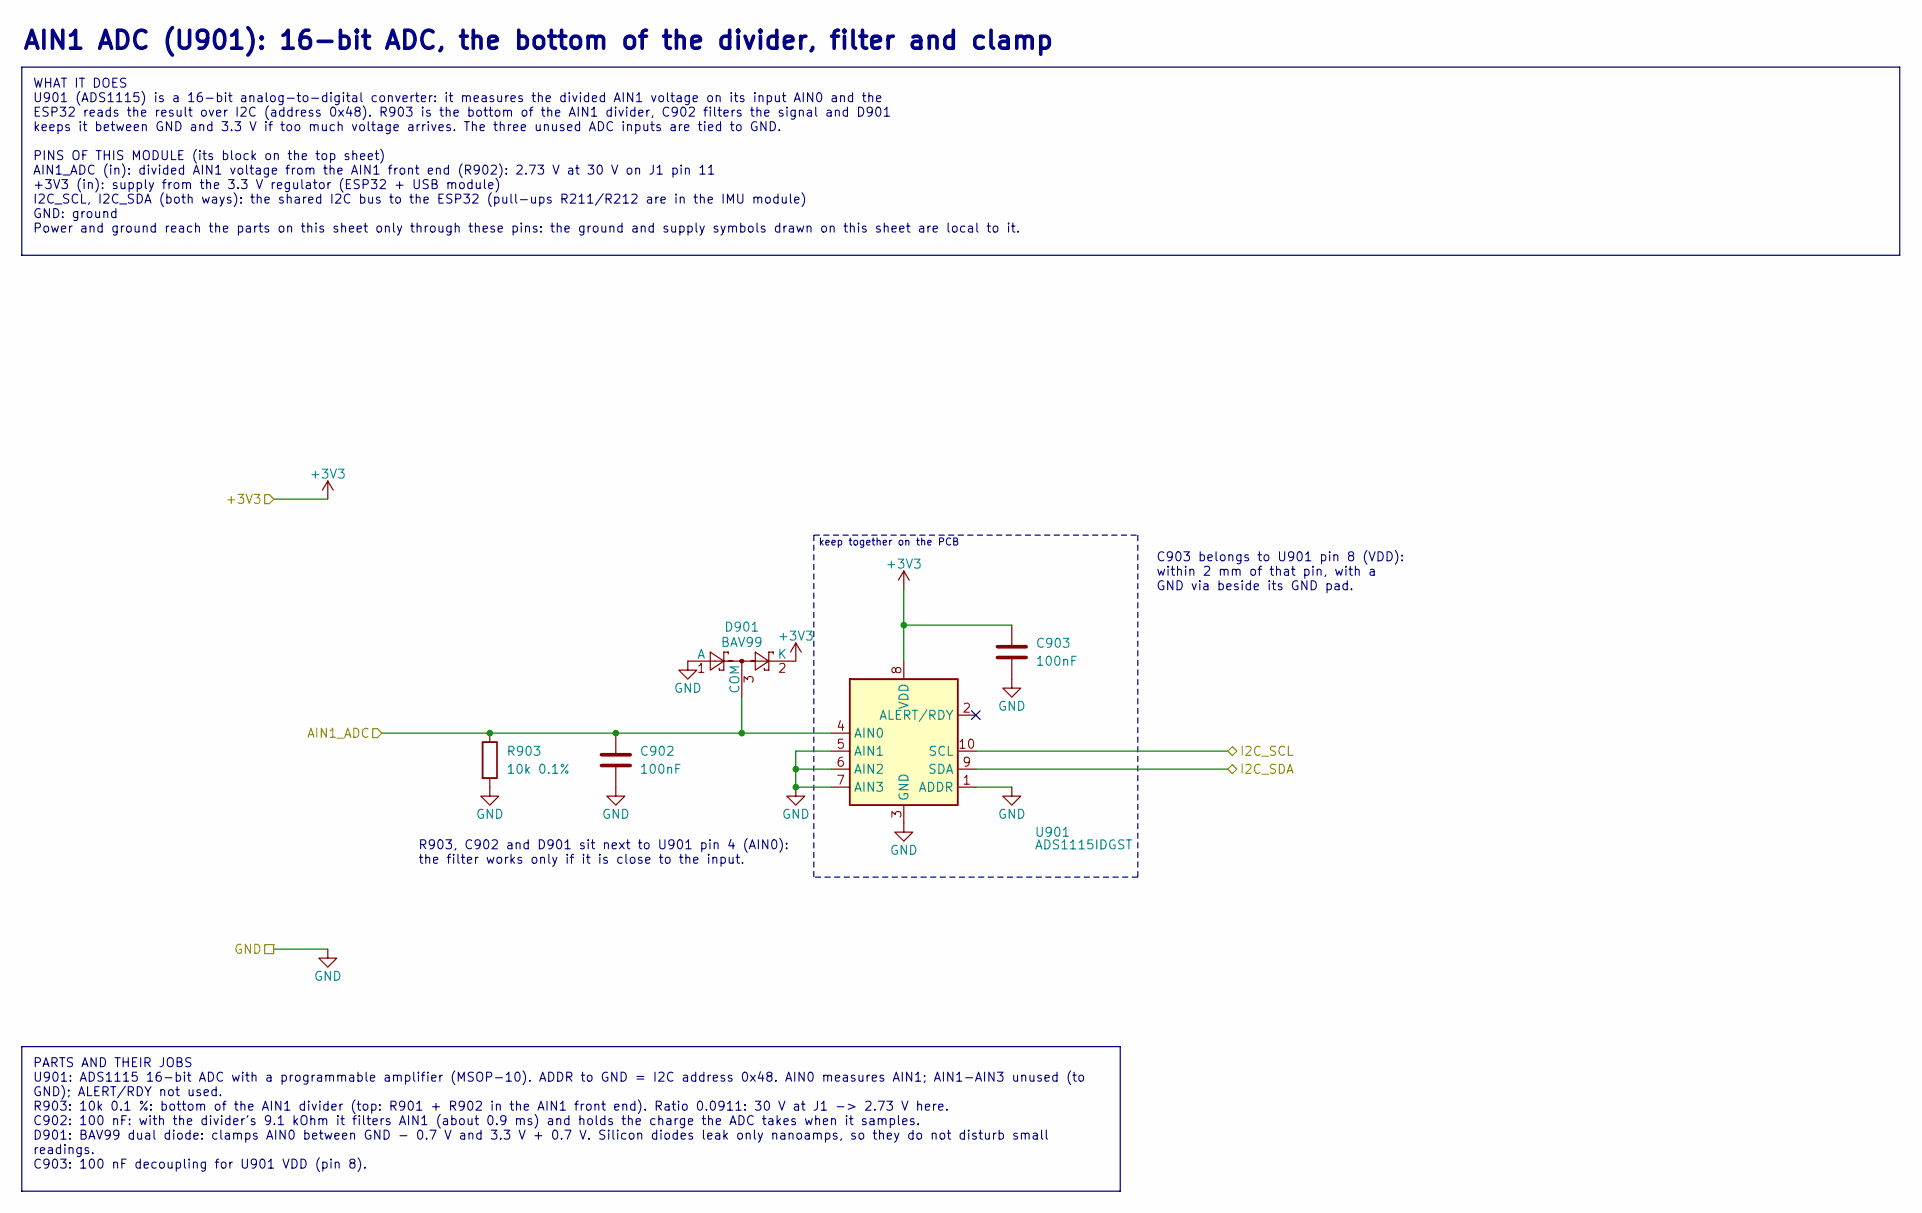
[picture p26: schematic ain1-adc.kicad_sch, AIN1 ADC (U901)]

Parts:
C902, C903: 100nF; C_0603_1608Metric; MPN CC0603KRX7R9BB104; LCSC C14663
D901: BAV99; SOT-23; MPN BAV99; LCSC C68983
R903: 10k 0.1%; R_0603_1608Metric; MPN RT0603BRD0710KL; LCSC C95204
U901: ADS1115IDGST; TSSOP-10_3x3mm_P0.5mm; MPN ADS1115IDGST; LCSC C468683

Connections:
+3V3: C903.1, D901.2 (K), U901.8 (VDD); also elsewhere on the board
/AIN1_ADC: C902.1, D901.3 (COM), R903.1, U901.4 (AIN0); also elsewhere on the board
/I2C_SCL: U901.10 (SCL); also elsewhere on the board
/I2C_SDA: U901.9 (SDA); also elsewhere on the board
GND: C902.2, C903.2, D901.1 (A), R903.2, U901.1 (ADDR), U901.3 (GND), U901.5 (AIN1), U901.6 (AIN2), U901.7 (AIN3); also elsewhere on the board

Notes on the sheet:
AIN1 ADC (U901): 16-bit ADC, the bottom of the divider, filter and clamp
WHAT IT DOES U901 (ADS1115) is a 16-bit analog-to-digital converter: it measures the divided AIN1 voltage on its input AIN0 and the ESP32 reads the result over I2C (address 0x48). R903 is the bottom of the AIN1 divider, C902 filters the signal and D901 keeps it between GND and 3.3 V if too much vol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
keep together on the PCB
C903 belongs to U901 pin 8 (VDD): within 2 mm of that pin, with a GND via beside its GND pad.
R903, C902 and D901 sit next to U901 pin 4 (AIN0): the filter works only if it is close to the input.
PARTS AND THEIR JOBS U901: ADS1115 16-bit ADC with a programmable amplifier (MSOP-10). ADDR to GND = I2C address 0x48. AIN0 measures AIN1; AIN1-AIN3 unused (to GND); ALERT/RDY not used. R903: 10k 0.1 %: bottom of the AIN1 divider (top: R901 + R902 in the AIN1 front end). Ratio 0.0911: 30 V at J1 ->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

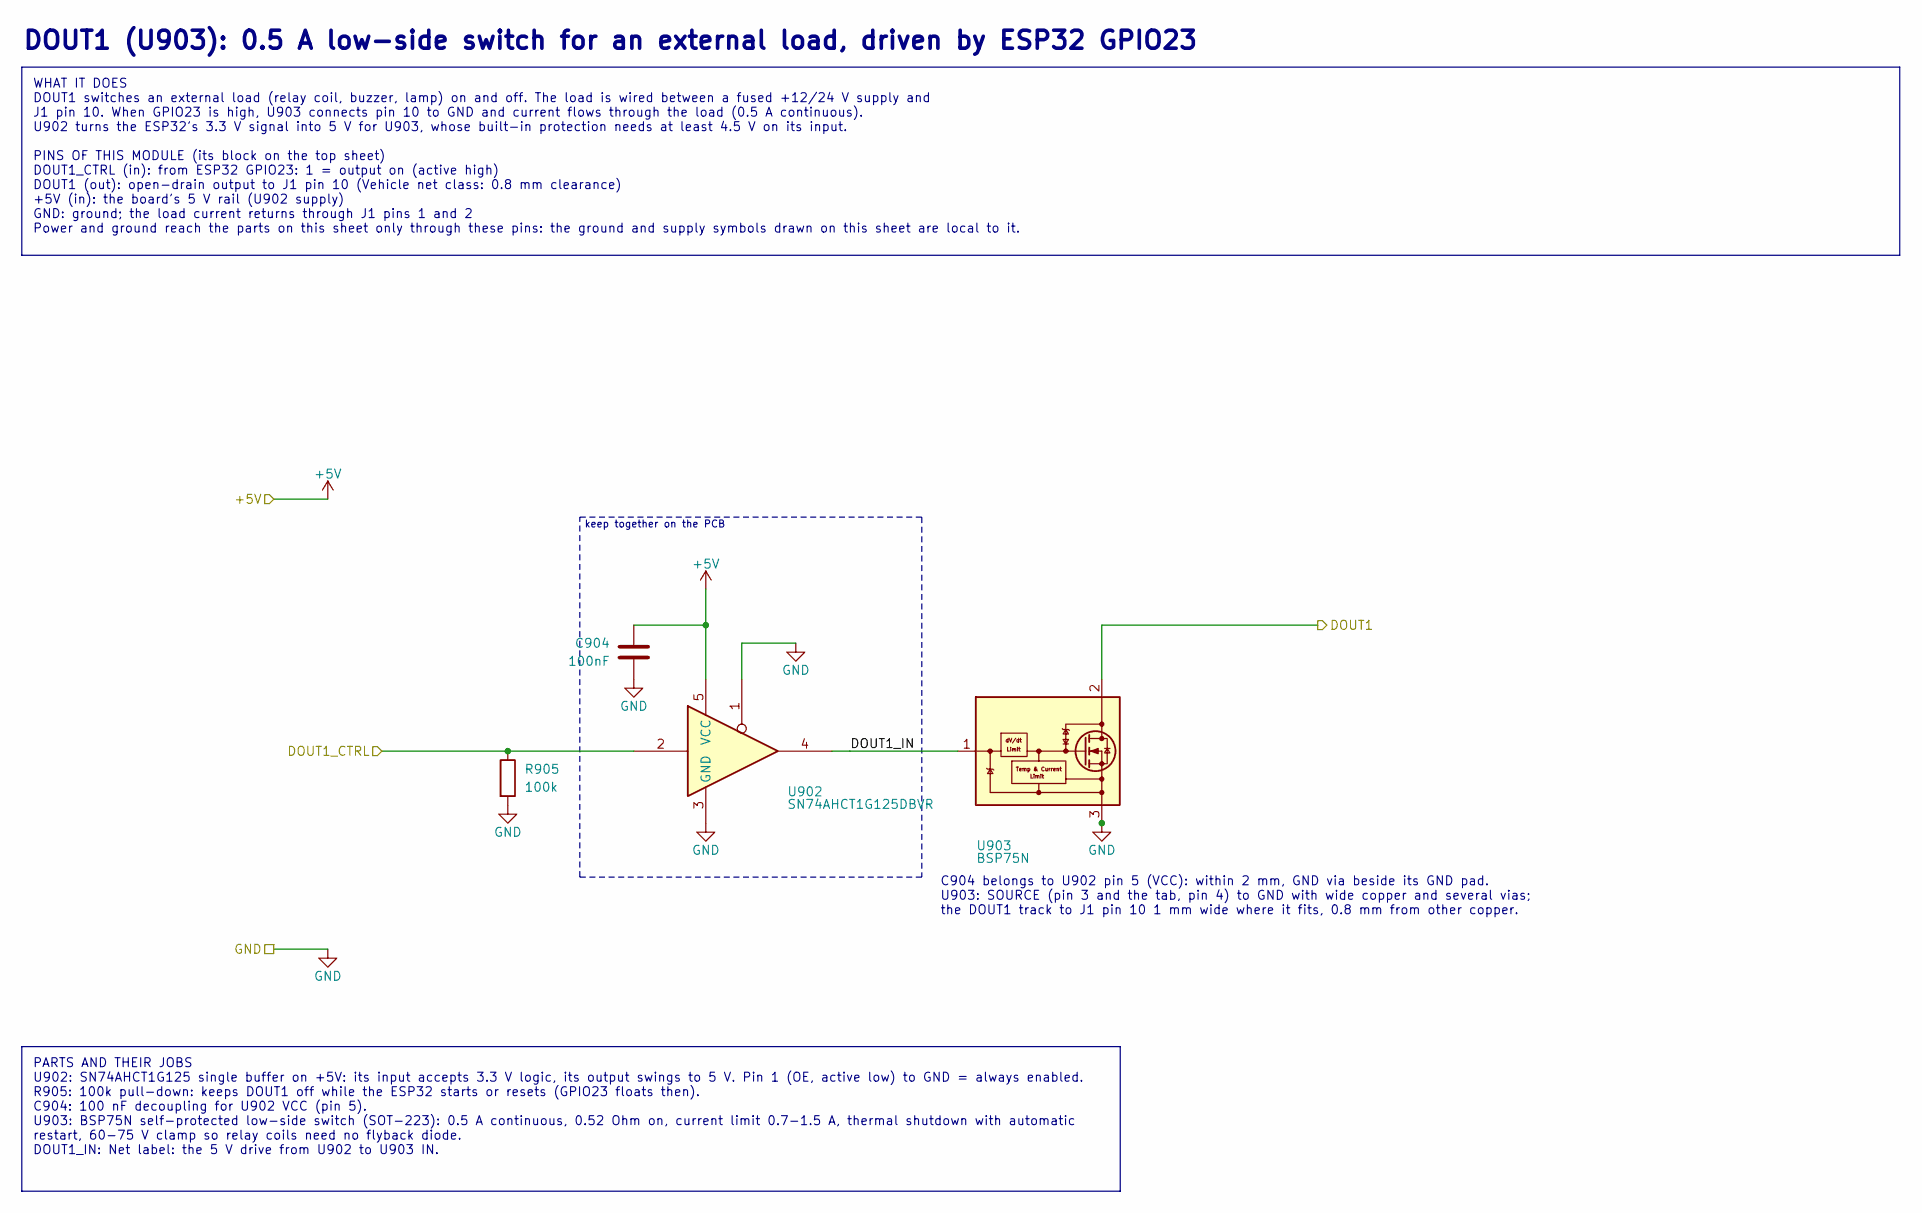
[picture p27: schematic dout1.kicad_sch, DOUT1 (U903)]

Parts:
C904: 100nF; C_0603_1608Metric; MPN CC0603KRX7R9BB104; LCSC C14663
R905: 100k; R_0603_1608Metric; MPN 0603WAF1003T5E; LCSC C25803
U902: SN74AHCT1G125DBVR; SOT-23-5; MPN SN74AHCT1G125DBVR; LCSC C7484
U903: BSP75N; SOT-223; MPN BSP75NTA; LCSC C172450

Connections:
+5V: C904.1, U902.5 (VCC); also elsewhere on the board
/DOUT1: U903.2 (DRAIN); also elsewhere on the board
/DOUT1 (U903)/DOUT1_IN: U902.4, U903.1 (IN)
/DOUT1_CTRL: R905.1, U902.2; also elsewhere on the board
GND: C904.2, R905.2, U902.1, U902.3 (GND), U903.3 (SOURCE), U903.4 (SOURCE); also elsewhere on the board

Notes on the sheet:
DOUT1 (U903): 0.5 A low-side switch for an external load, driven by ESP32 GPIO23
WHAT IT DOES DOUT1 switches an external load (relay coil, buzzer, lamp) on and off. The load is wired between a fused +12/24 V supply and J1 pin 10. When GPIO23 is high, U903 connects pin 10 to GND and current flows through the load (0.5 A continuous). U902 turns the ESP32's 3.3 V signal into 5 V f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
keep together on the PCB
C904 belongs to U902 pin 5 (VCC): within 2 mm, GND via beside its GND pad. U903: SOURCE (pin 3 and the tab, pin 4) to GND with wide copper and several vias; the DOUT1 track to J1 pin 10 1 mm wide where it fits, 0.8 mm from other copper.
PARTS AND THEIR JOBS U902: SN74AHCT1G125 single buffer on +5V: its input accepts 3.3 V logic, its output swings to 5 V. Pin 1 (OE, active low) to GND = always enabled. R905: 100k pull-down: keeps DOUT1 off while the ESP32 starts or resets (GPIO23 floats then). C904: 100 nF decoupling for U902 VCC (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

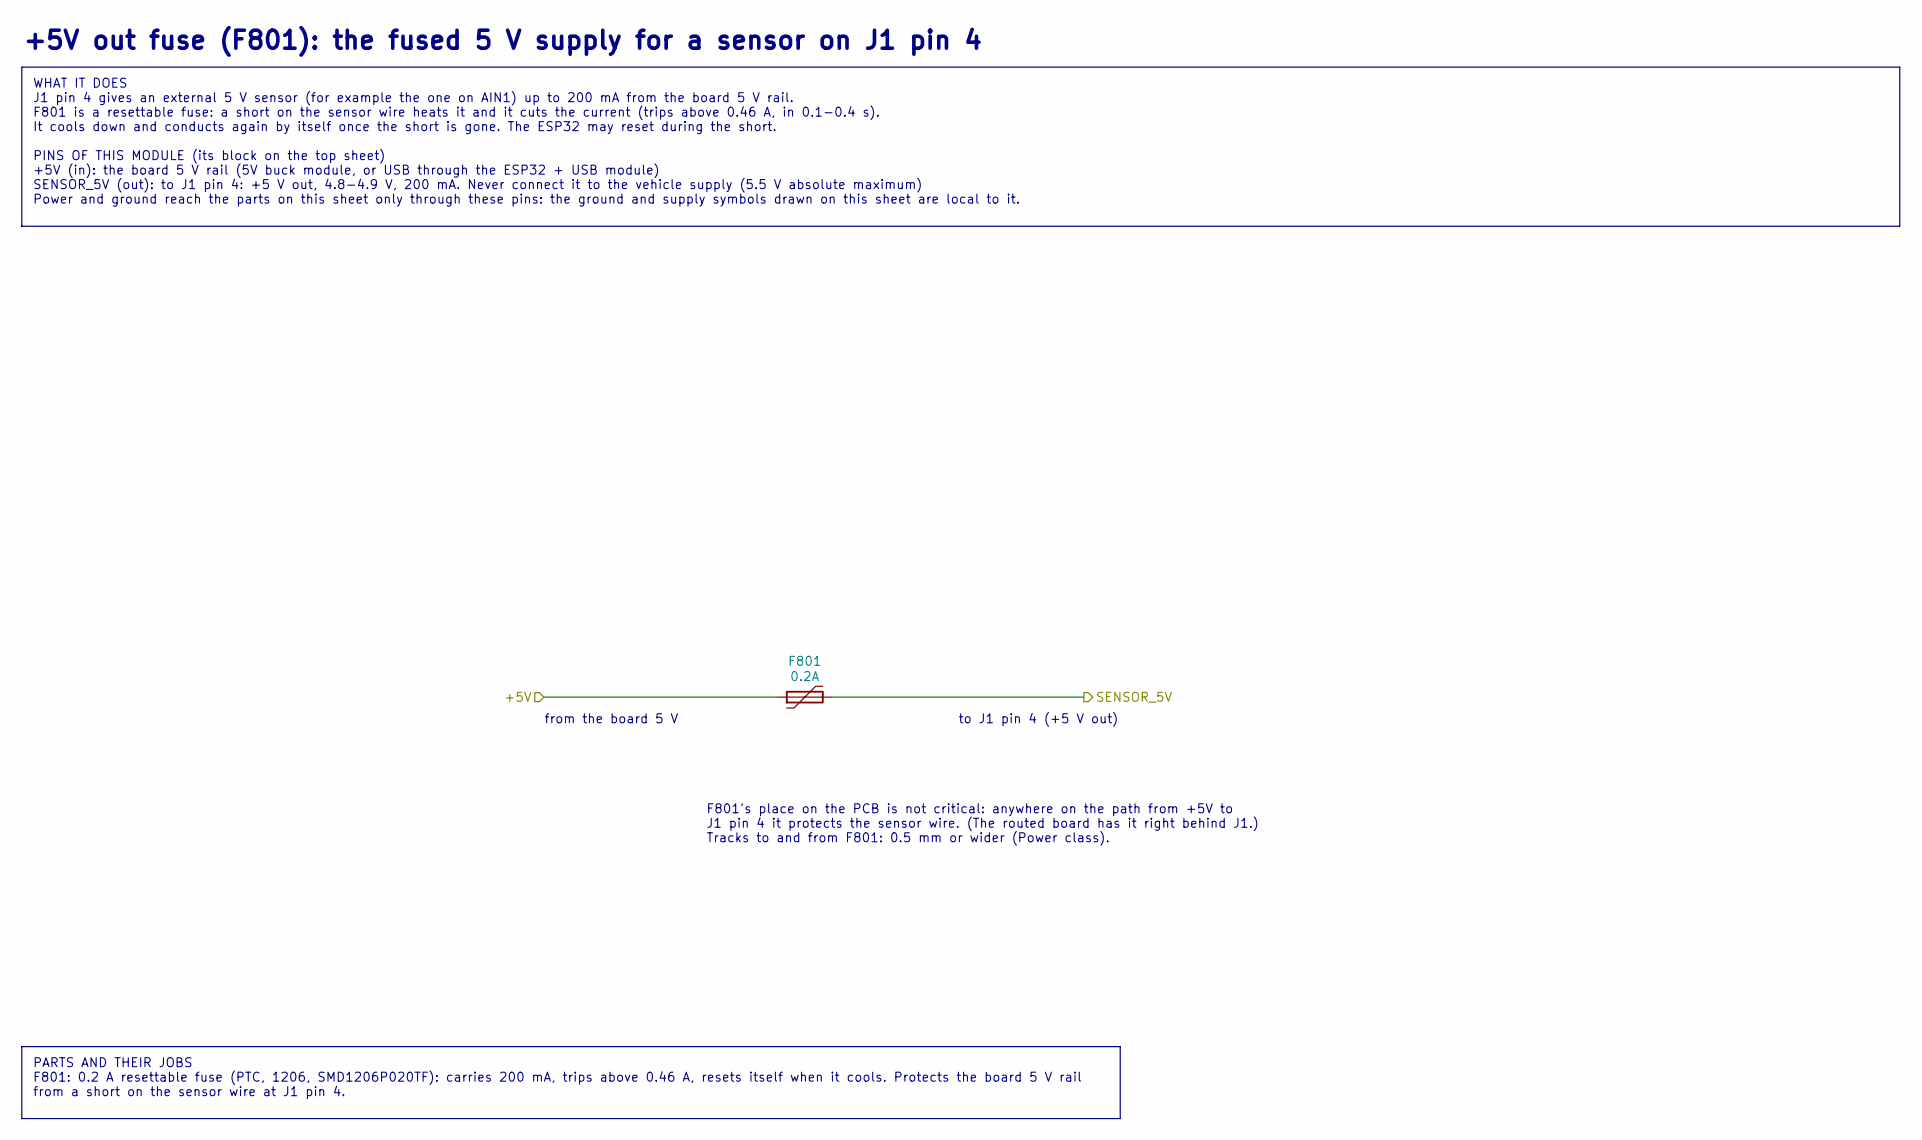
[picture p28: schematic fuse-5v-out.kicad_sch, +5V out fuse (F801)]

Parts:
F801: 0.2A; Fuse_1206_3216Metric; MPN SMD1206P020TF; LCSC C20984

Connections:
+5V: F801.1; also elsewhere on the board
/SENSOR_5V: F801.2; also elsewhere on the board

Notes on the sheet:
+5V out fuse (F801): the fused 5 V supply for a sensor on J1 pin 4
WHAT IT DOES J1 pin 4 gives an external 5 V sensor (for example the one on AIN1) up to 200 mA from the board 5 V rail. F801 is a resettable fuse: a short on the sensor wire heats it and it cuts the current (trips above 0.46 A, in 0.1-0.4 s). It cools down and conducts again by itself once the short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
from the board 5 V
to J1 pin 4 (+5 V out)
F801's place on the PCB is not critical: anywhere on the path from +5V to J1 pin 4 it protects the sensor wire. (The routed board has it right behind J1.) Tracks to and from F801: 0.5 mm or wider (Power class).
PARTS AND THEIR JOBS F801: 0.2 A resettable fuse (PTC, 1206, SMD1206P020TF): carries 200 mA, trips above 0.46 A, resets itself when it cools. Protects the board 5 V rail from a short on the sensor wire at J1 pin 4.

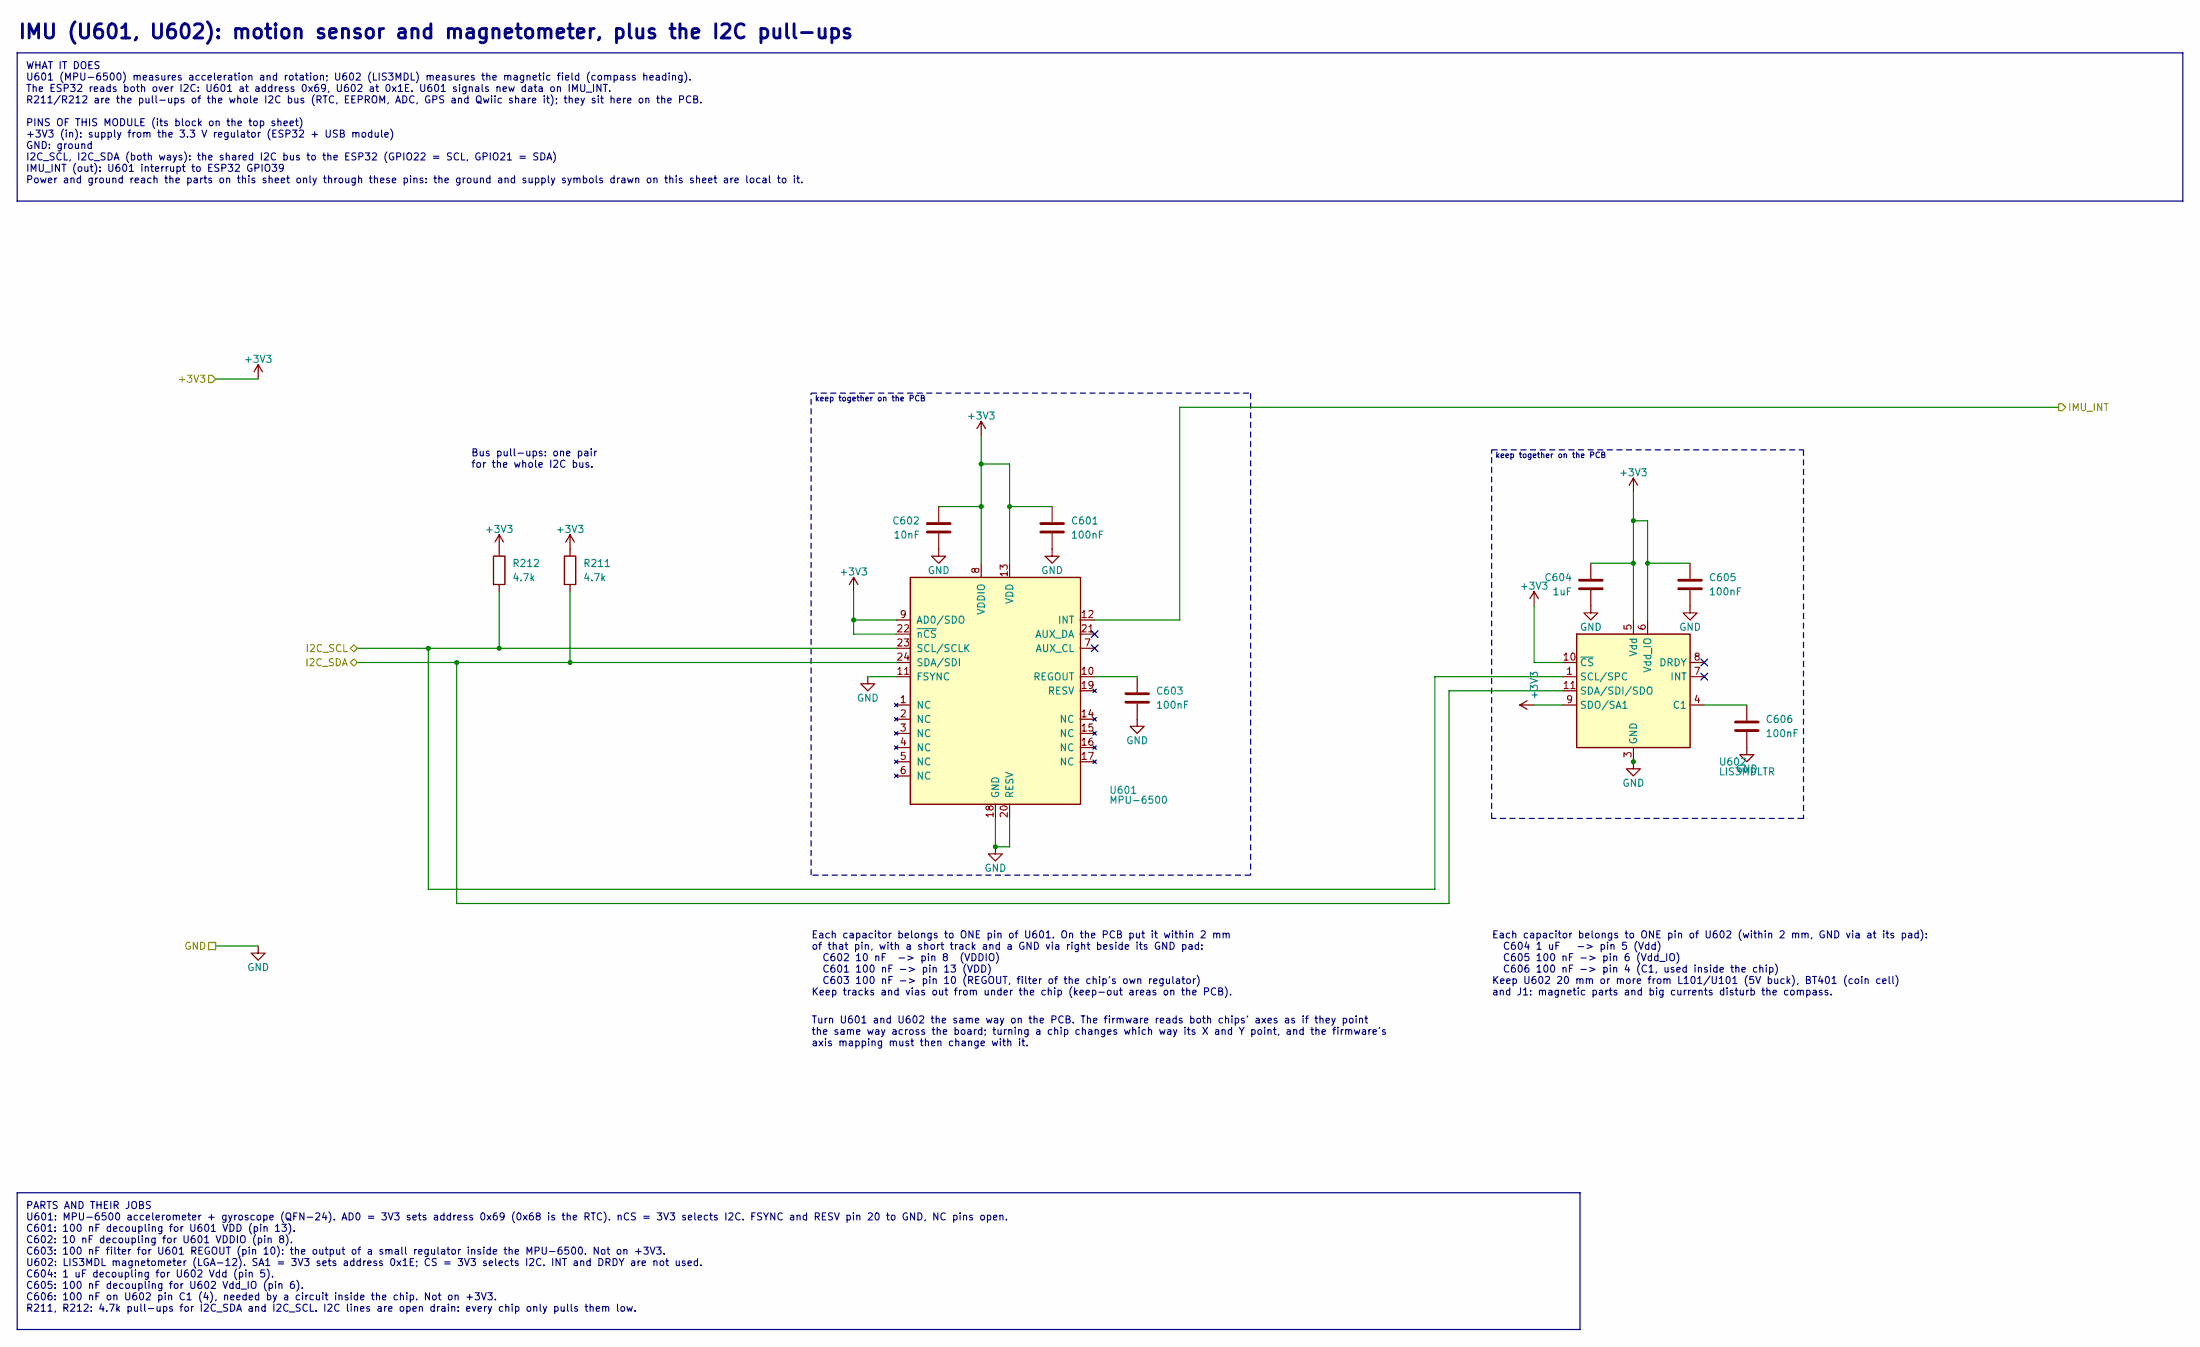
[picture p29: schematic imu.kicad_sch, IMU (U601, U602)]

Parts:
C601, C603, C605, C606: 100nF; C_0603_1608Metric; MPN CC0603KRX7R9BB104; LCSC C14663
C602: 10nF; C_0603_1608Metric; MPN 0603B103K500NT; LCSC C57112
C604: 1uF; C_0603_1608Metric; MPN CL10A105KB8NNNC; LCSC C15849
R211, R212: 4.7k; R_0603_1608Metric; MPN 0603WAF4701T5E; LCSC C23162
U601: MPU-6500; InvenSense_QFN-24_3x3mm_P0.4mm; MPN MPU-6500; LCSC C50278
U602: LIS3MDLTR; LGA-12_2x2mm_P0.5mm; MPN LIS3MDLTR; LCSC C478483

Connections:
+3V3: C601.1, C602.1, C604.1, C605.1, R211.1, R212.1, U601.8 (VDDIO), U601.9 (AD0/SDO), U601.13 (VDD), U601.22 (~nCS), U602.5 (Vdd), U602.6 (Vdd_IO), U602.9 (SDO/SA1), U602.10 (~CS); also elsewhere on the board
/I2C_SCL: R212.2, U601.23 (SCL/SCLK), U602.1 (SCL/SPC); also elsewhere on the board
/I2C_SDA: R211.2, U601.24 (SDA/SDI), U602.11 (SDA/SDI/SDO); also elsewhere on the board
/IMU_INT: U601.12 (INT); also elsewhere on the board
GND: C601.2, C602.2, C603.2, C604.2, C605.2, C606.2, U601.11 (FSYNC), U601.18 (GND), U601.20 (RESV), U602.2 (GND), U602.3 (GND), U602.12 (GND); also elsewhere on the board
unnamed: C603.1, U601.10 (REGOUT)
unnamed: C606.1, U602.4 (C1)

Notes on the sheet:
IMU (U601, U602): motion sensor and magnetometer, plus the I2C pull-ups
WHAT IT DOES U601 (MPU-6500) measures acceleration and rotation; U602 (LIS3MDL) measures the magnetic field (compass heading). The ESP32 reads both over I2C: U601 at address 0x69, U602 at 0x1E. U601 signals new data on IMU_INT. R211/R212 are the pull-ups of the whole I2C bus (RTC, EEPROM, ADC, GPS 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
keep together on the PCB
Each capacitor belongs to ONE pin of U601. On the PCB put it within 2 mm of that pin, with a short track and a GND via right beside its GND pad: C602 10 nF -> pin 8 (VDDIO) C601 100 nF -> pin 13 (VDD) C603 100 nF -> pin 10 (REGOUT, filter of the chip's own regulator) Keep tracks and vias out from u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
Each capacitor belongs to ONE pin of U602 (within 2 mm, GND via at its pad): C604 1 uF -> pin 5 (Vdd) C605 100 nF -> pin 6 (Vdd_IO) C606 100 nF -> pin 4 (C1, used inside the chip) Keep U602 20 mm or more from L101/U101 (5V buck), BT401 (coin cell) and J1: magnetic parts and big currents disturb the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
Bus pull-ups: one pair for the whole I2C bus.
Turn U601 and U602 the same way on the PCB. The firmware reads both chips' axes as if they point the same way across the board; turning a chip changes which way its X and Y point, and the firmware's axis mapping must then change with it.
PARTS AND THEIR JOBS U601: MPU-6500 accelerometer + gyroscope (QFN-24). AD0 = 3V3 sets address 0x69 (0x68 is the RTC). nCS = 3V3 selects I2C. FSYNC and RESV pin 20 to GND, NC pins open. C601: 100 nF decoupling for U601 VDD (pin 13). C602: 10 nF decoupling for U601 VDDIO (pin 8). C603: 100 nF filter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

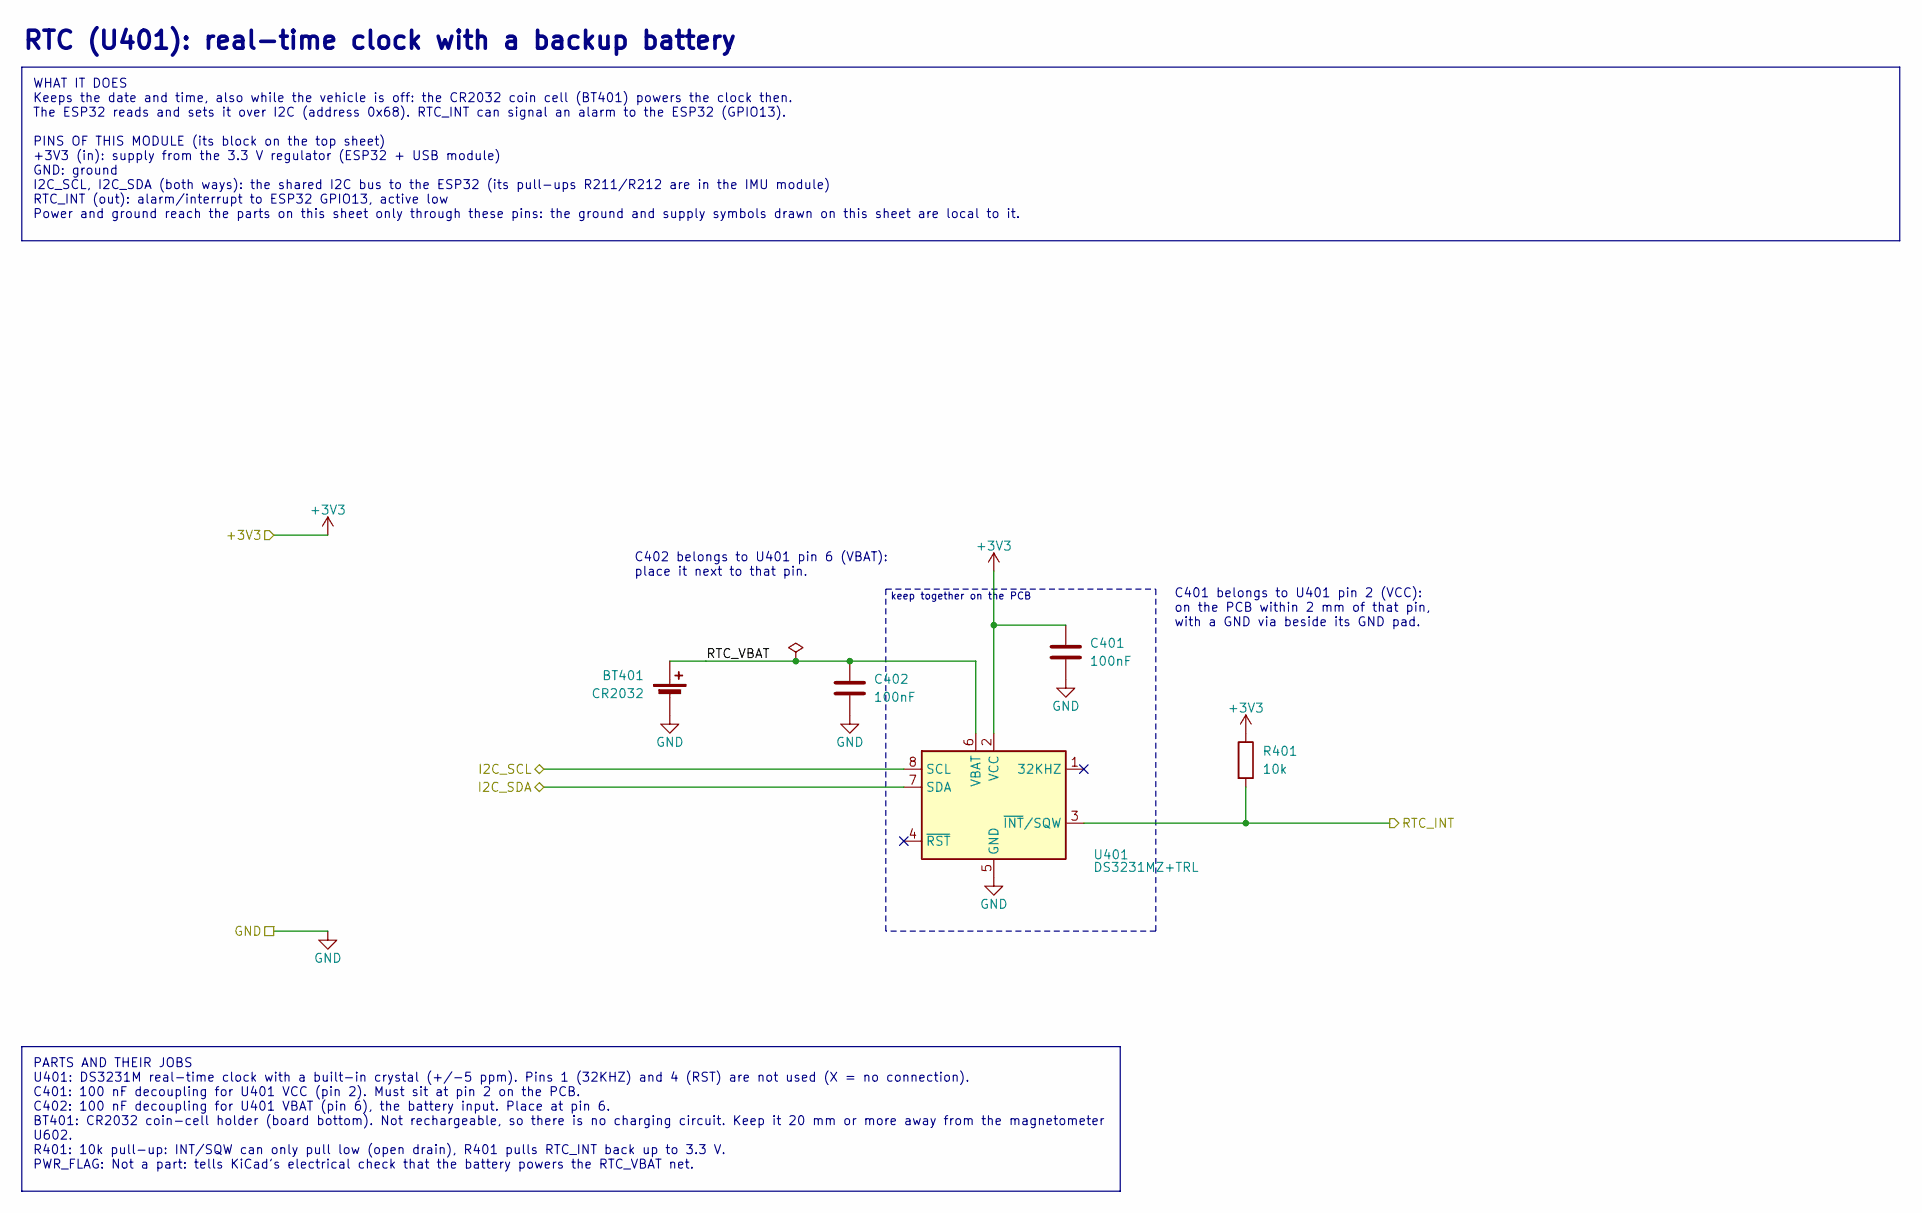
[picture p30: schematic rtc.kicad_sch, RTC (U401)]

Parts:
BT401: CR2032; BatteryHolder_MYOUNG_BS-07-A1BJ001_CR2032; MPN BS-07-A1BJ001; LCSC C2979167
C401, C402: 100nF; C_0603_1608Metric; MPN CC0603KRX7R9BB104; LCSC C14663
R401: 10k; R_0603_1608Metric; MPN 0603WAF1002T5E; LCSC C25804
U401: DS3231MZ+TRL; SOIC-8_3.9x4.9mm_P1.27mm; MPN DS3231MZ+TRL; LCSC C107410

Connections:
+3V3: C401.1, R401.1, U401.2 (VCC); also elsewhere on the board
/I2C_SCL: U401.8 (SCL); also elsewhere on the board
/I2C_SDA: U401.7 (SDA); also elsewhere on the board
/RTC (U401)/RTC_VBAT: BT401.1 (+), C402.1, U401.6 (VBAT)
/RTC_INT: R401.2, U401.3 (~INT/SQW); also elsewhere on the board
GND: BT401.2 (-), C401.2, C402.2, U401.5 (GND); also elsewhere on the board

Notes on the sheet:
RTC (U401): real-time clock with a backup battery
WHAT IT DOES Keeps the date and time, also while the vehicle is off: the CR2032 coin cell (BT401) powers the clock then. The ESP32 reads and sets it over I2C (address 0x68). RTC_INT can signal an alarm to the ESP32 (GPIO13). PINS OF THIS MODULE (its block on the top sheet) +3V3 (in): supply from th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
keep together on the PCB
C401 belongs to U401 pin 2 (VCC): on the PCB within 2 mm of that pin, with a GND via beside its GND pad.
C402 belongs to U401 pin 6 (VBAT): place it next to that pin.
PARTS AND THEIR JOBS U401: DS3231M real-time clock with a built-in crystal (+/-5 ppm). Pins 1 (32KHZ) and 4 (RST) are not used (X = no connection). C401: 100 nF decoupling for U401 VCC (pin 2). Must sit at pin 2 on the PCB. C402: 100 nF decoupling for U401 VBAT (pin 6), the battery input. Place at 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

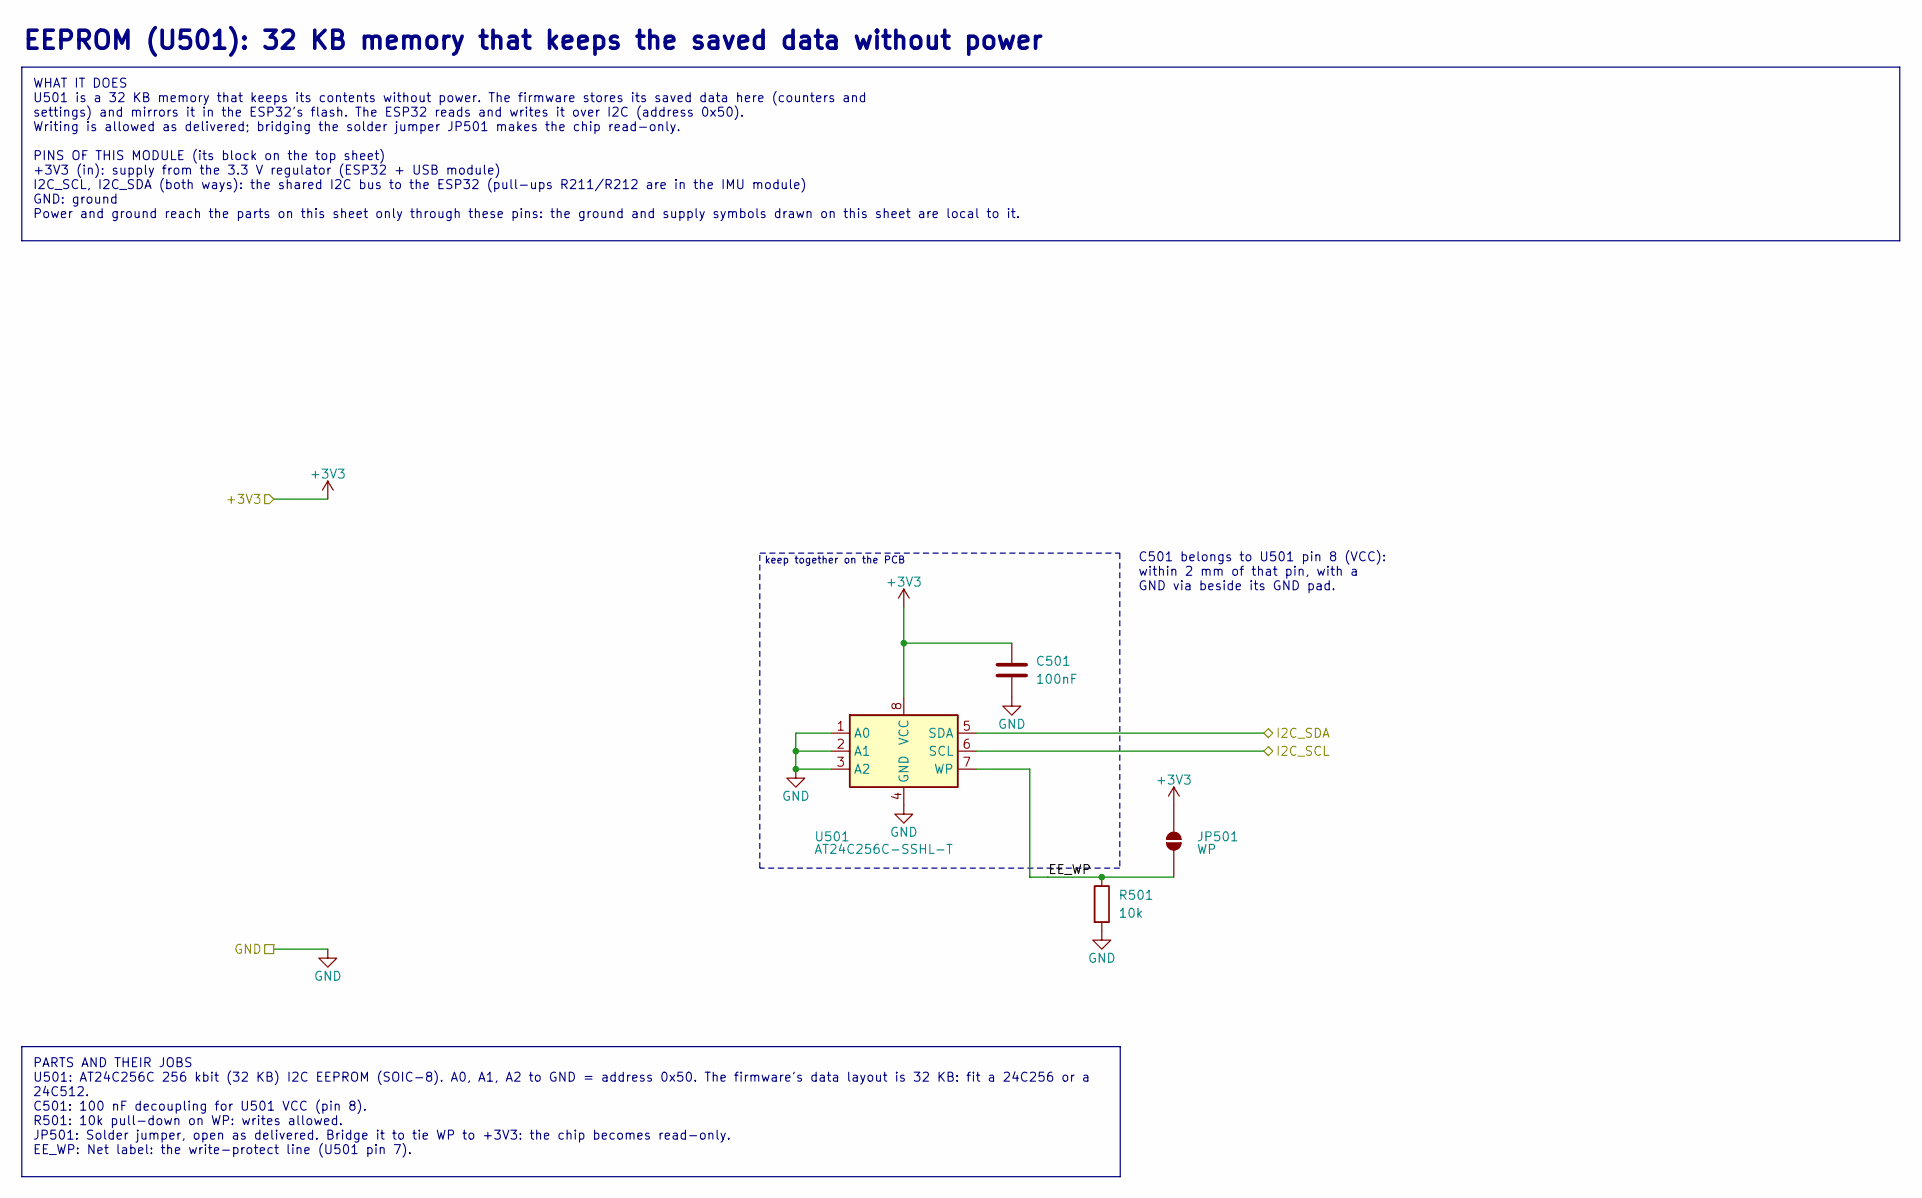
[picture p31: schematic eeprom.kicad_sch, EEPROM (U501)]

Parts:
C501: 100nF; C_0603_1608Metric; MPN CC0603KRX7R9BB104; LCSC C14663
JP501: WP; SolderJumper-2_P1.3mm_Open_RoundedPad1.0x1.5mm
R501: 10k; R_0603_1608Metric; MPN 0603WAF1002T5E; LCSC C25804
U501: AT24C256C-SSHL-T; SOIC-8_3.9x4.9mm_P1.27mm; MPN AT24C256C-SSHL-T; LCSC C6482

Connections:
+3V3: C501.1, JP501.2 (B), U501.8 (VCC); also elsewhere on the board
/EEPROM (U501)/EE_WP: JP501.1 (A), R501.1, U501.7 (WP)
/I2C_SCL: U501.6 (SCL); also elsewhere on the board
/I2C_SDA: U501.5 (SDA); also elsewhere on the board
GND: C501.2, R501.2, U501.1 (A0), U501.2 (A1), U501.3 (A2), U501.4 (GND); also elsewhere on the board

Notes on the sheet:
EEPROM (U501): 32 KB memory that keeps the saved data without power
WHAT IT DOES U501 is a 32 KB memory that keeps its contents without power. The firmware stores its saved data here (counters and settings) and mirrors it in the ESP32's flash. The ESP32 reads and writes it over I2C (address 0x50). Writing is allowed as delivered; bridging the solder jumper JP501 ma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
keep together on the PCB
C501 belongs to U501 pin 8 (VCC): within 2 mm of that pin, with a GND via beside its GND pad.
PARTS AND THEIR JOBS U501: AT24C256C 256 kbit (32 KB) I2C EEPROM (SOIC-8). A0, A1, A2 to GND = address 0x50. The firmware's data layout is 32 KB: fit a 24C256 or a 24C512. C501: 100 nF decoupling for U501 VCC (pin 8). R501: 10k pull-down on WP: writes allowed. JP501: Solder jumper, open as delivere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
