ilomon10/embedded-totalizer-hour-meter/schematic/hour-meter-board/hour-meter-board.kicad_pcb

## KiCad design schematic/hour-meter-board/hour-meter-board.kicad_pcb (continued)

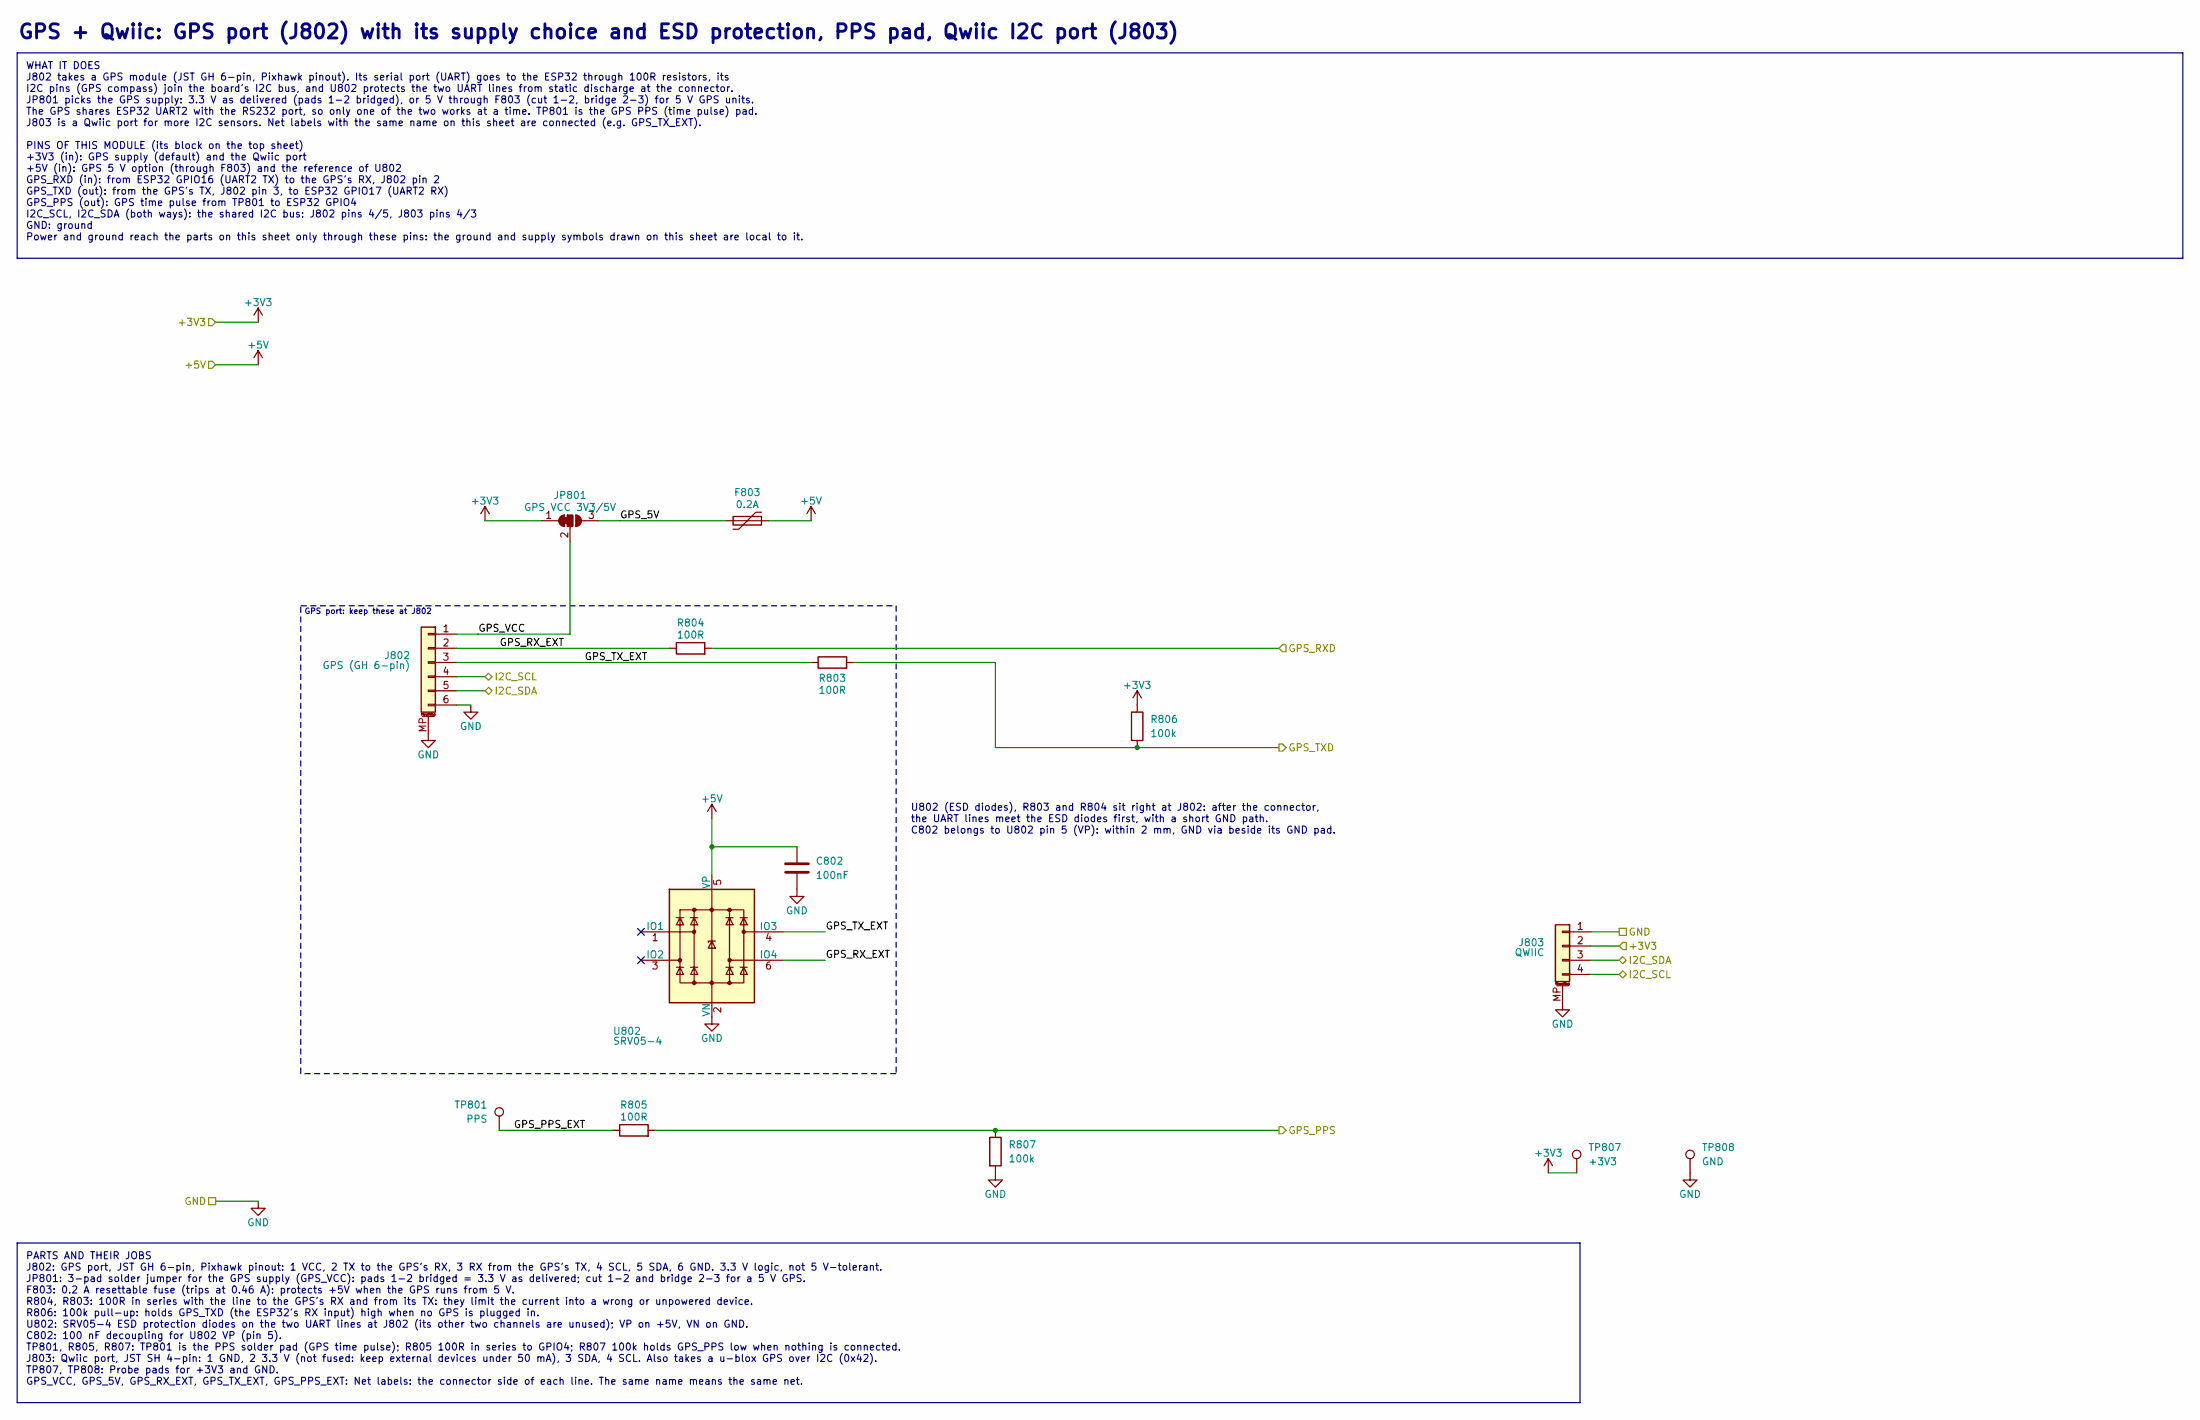
[picture p32: schematic gps-qwiic.kicad_sch, GPS + Qwiic]

Parts:
C802: 100nF; C_0603_1608Metric; MPN CC0603KRX7R9BB104; LCSC C14663
F803: 0.2A; Fuse_1206_3216Metric; MPN SMD1206P020TF; LCSC C20984
J802: GPS (GH 6-pin); JST_GH_SM06B-GHS-TB_1x06-1MP_P1.25mm_Horizontal; MPN SM06B-GHS-TB(LF)(SN); LCSC C133065
J803: QWIIC; JST_SH_SM04B-SRSS-TB_1x04-1MP_P1.00mm_Horizontal; MPN SM04B-SRSS-TB(LF)(SN); LCSC C160404
JP801: GPS VCC 3V3/5V; SolderJumper-3_P1.3mm_Bridged12_RoundedPad1.0x1.5mm
R803, R804, R805: 100R; R_0603_1608Metric; MPN 0603WAF1000T5E; LCSC C22775
R806, R807: 100k; R_0603_1608Metric; MPN 0603WAF1003T5E; LCSC C25803
TP801: PPS; TestPoint_Pad_D1.0mm
TP807: +3V3; TestPoint_Pad_D1.0mm
TP808: GND; TestPoint_Pad_D1.0mm
U802: SRV05-4; SOT-23-6; MPN SRV05-4-P-T7; LCSC C85364

Connections:
+3V3: J803.2, JP801.1 (A), R806.1, TP807.1; also elsewhere on the board
+5V: C802.1, F803.1, U802.5 (VP); also elsewhere on the board
/GPS + Qwiic/GPS_5V: F803.2, JP801.3 (B)
/GPS + Qwiic/GPS_PPS_EXT: R805.1, TP801.1
/GPS + Qwiic/GPS_RX_EXT: J802.2, R804.1, U802.6 (IO4)
/GPS + Qwiic/GPS_TX_EXT: J802.3, R803.1, U802.4 (IO3)
/GPS + Qwiic/GPS_VCC: J802.1, JP801.2 (C)
/GPS_PPS: R805.2, R807.1; also elsewhere on the board
/GPS_RXD: R804.2; also elsewhere on the board
/GPS_TXD: R803.2, R806.2; also elsewhere on the board
/I2C_SCL: J802.4, J803.4; also elsewhere on the board
/I2C_SDA: J802.5, J803.3; also elsewhere on the board
GND: C802.2, J802.6, J802.MP (MountPin), J803.1, J803.MP (MountPin), R807.2, TP808.1, U802.2 (VN); also elsewhere on the board

Notes on the sheet:
GPS + Qwiic: GPS port (J802) with its supply choice and ESD protection, PPS pad, Qwiic I2C port (J803)
WHAT IT DOES J802 takes a GPS module (JST GH 6-pin, Pixhawk pinout). Its serial port (UART) goes to the ESP32 through 100R resistors, its I2C pins (GPS compass) join the board's I2C bus, and U802 protects the two UART lines from static discharge at the connector. JP801 picks the GPS supply: 3.3 V a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
GPS port: keep these at J802
U802 (ESD diodes), R803 and R804 sit right at J802: after the connector, the UART lines meet the ESD diodes first, with a short GND path. C802 belongs to U802 pin 5 (VP): within 2 mm, GND via beside its GND pad.
PARTS AND THEIR JOBS J802: GPS port, JST GH 6-pin, Pixhawk pinout: 1 VCC, 2 TX to the GPS's RX, 3 RX from the GPS's TX, 4 SCL, 5 SDA, 6 GND. 3.3 V logic, not 5 V-tolerant. JP801: 3-pad solder jumper for the GPS supply (GPS_VCC): pads 1-2 bridged = 3.3 V as delivered; cut 1-2 and bridge 2-3 for a 5 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

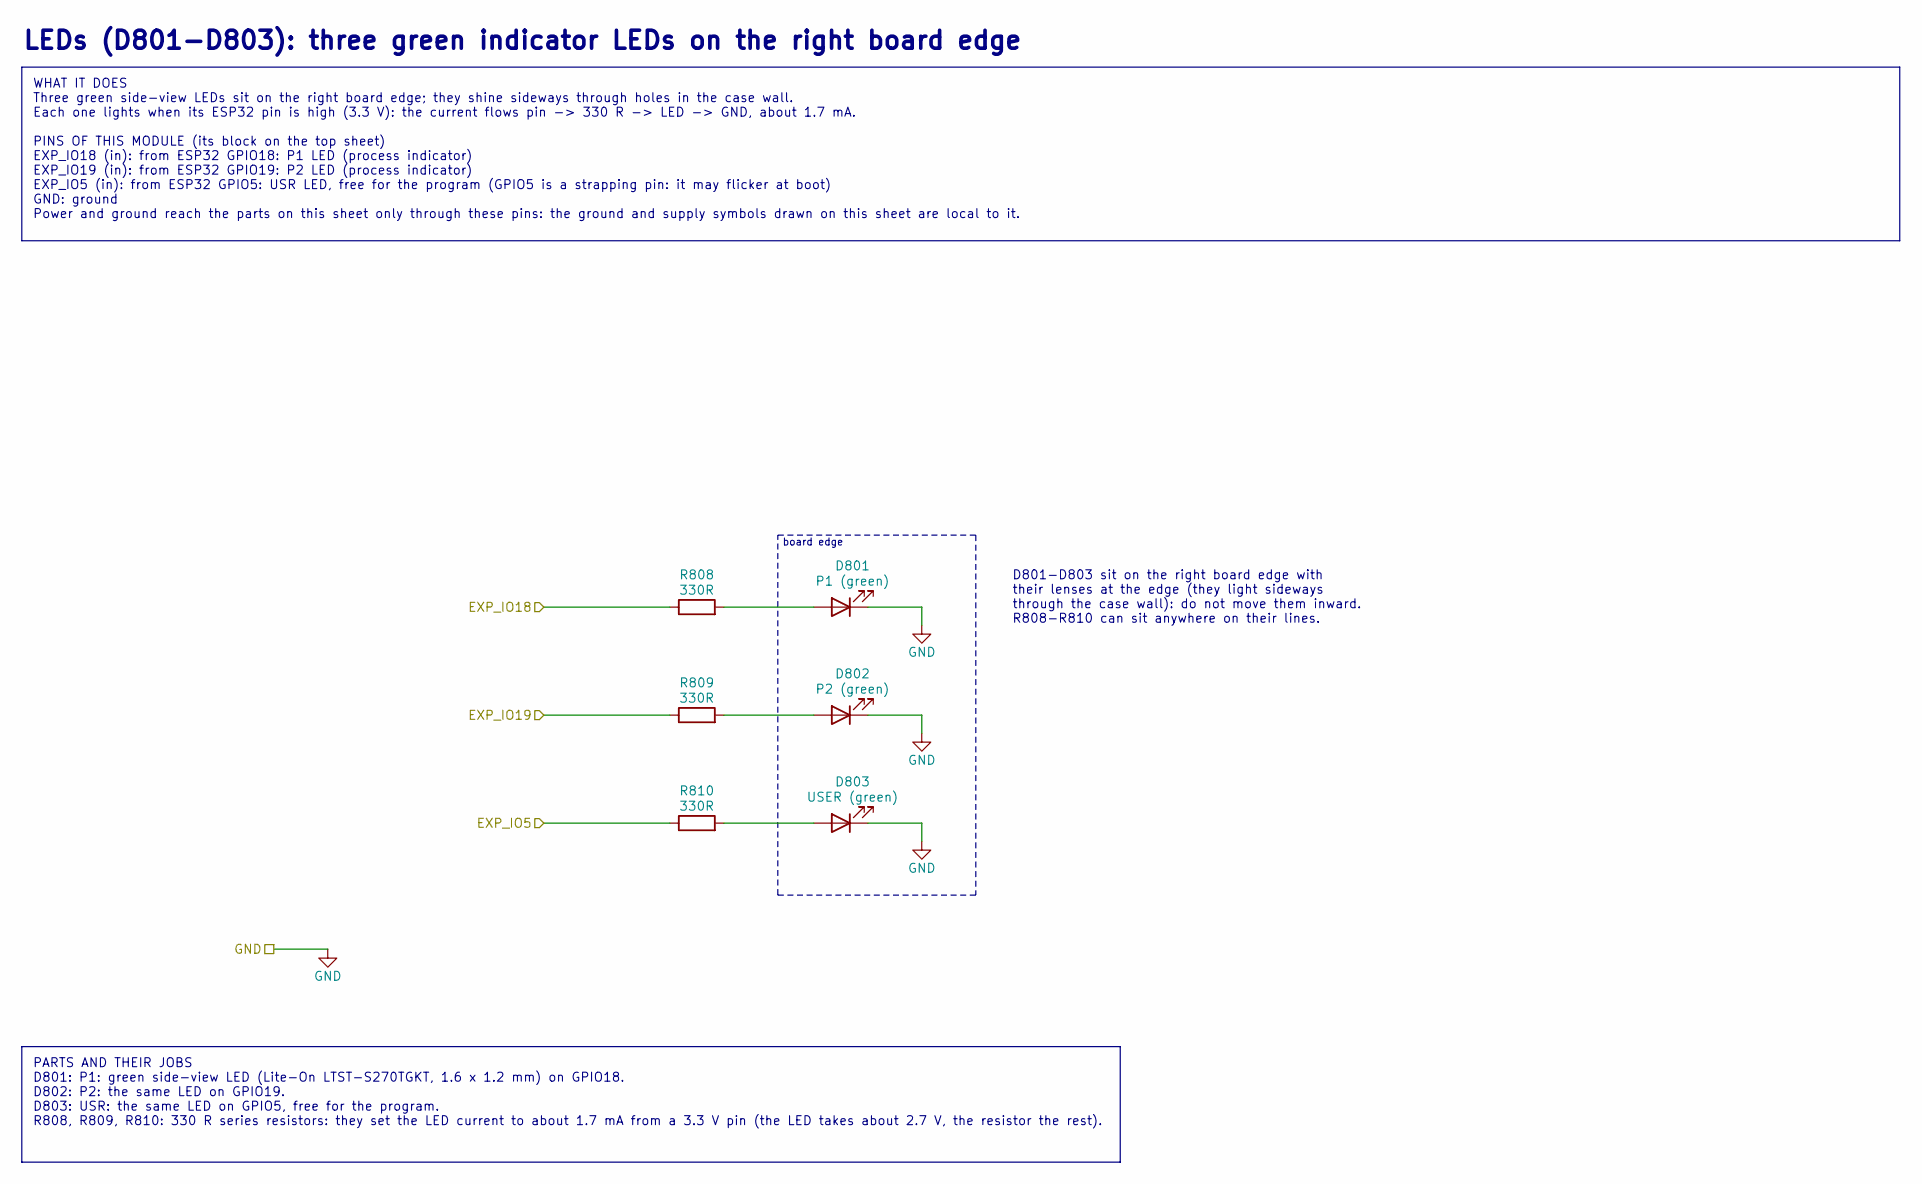
[picture p33: schematic leds.kicad_sch]

Parts:
D801: P1 (green); LED_Kingbright_APA1606_1.6x0.6mm_Horizontal; MPN LTST-S270TGKT; LCSC C364567
D802: P2 (green); LED_Kingbright_APA1606_1.6x0.6mm_Horizontal; MPN LTST-S270TGKT; LCSC C364567
D803: USER (green); LED_Kingbright_APA1606_1.6x0.6mm_Horizontal; MPN LTST-S270TGKT; LCSC C364567
R808, R809, R810: 330R; R_0603_1608Metric; MPN 0603WAF3300T5E; LCSC C23138

Connections:
/EXP_IO5: R810.1; also elsewhere on the board
/EXP_IO18: R808.1; also elsewhere on the board
/EXP_IO19: R809.1; also elsewhere on the board
GND: D801.1 (K), D802.1 (K), D803.1 (K); also elsewhere on the board
unnamed: D801.2 (A), R808.2
unnamed: D802.2 (A), R809.2
unnamed: D803.2 (A), R810.2

Notes on the sheet:
LEDs (D801-D803): three green indicator LEDs on the right board edge
WHAT IT DOES Three green side-view LEDs sit on the right board edge; they shine sideways through holes in the case wall. Each one lights when its ESP32 pin is high (3.3 V): the current flows pin -> 330 R -> LED -> GND, about 1.7 mA. PINS OF THIS MODULE (its block on the top sheet) EXP_IO18 (in): fr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
board edge
D801-D803 sit on the right board edge with their lenses at the edge (they light sideways through the case wall): do not move them inward. R808-R810 can sit anywhere on their lines.
PARTS AND THEIR JOBS D801: P1: green side-view LED (Lite-On LTST-S270TGKT, 1.6 x 1.2 mm) on GPIO18. D802: P2: the same LED on GPIO19. D803: USR: the same LED on GPIO5, free for the program. R808, R809, R810: 330 R series resistors: they set the LED current to about 1.7 mA from a 3.3 V pin (the LED 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

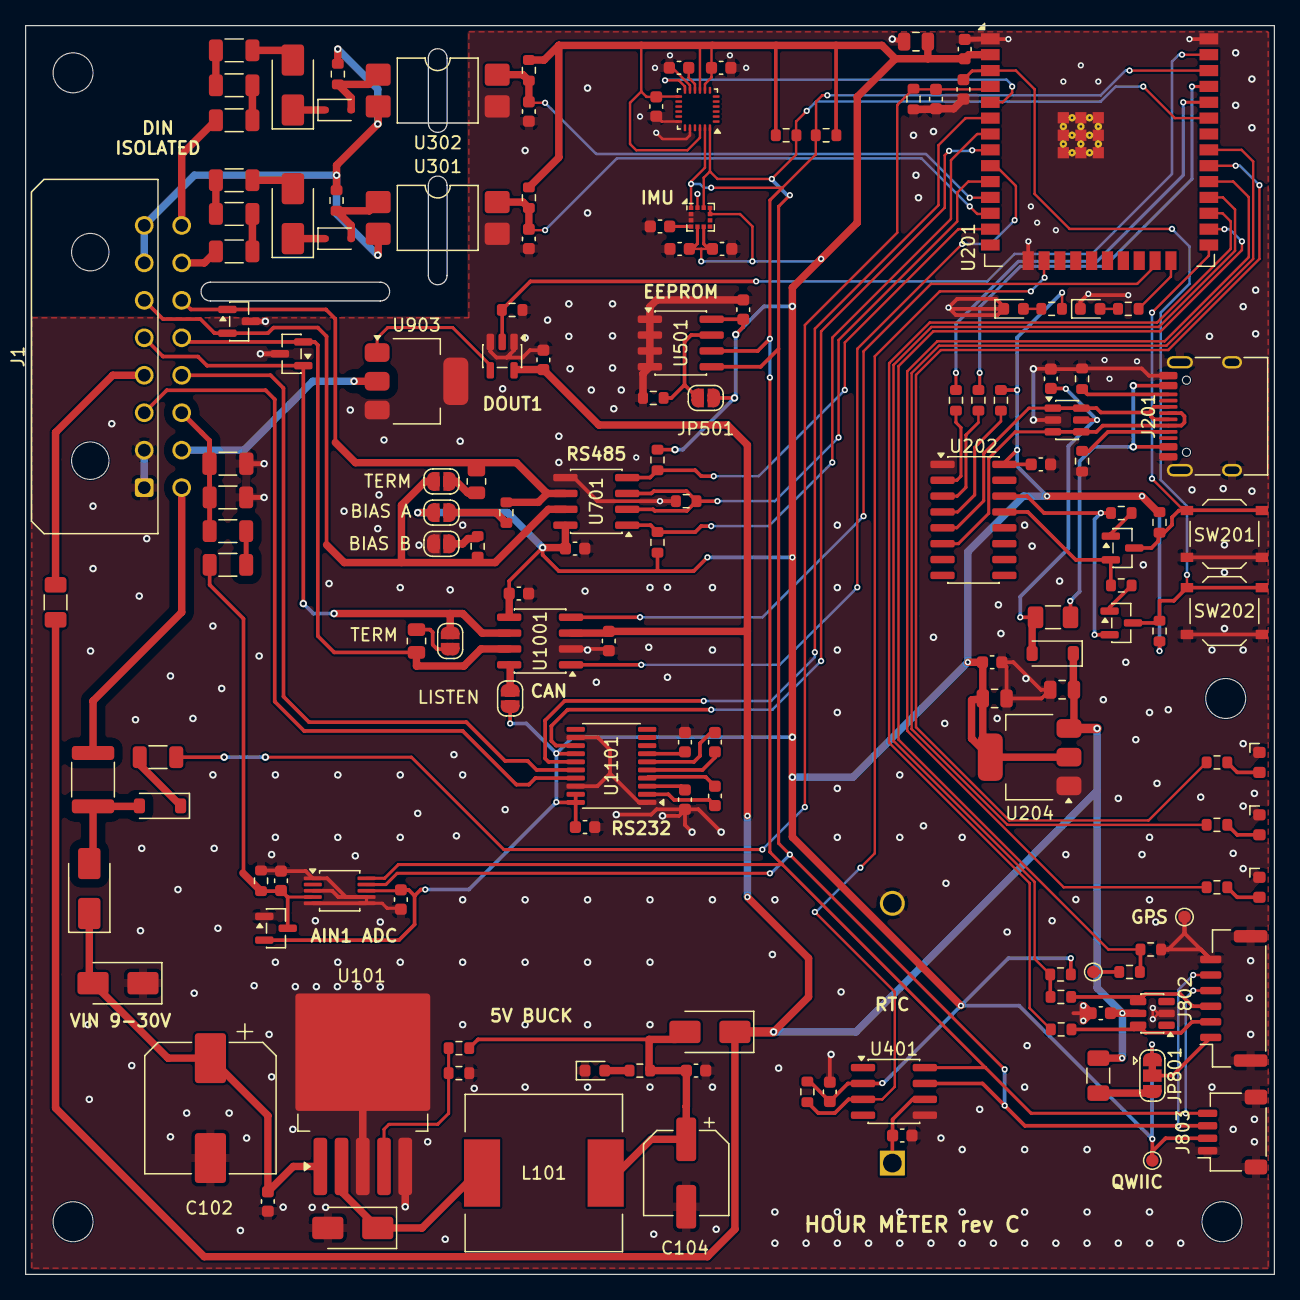
[picture p34: board hour-meter-board.kicad_pcb from above]

Board: 2 copper layers, 100.0 x 100.0 mm, 152 parts (1 on the bottom side), 100 nets.
