ilomon10/embedded-totalizer-hour-meter/esp32/src/Application.h

// Application.h — owns every object and runs the main loop.
//
// TS mental model: the composition root of a Node service. It creates the
// drivers, injects them into the logic classes, and polls timers:
//
//   setup(): watchdog -> USB -> flash store -> bus (unless `i2c` is off) -> EEPROM -> newest settings + counters
//            -> UART -> RTC -> IMU -> boot event
//   loop():  serial commands | inputs (100 Hz) | IMU (imuSampleHz) | stream | telemetry
//            | RTC sync | I2C bus: presence check (hot-plug of EEPROM / RTC / IMU), park / retry | supervisor
//
// Self-recovery: a stalled loop trips the watchdog; a stalled USB port or the
// panic signal restart on purpose (Supervisor.h). A bad I2C bus never restarts
// the device: it is parked and tried again later (BusGuard.h). The next boot
// EVENT reports why (lastCause) and where (lastStage); repeated trouble ends in
// safe mode (no I2C) so the USB port always stays usable.
//
// Modular: every I2C module is optional and hot-pluggable. A missing module
// sets a status flag, the rest keeps working, and the module is attached as
// soon as it is plugged in (an EVENT devicesChanged reports every change).
// The `i2c` setting switches the bus off altogether: an hour meter only.
//
// Storage: settings and counters are kept in the ESP32's own flash AND, when
// fitted, in the EEPROM (StorageMirror.h): the device keeps its values without
// an EEPROM, and in safe mode too.
#pragma once

#include <Arduino.h>
#include <Wire.h>

#include "AccessGate.h"
#include "ArduinoI2cBus.h"
#include "At24c.h"
#include "BusGuard.h"
#include "CommandHandler.h"
#include "Ds3231.h"
#include "FlashStore.h"
#include "HourMeter.h"
#include "IDeviceControl.h"
#include "ImuPipeline.h"
#include "Journal.h"
#include "Mpu9250.h"
#include "PeriodicTask.h"
#include "RunConfirm.h"
#include "Presence.h"
#include "SettingsStore.h"
#include "StorageMirror.h"
#include "Supervisor.h"
#include "TimeKeeper.h"
#include "platform/ArduinoClock.h"
#include "platform/Inputs.h"
#include "platform/PartitionFlash.h"
#include "platform/SerialLink.h"

class Application : public IDeviceControl {
 public:
  Application();

  void setup();
  void loop();

  // IDeviceControl (used by CommandHandler)
  const Settings& settings() const override { return settings_; }
  Status applySettings(const Settings& next) override;
  Status setTimeEpoch(uint32_t epoch) override;
  Status presetCounters(bool setRun, uint32_t runSeconds, bool setCount, uint32_t totalCount) override;
  Status resetCounters() override;
  AckStatus startCalibration(CalibKind kind) override;
  void requestReboot() override { rebootRequested_ = true; }
  HourMeterSnapshot hourMeter() const override { return meter_.snapshot(); }
  DeviceStatus status() const override;

 private:
  // Drivers
  ArduinoClock clock_;
  ArduinoI2cBus bus_;
  At24c eeprom_;
  Ds3231 rtc_;
  Mpu9250 imu_;
  // Storage + logic
  Journal journal_;
  SettingsStore settingsStore_;
  PartitionFlash flashArea_;  // the "hmdata" partition (partitions.csv)
  FlashStore flashStore_;
  StorageMirror storage_;     // flash (main) + EEPROM (copy)
  Settings settings_;
  HourMeter meter_;
  RunConfirm runConfirm_;  // optional vibration check on top of the alternator input
  ImuPipeline pipeline_;
  TimeKeeper time_;
  CommandHandler commands_;
  // I/O
  Inputs inputs_;
  SerialLink link_;
  FrameWriter frame_;
  // Retry safety: the last ACK per port is kept so a resent command (same seq)
  // gets the same answer WITHOUT running twice (e.g. no double reset/calibrate).
  struct LastCommand {
    bool valid = false;
    uint16_t seq = 0;
    uint32_t atMs = 0;
    FrameWriter ack;
  };
  LastCommand lastCmd_[kPortCount];  // per link: USB, UART, Bluetooth
  // Bluetooth: radio follows settings_.bluetooth; sessions are PIN-locked.
  AccessGate btGate_;
  bool btHadClient_ = false;
  bool btReconfigPending_ = false;
  // Timers (TS: setInterval equivalents, polled)
  PeriodicTask inputTask_;
  PeriodicTask imuTask_;
  PeriodicTask streamTask_;
  PeriodicTask telemetryTask_;
  PeriodicTask rtcTask_;
  PeriodicTask presenceTask_;
  // Hot-plug state for the optional I2C modules, and the bus they share.
  PresenceTracker eepromPresence_;
  PresenceTracker rtcPresence_;
  PresenceTracker imuPresence_;
  BusGuard busGuard_;
  bool setupDone_ = false;
  bool devicesChanged_ = false;
  // Settings came from a store at boot, were changed since, or an EEPROM was read already: a later
  // EEPROM is given the settings in use instead of being read (counters: StorageMirror's history rules).
  bool settingsKnown_ = false;
  bool settingsNotSaved_ = false; // settings changed with no store at all (no flash partition, no EEPROM)
  bool lastSaveHadTime_ = false;  // the counters adopted at boot were saved with a valid time

  uint32_t deviceId_ = 0;
  uint16_t txSeq_ = 0;
  uint8_t devices_ = 0;          // device_bit mask found at boot
  uint32_t bootFlags_ = 0;       // status_flag bits decided at boot
  bool storageError_ = false;       // the EEPROM could not be formatted or scanned
  bool counterSaveFailed_ = false;  // the last counter save failed in a store
  bool settingsSaveFailed_ = false; // the last settings save failed in a store
  bool rebootRequested_ = false;
  bool linkReconfigPending_ = false;
  uint32_t lastImuUs_ = 0;
  int16_t rtcTempQ_ = 0;
  bool rtcTempValid_ = false;
  bool imuSaturated_ = false;     // any clipped sample during the last telemetry period
  // Self-recovery (see Supervisor.h, platform/ResetLog.h)
  Supervisor supervisor_;
  LastCause lastCause_ = LastCause::None;
  Stage lastStage_ = Stage::Unknown;
  bool safeMode_ = false;         // booted without I2C after repeated unplanned restarts

  void setDevice(uint8_t bit, bool present);
  bool eepromAttached() const { return (devices_ & device_bit::kEeprom) != 0; }
  // The bus may be used: not in safe mode, and the `i2c` setting is on.
  bool i2cWanted() const { return !safeMode_ && settings_.i2cOff == 0; }
  bool i2cOffInFlash() const;
  void applyI2cMode();
  void superviseBus(uint32_t nowMs, uint32_t nowUs);
  void retryBus(uint32_t nowMs);
  void parkBus(uint32_t nowMs);
  void dropModules();
  void loseRtc();
  bool attachEeprom();
  bool attachEepromWatched();
  void supervise(uint32_t nowMs);
  void restart(LastCause cause);  // does not return
  void initFlashStore();
  void adoptStoredState();
  void onEepromArrived();
  void adoptLateSettings(const Settings& stored);
  Status saveSettingsEverywhere(const Settings& next);
  bool attachRtc(bool atBoot);
  bool attachImu();
  void runPresence();
  bool bluetoothGate(SensorFrameView& frame, FrameWriter& ack);
  void updateBluetoothSession();
  void applyBluetooth();
  void applyRuntimeSettings();
  void sendBootEvent();

  void runInputs(uint32_t nowMs);
  void runImu(uint32_t nowUs);
  void runStream();
  void runTelemetry();
  void syncRtc(uint32_t nowMs);
  void finishCalibration(CalibKind kind, AckStatus result, const Calibration& cal);
  // Save the counters to every store (the EEPROM only if includeEeprom). True if at least one kept them.
  [[nodiscard]] bool persistCounters(uint32_t nowMs, uint8_t extraFlags, bool includeEeprom = true);
  void afterCommand();

  static void onCommand(SensorFrameView& frame, Port from, void* ctx);
};
