ilomon10/embedded-totalizer-hour-meter/(commit log)

2026-10-12 Initial commit: hour meter firmware, host tools, SensorFrame, PCB, simulator
    - esp32/: PlatformIO firmware 2.3.0 (hour meter, totalizer, RTC, IMU,
    EEPROM journal, Bluetooth SPP) with unit tests and docs
    - node/: DeviceClient, reader, command CLI and Ink TUI
    - sensorframe/: wire format spec, header-only C++ and npm library
    - schematic/: KiCad carrier PCB rev A with Gerbers and BOM
    - simulator/: Deno device simulator on a socat tty, TCP or stdio, with
    fault scenarios and the Bluetooth lock; frames byte-identical to firmware
    - esp32/docs/FRAME-CATALOG.md: every frame with verified hex dumps
    - canbus/can.sh: CANable2 slcan helper
    - root README and .gitignore
    [hour-meter-esp32-B_Cu.gbl, hour-meter-esp32-B_Mask.gbs, hour-meter-esp32-B_Silkscreen.gbo, hour-meter-esp32-Edge_Cuts.gm1, hour-meter-esp32-F_Cu.gtl, hour-meter-esp32-F_Mask.gts, hour-meter-esp32-F_Silkscreen.gto, hour-meter-esp32-NPTH.drl]
2026-10-12 Port host tools from Node to Deno as configurator/ (hour-meter)
    - node/ becomes configurator/: one `hour-meter` program with the TUI as the
    default, `read` for the live view, and get/set/set-time/... commands
    - serial ports via Deno.open + stty (Linux, macOS); npm serialport cannot
    work under Deno (its native add-on opens the port, then every read/write
    fails with EBADF). TCP links (tcp://host:port) for bridges and the simulator
    - --demo runs the simulator's SimDevice in-process; tui/demo-device.ts removed
    - tags.js -> typed src/tags.ts, now imported by the simulator directly
    - check-docs.js -> check-docs.ts (Deno), also checks configurator/README.md
    - fix: `set bluetooth=true btPin=..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
    [test_main.cpp]
2026-10-12 feat(simulator): add web UI to control every simulated value
    - `--web [port]` serves a React + Tailwind page (Vite, embedded in the
    release binaries) with a WebSocket for live state and control
    - every value the device sends can be set: engine, pulse rate, counters,
    roll/pitch/heading, vibration, raw and filtered IMU axes, RTC temperature
    and battery, I2C errors, overruns, extra status flags, calibration
    - each group stays animated (auto) until touched, then holds its values
    (manual) until released
    - plug/unplug modules, live noise/corruption, reboot/watchdog/power cycle,
    host settings view and a filterable frame log
    - binds to 127.0.0.1 by default; `--web-host` opens it to the LAN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
2026-10-12 feat(simulator): add 3D bench playground for orientation and vibration
    - /3d route (Bench tab) with a model of the carrier PCB: drag to tilt,
    drag the compass ring for heading, double-click to level, arrow keys
    and [ ] to nudge
    - custom vibration with presets; the board shakes with the RMS level
    (hidden under prefers-reduced-motion)
    - auto IMU readings follow the current attitude: gravity and the earth's
    field are rotated into the board frame (src/attitude.ts, verified
    against the firmware's Orientation.h and Compass.h)
    - editor-shell header with page tabs, IBM Plex Sans, design tokens
2026-10-12 feat(simulator): add Drive mode with vehicles on a map and IMU-only dead reckoning
    - /drive: a truck, plane or uploaded glTF model drives on OpenStreetMap tiles
    (MapLibre + three.js), by drawn route, live keyboard/gamepad (remappable)
    or GPX/CSV replay
    - vehicle motion becomes IMU data (specific force, body rates, earth field,
    vibration) and runs through a port of the firmware's IMU pipeline, so
    reported roll/pitch/heading carry the device's real errors in turns
    - reference host-side estimators fed with the frames the host receives:
    ground vehicles learn gravity while parked with zero-velocity updates;
    aircraft use a 3D strapdown INS; truth vs estimate drawn with the error
    - CLI: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
    [sample-loop.csv, totalizator-hour-meter-schematic.kicad_pcb, totalizator-hour-meter-schematic.kicad_sch]
2026-10-12 feat(simulator): speak firmware 2.4.0 (1.3.0)
    - Status block carries lastCause / lastStage; reboot and the panic signal
    restart with the matching cause.
    - New scenarios: hang (device freezes) and safe-mode.
    - Follow the firmware's nose-up pitch sign in the IMU model, vehicle
    models, dead reckoning and 3D views.
2026-10-12 feat(firmware): self-recovery, panic signal and nose-up pitch (2.4.0)
    - Arm the task watchdog at the first line of setup() and open USB before
    any I2C access, so a hang during boot reboots and never silences USB.
    - Supervisor restarts when the I2C bus fails for 30 s (NACK is not a
    failure) or the USB TX buffer does not drain for 10 s.
    - Panic signal: 64 consecutive 0x00 bytes on USB or the UART pins restart
    the device without a frame or ACK (ignored over Bluetooth).
    - ResetLog keeps breadcrumbs in RTC memory; the full status block reports
    lastCause (tag 62) and lastStage (tag 63).
    - Three unplanned restarts in a row boot in safe mode (flag bit 18): no
    I2C, USB/UART and counting kee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
    [AppConfig.h, Application.cpp, Application.h, ResetLog.cpp, ResetLog.h, SerialLink.cpp, SerialLink.h, test_main.cpp]
2026-10-12 feat(configurator): reset a device that does not answer (1.1.0)
    - hour-meter reset [--hard|--signal]: send the panic signal, then pulse
    EN through the USB adapter's RTS line (libc ioctl via FFI) if no boot
    EVENT arrives.
    - TUI: "Hard reset (USB)" action, H key, and a banner after 5 s without
    data; boot messages show why and during what the device restarted.
    - Decode lastCause / lastStage (tags 62, 63) and the safeMode flag.
2026-10-12 feat(firmware): confirm engine running by vibration (2.5.0)
    - New setting runVibMinMg (tag 129, off by default): run time counts only
    while the engine-running input is on and the IMU vibration RMS is at
    least this many mg (released below 70 %). Ignored without an IMU.
    - New tag 10 altInput reports the raw input, so a key-on wire shows as
    "input on" while the engine is stopped.
    - The setting is stored in record bytes older firmware kept zero, so
    existing settings and calibration load unchanged.
    - WIRING.md: how to pick the engine-running wire (L / D+ at the
    alternator or the oil-pressure switch, not IG/R/S or B+), with a
    three-reading multimeter check.
    [Application.cpp, Application.h, test_main.cpp]
2026-10-12 feat(configurator): show engine input not confirmed by vibration (1.2.0)
    - Decode altInput (tag 10) and the runVibMinMg setting (tag 129).
    - read and the TUI show "engine OFF (input on)" when the wire is live but the engine is not running.
    - README: troubleshooting for hours that count with the key on.
2026-10-12 feat(simulator): speak firmware 2.5.0 (1.4.0)
    - altInput in the hour-meter block, runVibMinMg setting and the vibration confirmation.
    - New acc-wire scenario: the engine-running input follows the key, not the engine.
2026-10-15 feat(simulator): reverse gear and mounting calibration (1.5.0)
    - Truck reverse gear (X key / gamepad B), engages at standstill, up to 18 km/h
    - Board mount (yaw, pitch, roll) so the IMU data comes from a turned or tilted board
    - Host-side calibration from the IMU stream: level (gravity at rest) then front
    (acceleration while pulling away straight); the reference dead reckoning uses
    it for forward/reverse speed and compass heading
    - Dead reckoning speed is signed
2026-10-15 feat: Update schematic library symbols and metadata
    [hour-meter-esp32.kicad_sch]
2026-10-15 build(release): script to publish firmware, configurator and simulator releases
    - ./scripts/release.ts <component|all> [--dry-run] [--ref] [--notes] [--draft]
    - checks, tests and builds the exact commit in a git worktree, asks before
    tagging, pushing and publishing, then downloads and verifies the release
    - --dry-run prints every command and the release notes without changing anything
2026-10-21 feat(pcb): add a JLCPCB stock checker for KiCad BOMs
    - scripts/jlc-stock.ts reads a JLCPCB-style BOM (Designator, Comment, Footprint, LCSC, Qty)
    and checks every LCSC part against JLCPCB's live parts API, so a board is only ordered
    with parts that are actually in stock
    - verdicts per line: OK, LOW (not enough for --boards N), MISSING, NO-LCSC, and BOARD-ONLY
    for mounting holes, solder jumpers, test points and fiducials (nothing to buy)
    - exits 1 when any line needs attention; pure helpers in jlc-stock-lib.ts with unit tests
2026-10-21 feat(pcb): add rev-B chip-down main board and PSU-B
    - hour-meter-board: one 4-layer 100 x 90 mm board in place of the rev-A module carrier,
    one schematic sheet per former module (ESP32-WROOM-32E + CH340C/USB-C, PC817 inputs,
    DS3231, socketed AT24C256, MPU-6500 + LIS3MDL, SP3485 RS485, UART/GPS/Qwiic ports),
    all from JLCPCB in-stock parts; ERC 0 errors, DRC 0 errors and 0 unconnected
    - hour-meter-psu-b: plug-on 9-36 V -> 5.28 V TPS54360B supply for the 5 V main board,
    its header flipped to B.Cu so it mates pin for pin with the main board's J102 socket
    - headless pcbnew scripts: build/place, Freerouting, finish the connections Freerouting
    leaves open (re-route, plane vias, strap-pin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
    [BOM-hour-meter-board.csv, BOM-hour-meter-psu-b.csv, eeprom-at24c256.kicad_sch, esp32-core.kicad_sch, hour-meter-board.kicad_pcb, hour-meter-board.kicad_sch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]
2026-10-21 docs(pcb): document rev-B board and PSU-B
    - hour-meter-board/README.md: module-to-sheet map, connectors and jumpers, ESP32 pin map,
    power path, how the board was routed, checks before ordering, bring-up, the firmware
    changes the board still needs, and how to regenerate it from the scripts
    - hour-meter-psu-b/README.md: TPS54360B design values, why the header sits on the bottom
    side, bring-up and load-step check
    - README.md: repository map rows for both boards, rev-B summary, docs table link
2026-10-24 feat(firmware): keep settings and counters in the ESP32 flash (2.6.0)
    - Every save also goes to a new 64 KB `hmdata` partition
    (esp32/partitions.csv), so a dead or missing EEPROM no longer loses the
    hour meter, totalizer or settings. A fitted EEPROM is a second copy.
    - The flash is the main store; the EEPROM fills an empty flash (the first
    boot after the update, a new ESP32 board).
    - Counter records carry a history id. Within one history the newest save
    wins; an EEPROM from another history is only added to the counters the
    device counted from zero, at boot and when it answers while running.
    - Settings are compared by content between the stores and saved only
    when they change, so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
    [partitions.csv]
2026-10-24 feat(configurator): download and flash firmware over USB (1.3.0)
    - `hour-meter firmware version|list|download|flash` and a Firmware tab
    (6) in the TUI.
    - A built-in ESP32 ROM-bootloader flasher in TypeScript (SLIP,
    compressed writes, MD5 check), so no esptool or Python is needed. It
    resets the board into the bootloader over DTR/RTS.
    - Firmware comes from the GitHub releases (falling back to releases.atom
    when the API rate limit is hit), is checked against SHA256SUMS and is
    cached.
    - Counters and settings are backed up before flashing and restored
    after; the nvs (Bluetooth pairing) and hmdata (flash store) partitions
    are never written.
    - Knows firmware 2.6.0: the `flashStoreMiss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
2026-10-25 fix(configurator): say which store is missing when a counter change is refused (1.3.1)
    A preset or reset answered DeviceMissing only said "device answered
    DeviceMissing". The ACK carries the device's status flags, so the error
    now says why: no EEPROM and no flash store (flashStoreMissing: flash the
    full image so the partition table gets hmdata), or no EEPROM on firmware
    before 2.6.0 (update it).
    firmware flash now ends with an error when the board reports
    flashStoreMissing after the update, instead of passing silently.
2026-10-25 feat(configurator): connect screen and USB hot-plug in the TUI (1.4.0)
    Without a port, `hour-meter` opens a connect screen instead of failing:
    the serial ports (named by their adapter on Linux, rescanned every
    second, a newly plugged board selected), a typed path or tcp:// address,
    and the demo. The last port used is remembered. A port that does not
    open says why (not there, in use, no permission with the group to join).
    `p` in the TUI comes back to it.
    The TUI keeps running when the board is unplugged: the header and a
    banner show it, commands answer "not connected" at once, and the port is
    opened again until the board is back (found by its adapter id if it
    returns under another name). Blu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
2026-10-25 feat(pcb): add 2-layer and compact variants of the rev-B board
    Two KiCad Save-As copies of hour-meter-board; the 4-layer design is
    unchanged:
    - hour-meter-board-2layer: the same circuit and placement, routed on
    2 copper layers for a cheaper PCB.
    - hour-meter-board-compact: 80 x 70 mm, 2 layers, milled isolation
    slots around the vehicle inputs, fault-protected RS485, fused 5 V
    header pins, coin cell on the underside.
    Each has its Gerbers, BOM and CPL in production/.
    The build, route and finish scripts take the board geometry from a
    Layout (outline, keep-outs, placement, slots) and a layer count, so the
    variants reuse them. A dry run builds into the ignored routing/ folder
    instead of ov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
    [BOM-hour-meter-board-2layer.csv, BOM-hour-meter-board-compact.csv, eeprom-at24c256.kicad_sch, esp32-core.kicad_sch, hour-meter-board-2layer.kicad_pcb, hour-meter-board-2layer.kicad_sch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]
2026-10-25 feat(pcb): simulate vehicle faults on the rev-B boards and PSU-B
    schematic/fault-analysis/faults.py runs ngspice on load dump, ISO 7637-2
    pulses, reverse polarity, shorted outputs and miswired connectors, and
    plots the results. The decks and waveforms it writes (work/) are
    ignored.
    PSU-B passes everything on a 12 V vehicle, but not a 24 V vehicle's
    clamped load dump (58-65 V): D1 would absorb 21-87 J and survives about
    16 J. Its README says so and what to use instead.
    [faults.py]
2026-10-25 build(simulator): run on Bun instead of Deno (1.7.0)
    - package.json and bun.lock replace deno.json and deno.lock, with the
    same Vite, Tailwind, React and three.js versions. The web UI builds
    with `bunx --bun vite`.
    - pty: socat runs through Bun.spawn, and its log is matched line by
    line, since a pipe read can end in the middle of a line.
    - tcp: node:net. stdio: Bun's stdin stream and stdout writer.
    - The web server is Bun.serve with WebSocket handlers. It serves the
    page from the release binary (web/dist embedded as an asset) or from
    web/dist next to the sources. Bun sets the content types, so the
    fonts are no longer sent as application/octet-stream.
    - The codec is a static impor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
    [sample-loop.csv]
2026-10-25 build(release): run the scripts on Bun, ship Linux and Windows x64 only
    - release.ts installs each tool's packages in the build worktree
    (bun install --frozen-lockfile), then tests and compiles with
    bun run. It checks for bun instead of deno.
    - TOOL_PLATFORMS is linux-x64 and windows-x64, so a release carries
    6 files plus SHA256SUMS.
    - jlc-stock.ts and esp32/scripts/check-docs.ts start with
    #!/usr/bin/env bun. The script tests run on bun:test.
2026-10-25 docs: switch the setup and commands from Deno to Bun
    The root README, the esp32 README, CODING-STANDARD.md and
    FRAME-CATALOG.md now ask for Bun 1.4.4 or newer and use `bun run ...`.
    The root README also lists the script tests and the type, lint and
    format checks, and says which platforms have release binaries. The
    .gitignore comments name the bun commands.
2026-10-25 feat(configurator)!: redesign the TUI on OpenTUI (2.0.0)
    - Ten screens in three groups, from the menu or keys 1-9 and 0: Maintain
    (Overview, Counters, Report), Set up (Commission, Live inputs, Settings,
    Calibrate) and Service (Diagnostics, Firmware, Log). It works at 80x24;
    from 100 columns the menu is a sidebar. ? lists the keys, : or Ctrl+K
    finds any screen, setting or action
    - Nothing that changes the device runs on one key: a counter change shows
    now → new and refuses an empty value, a reset needs RESET typed and a
    firmware update FLASH; settings wait for a review of before → after
    (with a warning when a change cuts your own link), then go as one command
    - New: a commis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
2026-10-25 docs(firmware): point the wiring and module guides at the new TUI
    - WIRING.md: 5 Live inputs does steps 1 to 3 of the vibration-threshold
    procedure (o, i, then t to review the suggested value)
    - TESTING-MODULES.md: module changes show in 1 Overview and in 0 Log
2026-10-26 fix(pcb): finish compact board routing and refresh JLCPCB order files
    - Take the board tidied by hand in KiCad 10 (routing/finish-best) into the
    main board file
    - Keep 2 copper layers: importing the KiCad 5 JLCPCB_1-2Layer template had
    enabled empty In1/In2 layers, a 4-layer stackup and "Front"/"Back" layer
    names, which turned the Gerbers into a 4-layer order
    - Restore the Vehicle (0.8 mm), Power and Plane net classes the import
    removed; put back the 0.8 mm routes of R302-R303 and R307-R308 and refill
    the pours, which had come within 0.2-0.6 mm of vehicle-voltage copper
    - Keep the template's rules (0.127 mm clearance, 0.12 mm mask web), all
    within JLCPCB's current limits
    - Regene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
    [hour-meter-board-compact.kicad_pcb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]
2026-10-26 fix(pcb): show U601, U501 and F101 in the compact board's 3D view
    - U601: KiCad 10 renamed the QFN-24 3x3 mm model; use QFN-24_3x3mm_P0.4mm
    - U501: show the DIP-8 chip itself; JLCPCB solders it in without a socket
    - F101: KiCad 10 has no 1812 fuse model; use the 1812 chip body as a
    stand-in
    - Only the model paths change; the Gerbers, drill files, BOM and CPL are
    identical
    [hour-meter-board-compact.kicad_pcb]
2026-10-26 docs(pcb): describe ordering the compact board assembled at JLCPCB
    - Standard PCBA on both sides (BT401 is underneath), all 12 through-hole
    parts selected, U501 soldered without a socket
    - Order remark for the tooling rails, so they don't hit the ESP32 antenna
    overhang
    - PSU-B is a separate Economic order; on 24 V vehicles feed the board from
    a 12 V converter
    - List the parts KiCad 10 has no 3D model for
2026-10-27 feat(pcb): mark where JLCPCB prints the order number
    - New add_order_mark() in the shared board builder: places the
    JLCJLCJLCJLC placeholder (1.0 mm, 0.15 mm stroke) at the free spot
    nearest a given point, clear of pads, holes, courtyards, silkscreen and
    the outline
    - Compact board and PSU-B carry it on the bottom silkscreen; their build
    scripts put it back on a rebuild
    - Regenerate both boards' order files (only the bottom silkscreen changes)
    - READMEs: select "Order Number: Specify Position" when ordering; PSU-B
    takes Economic PCBA
    [hour-meter-board-compact.kicad_pcb, hour-meter-psu-b.kicad_pcb]
2026-10-27 feat(pcb): add compact board variant with built-in LM2596 supply
    Single 80 x 80 mm, 2-layer board: an LM2596S-ADJ stage on the bottom
    edge replaces the plug-on PSU-B. The shared builder now skips J102 and
    the PSU outline when a layout has neither.
    [BOM-hour-meter-board-compact-lm2596.csv, eeprom-at24c256.kicad_sch, esp32-core.kicad_sch, hour-meter-board-compact-lm2596.kicad_pcb, hour-meter-board-compact-lm2596.kicad_sch, imu.kicad_sch, opto-inputs.kicad_sch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]
2026-10-28 feat(pcb): use JST VH field connectors on the LM2596 compact board
    - J101 (VIN 9-30V), J301 (vehicle IN), J701 (RS485) and J801 (UART) are
    latching JST VH headers instead of screw terminals and JST XH
    - add TP101 VIN solder pads in parallel with J101
    - GPS J802 becomes a 1x5 male pin header
    - re-route the board (U203 VBUS escape fixed by re-routing the USB and
    ESP32 lines under it) and regenerate the JLCPCB order files
    - tools-pcb.py: `models` command fetches the JLCPCB/EasyEDA STEP models;
    the downloaded 3d/ folders are git-ignored
    [BOM-hour-meter-board-compact-lm2596.csv, hour-meter-board-compact-lm2596.kicad_pcb, opto-inputs.kicad_sch, ports.kicad_sch, power-input.kicad_sch, rs485.kicad_sch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]
2026-10-28 feat(pcb): add I/O variant with AIN1, DIN1/DIN2 and DOUT1
    - schematic/hour-meter-board-compact-lm2596-io: the LM2596 board on 80 x 92 mm
    with a Teltonika-style I/O port, J902 (JST VH 5-pin: +5V, AIN1, GND, DOUT1,
    GND); a Save-As copy, so the LM2596 board is unchanged
    - AIN1: 0-30 V through a 0.1 % divider into an ADS1115 (I2C 0x48), software
    ranges down to 0-5.6 V, 1 kV pin capacitor, BAV99 clamp, optional 4-20 mA
    shunt (R904, not fitted)
    - DOUT1: GPIO23 -> 74AHCT1G125 -> BSP75N self-protected low-side switch,
    0.5 A, 60-75 V clamp; J804 pin 6 no longer carries GPIO23
    - the isolated vehicle inputs are renamed DIN1/DIN2 (same circuit and GPIOs)
    - routing: `reuse` copies the LM2596 bo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
    [BOM-hour-meter-board-compact-lm2596-io.csv, eeprom-at24c256.kicad_sch, esp32-core.kicad_sch, hour-meter-board-compact-lm2596-io.kicad_pcb, hour-meter-board-compact-lm2596-io.kicad_sch, imu.kicad_sch, io.kicad_sch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]
2026-10-29 fix(pcb): link the I/O board's TP101/TP102 solder pads to their nets
    - TP101 (VIN) and TP102 (GND) replace the two-hole TP101: 1.5 mm pads on
    the back, above and below J101. They were placed by hand in the PCB
    editor, so they had no symbol link and no net and could not be routed
    - they are now library footprints flipped to the bottom and linked to
    their symbols. A 0.5 mm B.Cu track joins J101 pin 1 to TP101, and TP102
    joins the GND pour solid (its thermal spokes were thinner than the
    pour's minimum)
    - pours refilled, so the clearance and solder-mask errors are gone:
    DRC 0 errors, 0 unconnected, 0 parity
    - tools-pcb.py: TP101/TP102 placed on the bottom side; `reuse` leaves out
    t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
    [eeprom-at24c256.kicad_sch, esp32-core.kicad_sch, hour-meter-board-compact-lm2596-io.kicad_pcb, hour-meter-board-compact-lm2596-io.kicad_sch, imu.kicad_sch, io.kicad_sch, opto-inputs.kicad_sch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]
2026-10-29 feat(pcb): enlarge the I/O board's VIN/GND solder pads to 3 mm
    - TP101 (VIN) and TP102 (GND) use TestPoint_Pad_3.0x3.0mm, still on the
    bottom side above and below J101, for hand-soldering 18-22 AWG wire
    - keep the GND track from J101 pin 2 to TP102 drawn in pcbnew
    - tools-pcb.py: `reuse` leaves out both of the LM2596 board's routes from
    J101 to its two-hole TP101, following only branch-free track chains
    - DRC 0 errors / 0 unconnected / 0 parity; Gerbers regenerated, BOM and
    CPL unchanged
    [hour-meter-board-compact-lm2596-io.kicad_pcb, power-input.kicad_sch]
2026-10-29 chore(pcb): copy the I/O board as the start of the harness re-layout
    - schematic/hour-meter-board-microfit: a KiCad Save-As copy of
    hour-meter-board-compact-lm2596-io (netlist identical: 143 parts,
    126 nets), so the I/O board stays as it is
    - the re-layout will put all vehicle wiring on one Molex Micro-Fit 3.0
    header, group the vehicle-side circuits on the left and shrink the board;
    the README says the text still describes the I/O board until then
    - order files are left out until the new board is generated
    [eeprom-at24c256.kicad_sch, esp32-core.kicad_sch, hour-meter-board-microfit.kicad_pcb, hour-meter-board-microfit.kicad_sch, imu.kicad_sch, io.kicad_sch, opto-inputs.kicad_sch, ports.kicad_sch]
2026-10-29 feat(pcb): wire the Micro-Fit board's field I/O through one J1 harness
    - New Harness sheet: J1 Molex Micro-Fit 3.0 2x7 right-angle header
    (43045-1400, LCSC C277677) replaces J101, J301, J701, J801 and J902.
    - Pin order: VIN, AIN1, DOUT1, DIN1 and DIN2 sit on the back row (8-14)
    so their 0.8 mm Vehicle clearance never has to fit between two pads.
    The isolated DIN group (DIN1, DIN2 and two DIN COM pins 6/7) fills
    the pin 7/14 end, next to RS485 A/B, which are rated +/-70 V.
    - J802 GPS becomes a JST GH 6-pin in the Pixhawk pinout with I2C;
    PPS moves to the TP801 solder pad.
    - The J804 expansion header becomes test pads TP802-TP808; F802 and
    F902 go. J501, J702 and J703 become solder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
    [eeprom-at24c256.kicad_sch, harness.kicad_sch, hour-meter-board-microfit.kicad_sch, imu.kicad_sch, io.kicad_sch, opto-inputs.kicad_sch, ports.kicad_sch, power-input.kicad_sch]
2026-10-29 feat(pcb): lay out the Micro-Fit harness board on 80 x 80 mm
    - Every port on the left edge: J1 (Micro-Fit 2x7, mating face at the
    edge), the GPS JST GH port and the Qwiic port below it; USB-C and the
    buttons stay on the right edge.
    - Vehicle zone beside J1: the DIN island in the top-left corner (slots,
    barrier rule areas, no pour; the GND pour keeps 3.65 mm away), then the
    RS485, UART, AIN1 and DOUT1 front ends, with the BSP75N's drain facing
    J1 so the 0.5 A loop stays at the connector. The LM2596 stage keeps
    its bottom strip; the coin cell moves to the bottom-right corner.
    - The ESP32/USB block, the IMU and the LM2596 stage keep the I/O board's
    placement, and `reuse` copies th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
    [BOM-hour-meter-board-microfit.csv, hour-meter-board-microfit.kicad_pcb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]
2026-10-29 feat(pcb): add three side-view indicator LEDs to the Micro-Fit board
    - D801 P1 (green, GPIO18) and D802 P2 (yellow, GPIO19) are process
    indicators; D803 USER (blue, GPIO5) is free for the program. They are
    Lite-On LTST-S270 side-view LEDs on the right edge below H103, lenses
    at the board edge, 330R each, active high. GPIO5/18/19 were the test
    pads TP802/TP804/TP805.
    - tools-pcb.py: `update` adds and removes parts on the routed board;
    `route`, `finish`, `update` and `silk` follow a board moved in KiCad
    (offset measured on U601); add_pinout draws the two-column J1 pinout.
    - Keeps the KiCad edits made after the layout commit: the board moved
    by (18.20, -48.27) mm and the bottom-si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
    [BOM-hour-meter-board-microfit.csv, hour-meter-board-microfit.kicad_pcb, ports.kicad_sch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]
2026-10-29 feat(pcb): simulate the LM2596 stage, the Micro-Fit harness and its LEDs
    The fault analysis covered PSU-B only. It now runs the LM2596 input stage
    of the LM2596, I/O and Micro-Fit boards through the same load dumps and
    ISO 7637-2 pulses, with F101's trip worked out from its I^2 t. It passes
    12 V vehicles but fails a 24 V jump start and load dump, and pulse 1
    drives the 40 V reverse-polarity diode into avalanche. A simulated fix
    (PSU-B's order: SMBJ36CA ahead of a 100 V SS510) passes.
    For the Micro-Fit board: each J1 pin wired to the supply or ground, the
    19 neighbouring-cavity shorts (DOUT1 beside +5 V out and UART TX is the
    weak spot) and the indicator-LED drive.
    [faults.py]
2026-10-29 feat(pcb): set the Micro-Fit CPL for JLCPCB's footprints
    JLCPCB places each part with its own footprint, which for 21 parts is
    turned or centred differently from the KiCad one (SOT-23/SOT-223 180°,
    SOIC/QFN/ESP32 270°, J1 and BT401 centred on the body, not pin 1).
    `production` now rewrites the CPL from JLC_PLACEMENT, found by fitting
    JLCPCB's pads onto the KiCad pads, diodes and LEDs by pin name.
    The README records the JLCPCB check: copper and drilling within the
    2-layer limits, the silkscreen under their legibility minimums, and the
    LED lenses and BT401 to confirm in the placement preview. It also points
    24 V vehicles to a 24 -> 12 V converter.
    [CPL-hour-meter-board-microfit.csv]
2026-10-29 feat(pcb): one green LED part and a pinout spec for the Micro-Fit board
    D802 and D803 become the green LTST-S270TGKT, like D801. Its JLCPCB
    model faces the board edge like the KiCad footprint, where the yellow
    and blue parts' models faced the other way, and one LED part means two
    fewer extended parts. `update` now also brings the value and fields of
    parts that stay in line with the schematic.
    PINOUT.md gives every J1 pin's working range, absolute maximum and
    current, the other ports, the I2C addresses in use, and the power
    budget at 12 V: 0.5 W idle, 0.8 W typical, about 4 W with every port
    at its limit. The trucks feed the board from a 24 -> 12 V converter.
    [BOM-hour-meter-board-microfit.csv, hour-meter-board-microfit.kicad_pcb, ports.kicad_sch]
2026-11-02 feat(firmware): park the I2C bus instead of restarting (2.7.0)
    - A line held low or transfers that keep failing park the bus (BusGuard),
    which is retried with backoff. The device no longer restarts for I2C
    trouble, so lastCause 2 (i2cStuck) is no longer produced. New flag 20
    i2cParked and tag 64 i2cLines (the lines found held low).
    - Fix: a missing IMU at 0x69 read as a bus fault (requestFrom returns
    0 bytes for a NACK too), which restarted 2.6.0 every 30 s and ended
    in safe mode.
    - New settings i2c (tag 150, hour meter only, flag 21 i2cOff) and
    pulseInput (tag 151), stored in the settings record's spare options
    byte: settings saved by older firmware load unchanged.
    - Engine de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
    [Application.cpp, Application.h, BenchMain.cpp, BoardPins.h, Inputs.cpp, Inputs.h, test_main.cpp]
2026-11-02 feat(configurator): show the parked I2C bus and the 2.7.0 settings (2.1.0)
    - Tag table: flags 20 i2cParked and 21 i2cOff, tag 64 i2cLines, and the
    settings i2c (150) and pulseInput (151) in a second settings block.
    - Settings screen: 22 settings; i2c and pulseInput need firmware 2.7.0.
    - Diagnostics and the attention list: the I2C bus state (parked, with
    the lines it found held low, or switched off). While the bus is off,
    parked or in safe mode, the module-missing flags are not reported as
    hardware faults.
    - Overview: a totalizer whose pulse input is off reads "off".
    - 125 tests pass, no type errors, oxlint clean.
2026-11-02 feat(simulator): simulate the 2.7.0 I2C bus guard (1.8.0)
    - The device parks a bad I2C bus like firmware 2.7.0 (src/bus-guard.ts):
    every module counts as missing, flag 20 and tag 64 are set, and the
    bus is retried after 10 s, 20 s, 40 s ... up to 5 min. It never
    restarts for it, and the hour meter keeps counting.
    - New scenario i2c-parked[=releaseS]; the web UI's Faults panel can hold
    SDA or SCL low or make transfers time out.
    - The i2c and pulseInput settings; i2cStuck is never sent, and safe mode
    is entered only after watchdog, crash or USB-stall restarts.
    - 86 tests pass, no type errors, oxlint clean.
2026-11-02 feat(pcb): add the ESP32 DevKit V4 module carrier (rev C)
    - schematic/hour-meter-esp32-v4/: an 88 x 71 mm, 2-layer, through-hole
    carrier for modules from Indonesian shops: the ESP32 DevKit V4 (USB-C,
    38 pins), the 817 module, GY-9250, DS3231 ZS-042 and AT24C256. The
    DevKit's USB-C is the only supply; replaces rev A on half its area
    with the same firmware pins.
    - Vehicle inputs clamp at 15 V; a spare GPIO header and a status LED.
    - production/: Gerbers, a BOM with local shop names and a 1:1 fit-check
    PDF; the board and its footprints are generated by tools-*.py.
    - fault-analysis: carrier_v4() simulates the vehicle inputs. All pass
    except the 24 V unclamped load dump, for which a P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
    [hour-meter-esp32-v4-B_Cu.gbl, hour-meter-esp32-v4-B_Mask.gbs, hour-meter-esp32-v4-B_Silkscreen.gbo, hour-meter-esp32-v4-Edge_Cuts.gm1, hour-meter-esp32-v4-F_Cu.gtl, hour-meter-esp32-v4-F_Mask.gts, hour-meter-esp32-v4-F_Silkscreen.gto, hour-meter-esp32-v4-NPTH.drl]
2026-11-02 feat(pcb): add CAN and RS232 ports to the Micro-Fit board
    - schematic/hour-meter-board-microfit-can/: a copy of the Micro-Fit board
    with a TJA1051T/3 CAN port (TX GPIO33, RX GPIO15, termination and
    listen-only jumpers) and a MAX13223E RS232 port in place of the TTL
    UART. J1 grows to a Micro-Fit 2 x 8 whose neighbouring pins can short
    without damage; one SZNUP3105L protects RS485.
    - Re-laid out module by module on 100 x 100 mm, 2 layers (MODULES in
    tools-pcb.py), routed with signals on top and a GND pour below.
    DRC clean, JLCPCB order files in production/.
    - Includes the hand edits made in KiCad on 2026-11-02. The IMU is
    turned 270 degrees, which turns its axes; the README's Lay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
    [BOM-hour-meter-board-microfit-can.csv, can.kicad_sch, eeprom-at24c256.kicad_sch, esp32-core.kicad_sch, harness.kicad_sch, hour-meter-board-microfit-can.kicad_pcb, hour-meter-board-microfit-can.kicad_sch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]
2026-11-02 feat(pcb): add an unrouted copy of the CAN board for hand routing
    - schematic/hour-meter-board-microfit-can-handroute/: a KiCad Save-As
    style copy of the CAN board (same schematic and placement, 152 parts,
    141 nets) with every track and via removed and the GND pours unfilled.
    - One KiCad group per module (MODULES in the CAN board's tools-pcb.py),
    holding the module's silkscreen title; the IMU group also holds the
    IMU keep-outs, so they move with the chips.
    - Net classes, rules and keep-outs as on the routed board; the README
    lists each group's parts and the routing rules.
    [can.kicad_sch, eeprom-at24c256.kicad_sch, esp32-core.kicad_sch, harness.kicad_sch, hour-meter-board-microfit-can-handroute.kicad_pcb, hour-meter-board-microfit-can-handroute.kicad_sch, imu.kicad_sch, io.kicad_sch]
2026-11-02 chore(pcb): re-save the rev A carrier project in KiCad 10
    - KiCad 10 writes its teardrop and net-colour defaults into the
    project file. No design change.
2026-11-04 feat(pcb): audit the hand-routed CAN board and add its order files
    - schematic/hour-meter-board-microfit-can-handroute/: the schematic is
    redrawn as a block diagram plus 17 module sheets, one per PCB group.
    Same parts and nets; the old sheets are replaced.
    - Audit of the hand routing: DRC and JLCPCB rules clean. Four fixes:
    wider supply tracks with the buck's feedback divider beside U101, the
    ESP32's reset and decoupling capacitors beside its pins, the RS485
    and CAN protectors and AIN1's front end moved next to J1, and GND
    stitching vias (258). Includes the hand edits made in KiCad on
    2026-11-04.
    - BRINGUP.md: first power-on and module checks, with the voltages and
    currents t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
    [BOM-hour-meter-board-microfit-can-handroute.csv, ain1-adc.kicad_sch, ain1-front-end.kicad_sch, buck-5v.kicad_sch, can.kicad_sch, din-inputs.kicad_sch, dout1.kicad_sch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]
2026-11-04 feat(pcb): add the module carrier rev D with a GY-271 compass
    - schematic/hour-meter-esp32-v4-compass/: a copy of rev C on an
    88 x 91 mm board. A 20 mm strip along the bottom holds a GY-271
    compass socket (M5: QMC5883L at 0x0D or HMC5883L at 0x1E), 40 mm
    from the DevKit and 38 mm from the RTC's coin cell. Rev C is
    unchanged.
    - Hand-edited in KiCad after Freerouting: parts moved, 3V3 re-routed
    at 0.8 mm, GND carried by the pours, H2 removed. The audit moved two
    dimension lines off copper, restored the GND pour's 3.8 mm gap to
    the vehicle zone and moved R1's label. DRC clean.
    - production/: Gerbers, the local-shop BOM, a 1:1 fit-check PDF, and
    an LCSC upload list for 5 boards (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
    [hour-meter-esp32-v4-compass-B_Cu.gbl, hour-meter-esp32-v4-compass-B_Mask.gbs, hour-meter-esp32-v4-compass-B_Silkscreen.gbo, hour-meter-esp32-v4-compass-Edge_Cuts.gm1, hour-meter-esp32-v4-compass-F_Cu.gtl, hour-meter-esp32-v4-compass-F_Mask.gts, hour-meter-esp32-v4-compass-F_Silkscreen.gto, hour-meter-esp32-v4-compass-NPTH.drl]
2026-11-04 refactor(pcb): re-draw the rev D +3V3 track and rebuild its order files
    - The +3V3 track beside the vehicle zone was re-drawn 0.4 mm closer to
    it after the audit. It is now 4.3 mm from D1/D2's input pads (was
    4.7 mm). The closest logic copper is still the GND pour, 3.8 mm from
    J2's vehicle ground.
    - DRC: 0 errors, 0 warnings, 0 unconnected, 0 parity. The stored zone
    fills match a fresh fill.
    - 3V3 drop to the modules: 0.80 mV (was 0.79), 8.2 mV with 100 mA from
    J3. The field at the GY-271 is unchanged (0.07 uT).
    - Gerbers, drill files, fit-check PDF and pictures rebuilt with
    tools-production.py, so the order zip matches the board.
    - README: note the re-draw and the new drop figur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
    [hour-meter-esp32-v4-compass-B_Cu.gbl, hour-meter-esp32-v4-compass-B_Mask.gbs, hour-meter-esp32-v4-compass-B_Silkscreen.gbo, hour-meter-esp32-v4-compass-Edge_Cuts.gm1, hour-meter-esp32-v4-compass-F_Cu.gtl, hour-meter-esp32-v4-compass-F_Mask.gts, hour-meter-esp32-v4-compass-F_Silkscreen.gto, hour-meter-esp32-v4-compass-NPTH.drl]
2026-11-04 refactor(pcb): re-route +3V3, RS485 and UART2_RX on the CAN board
    - Saved on 2 November, right after 80dde2c. Parts of +3V3 (26
    segments), RS485_DE, RS485_RX and UART2_RX were re-routed and 6 of
    their vias moved. No footprints, zones or drawings changed.
    - DRC: 0 errors, 0 unconnected, 0 parity, and the same 5
    silkscreen-to-edge warnings as before.
    - production/ still holds the order files made before this save. The
    board to order is the hand-routed copy, which has its own.
    [hour-meter-board-microfit-can.kicad_pcb]
2026-11-04 chore(pcb): keep the CAN hand-route backups and audit scripts in git
    - backup-before-schematic-remake/: the schematic and board from before
    the sheet redraw, and the boards from before the cap moves, before
    the audit fixes and before the last hand edits.
    - audit-fixes-wip/: the audit's scripts, their results and the fixed
    board. The scripts look for the audit's work copies, which were not
    kept, so their paths need changing before they run again.
    - README: the two folders are no longer described as untracked.
    [can.kicad_sch, eeprom-at24c256.kicad_sch, esp32-core.kicad_sch, harness.kicad_sch, hour-meter-board-microfit-can-handroute.audit-fixed-before-user-edits.kicad_pcb, hour-meter-board-microfit-can-handroute.before-audit-fixes.kicad_pcb, hour-meter-board-microfit-can-handroute.before-cap-moves.kicad_pcb, hour-meter-board-microfit-can-handroute.fixed.kicad_pcb]
2026-11-04 docs(pcb): add the LIS3MDL and MAX13223E datasheets
    - schematic/datasets/: reference copies for the CAN board's LIS3MDL
    magnetometer (U602) and MAX13223E RS-232 transceiver.
2026-11-04 chore(pcb): add the order bundle of the compact LM2596 I/O board
    - production/2.hm-lmio-design.zip holds the BOM, CPL and Gerber zip
    from the same folder, byte for byte (2026-10-29).
2026-11-04 feat(firmware): add a can-board build for the main board
    - pio run -e can-board builds the same firmware with the main board's
    pins and IMU mounting. platformio.ini sets HM_BOARD per environment
    (esp32dev and bench 0, can-board 1); BoardPins.h reads it once into
    constexpr values, so both boards' values compile in every build. A
    build without HM_BOARD stops with an error. CODING-STANDARD rule 8
    now names this one build setting.
    - UART link: the main board's RS232 port (GPIO32 TX, GPIO34 RX). Its
    GPIO16/17 belong to the GPS socket, where GPIO17 is the GPS output,
    so the can-board build leaves them alone.
    - IMU axes: ChipRotation and toBoardAxes() in Vec3.h; the Mpu9250
    driver t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
    [Application.cpp, BoardPins.h, test_main.cpp]
2026-11-04 refactor(pcb): keep only the main board and the devboard
    - The hand-routed CAN board becomes the main board,
    schematic/hour-meter-board, and rev D of the module carrier becomes
    schematic/hour-meter-devboard.
    - Removed: rev B and its 2-layer, compact, LM2596, I/O and Micro-Fit
    versions, the auto-routed CAN board, the rev A and rev C carriers,
    PSU-B and the early draft. They stay in the history at d35ef2d.
    - The renames include the (project ...) instances, sheetfile and
    .kicad_pro entries, so the annotation is kept. Netlist, ERC and DRC
    are the same as before; BOM and CPL are byte-identical, and the
    Gerbers differ only in names, dates and the name-derived project ID.
    - The main b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
    [BOM-hour-meter-board-2layer.csv, BOM-hour-meter-board-compact-lm2596-io.csv, BOM-hour-meter-board-compact-lm2596.csv, BOM-hour-meter-board-compact.csv, BOM-hour-meter-board-microfit-can-handroute.csv, BOM-hour-meter-board-microfit-can.csv, BOM-hour-meter-board-microfit.csv, BOM-hour-meter-board.csv]
